HemangVora/OpenDuck/docs/amazon-list.md

# Open Duck Mini v2 — single Amazon.in list (replaces the local shopping trip)

All 33 listings checked live on **2026-11-02** with the delivery location set to **Mumbai 400076** (price, stock and delivery date). "Fastest" dates need the order placed the same evening and an Amazon-dispatched cart over ₹499. Prices include GST. Items marked *optional* are tools you may already own or Tier-3 extras.

Not in this list because they are already in the Hubtronics cart or already owned: capacitors, 2 mm and 4 mm heat-shrink, JST-XH 4-pin leads, flush cutter, SG90 servos, XY-3606 5 V buck, soldering iron, solder wire, microSD.

| # | Item | Qty | Link | Unit ₹ | Delivery | Note |
|---|---|---|---|---|---|---|
| 1 | Samsung 30Q 18650 cells (3 needed, 4 = matched set) | 4 | https://www.amazon.in/dp/B0HL8CRN1P | 489 | 7 Nov | Flat-top, unprotected. Check all 4 read within 0.05 V on arrival |
| 2 | 3S 40 A BMS with balance, same-port | 1 | https://www.amazon.in/dp/B0BJVPGDQ8 | 259 | 4 Nov (fastest 3 Nov) | Electronic Spices. Pads B-, B1, B2, B+, P- |
| 3 | iMax B6AC 80 W balance charger | 1 | https://www.amazon.in/dp/B07BRM5FCN | 2,469 | 8 Nov | Robocraze listing. Needs the 3S balance lead below |
| 4 | LiPo/Li-ion voltage alarm 1–8S | 1 | https://www.amazon.in/dp/B0F678VRR4 | 220 | 10 Nov | Set 3.5 V/cell warning |
| 5 | 18650 insulating rings + base mat | 1 | https://www.amazon.in/dp/B0CPSMC43L | 159 | 4 Nov (fastest 3 Nov) | Pack build safety |
| 6 | Inline mini-blade fuse holder + 5× 15 A fuses | 1 | https://www.amazon.in/dp/B0B7GPVB4X | 245 | 7 Nov | Wire ≥ 16 AWG |
| 7 | Toggle switch 12 V 20 A DC with safety cover | 1 | https://www.amazon.in/dp/B0B3Y229LV | 284 | 7 Nov | DC rated, the point of this one |
| 8 | XT30 connector pair, Robodo (buy 3 pairs) | 3 | https://www.amazon.in/dp/B0DWXRDJ3L | 131 | 4 Nov | Swapped 2 Nov: the 5-pair pack B0FTVN486X had 2 left and a 14 Nov date for 400076 |
| 9 | 16 AWG silicone wire, 1 m red + 1 m black | 1 | https://www.amazon.in/dp/B09CB833B7 | 420 | 7 Nov | Pack links, BMS to switch |
| 10 | 18 AWG silicone wire, 3 m red + 3 m black (INVENTO) | 1 | https://www.amazon.in/dp/B09VLCZNXN | 378 | 7 Nov | Swapped 2 Nov: B0HMWWMMGW was non-FBA, ₹80 delivery, 10 Nov for 400076 |
| 11 | 22 AWG hookup wire, 5 colours × 2 m | 1 | https://www.amazon.in/dp/B09D4RCKG8 | 170 | 10 Nov | IMU, foot switches, 5 V to Radxa |
| 12 | JST-XH 2.54 mm connector kit, 560 pcs | 1 | https://www.amazon.in/dp/B0FVLRZC6L | 599 | 6 Nov (fastest 4 Nov) | 2/3/4/5/6-pin housings + pins |
| 13 | JST-XH 3S balance lead, 20 cm, 22 AWG | 1 | https://www.amazon.in/dp/B0CV9JDKZ7 | 269 | 6 Nov | Pack to charger balance port |
| 14 | Heat-shrink assortment, 560 pcs, 2:1 | 1 | https://www.amazon.in/dp/B0DZXD1YLK | 311 | 6 Nov (fastest 5 Nov) | Covers 8–10 mm for XT30; Hubtronics cart has only 2 and 4 mm |
| 15 | Kapton tape 12 mm × 33 m | 1 | https://www.amazon.in/dp/B0DQYJ7569 | 139 | 7 Nov | IMU mount, insulation |
| 16 | 3M double-sided foam attachment tape | 1 | https://www.amazon.in/dp/B07WZRSYJM | 231 | 4–8 Nov | IMU and buck module |
| 17 | Nylon cable ties 100 × 2.5 mm, black | 1 | https://www.amazon.in/dp/B08GKPWLB9 | 79 | 10 Nov | Servo cable routing in the legs |
| 18 | FTDI FT232RL USB to TTL (3.3 V jumper) | 1 | https://www.amazon.in/dp/B072NDZL9K | 229 | 4 Nov (fastest 3 Nov) | Configure servos from the Mac. Set jumper to 3.3 V |
| 19 | M3 × 5 mm brass heat-set inserts, 100 pcs | 1 | https://www.amazon.in/dp/B0DZ8B7FW1 | 345 | 11 Nov | Ø4.0 holes. Local shops never have these |
| 20 | M3 socket-head screw kit, 600 pcs, 6–20 mm | 1 | https://www.amazon.in/dp/B0H7P7L5YS | 629 | 7 Nov | 12.9 black alloy |
| 21 | M3 nyloc nuts, 25 pcs, 304 SS | 1 | https://www.amazon.in/dp/B0GS6QRJZQ | 249 | 7 Nov |  |
| 22 | M2.5 × 8 mm socket screws + nuts + washers, 10 pcs | 1 | https://www.amazon.in/dp/B0FBX87PFZ | 180 | 7 Nov | Pick the M2.5x8mm variant on the page. Radxa mount; use the nuts as spacers |
| 23 | 6804ZZ bearing 20×32×7, 2-pack (need 3) | 2 | https://www.amazon.in/dp/B071HL4RLN | 299 | 7 Nov | ONLY 2 PACKS LEFT on 2 Nov. Order first |
| 24 | Loctite 243 blue, 50 ml (genuine Henkel) | 1 | https://www.amazon.in/dp/B014MMG3AM | 627 | 6 Nov (fastest 3 Nov) | Blue only, never red 271 |
| 25 | Hex key set 1.5–6 mm, Deli DL3080 | 1 | https://www.amazon.in/dp/B0D948XF49 | 209 | 10 Nov | Needs 1.5, 2.0, 2.5 mm |
| 26 | Needle file set, 6 pcs with handle | 1 | https://www.amazon.in/dp/B07TBRR4K3 | 436 | 6 Nov (fastest 5 Nov) | Print edges, foot switch slots. Alt: deburring kit B0H45JPKYB ₹350 |
| 27 | Desoldering wick 2 mm × 1.5 m | 1 | https://www.amazon.in/dp/B07C4QD77P | 269 | 10 Nov |  |
| 28 | Precision screwdriver set 27-in-1, Themisto | 1 | https://www.amazon.in/dp/B07NY2WXPH | 249 | 4 Nov (fastest 3 Nov) |  |
| 29 | ESD tweezers set, 6 pcs (HASTHIP) | 1 | https://www.amazon.in/dp/B0BDYG14V6 | 272 | 4 Nov (fastest 3 Nov) | Price from search results, not re-checked on the product page |
| 30 | *Digital vernier calliper 150 mm (Vinabo)* (optional) | 1 | https://www.amazon.in/dp/B0BDLX8DWG | 399 | 6 Nov (fastest 5 Nov) | Skip if you own one. Check Ø4.0 insert holes and first print |
| 31 | *Digital multimeter Themisto TH-M98, 10 A DC* (optional) | 1 | https://www.amazon.in/dp/B097RS212G | 712 | 6 Nov (fastest 3 Nov) | Skip if you own one. Needed to set the buck and check pack polarity |
| 32 | *M2.5 brass standoffs 5 + 6 mm, 20 pcs (YOKIVE)* (optional) | 1 | https://www.amazon.in/dp/B0BK9CG9S4 | 332 | 10 Nov | Only if you want the Radxa lifted on proper standoffs; slow delivery |
| 33 | *INA226 current/voltage monitor* (optional) | 1 | https://www.amazon.in/dp/B0D2DPY2SB | 426 | 7 Nov | Tier 3: real walking-current data, software low-battery cutoff |

**Core total (items 1–29): ₹12,873.** Optional items 30–33 add ₹1,869. Everything: ₹14,742.

## Order notes

- Order the **6804ZZ bearings first**: the listing showed "Only 2 left in stock" and you need both packs.
- The 18650 cells ship by Amazon's own ground logistics; no air-shipment problem, unlike the Hubtronics parcel.
- Most items are Amazon-dispatched (FBA) with free delivery only on a ₹499+ FBA cart; one combined order clears that easily.
- On the M2.5 screw page choose the **M2.5x8mm** size; the default variant is 4 mm.
- Set the FTDI board's jumper to **3.3 V** before touching the servo adapter.
- For 400076: by 4 Nov the BMS, rings, FTDI, XT30, screwdrivers, tweezers (3 Nov if ordered the same evening); by 6 Nov JST kit, balance lead, heat-shrink, Loctite, files; by 7 Nov cells, fuse, switch, both silicone wires, Kapton, M3 kit, nyloc, M2.5, bearings; 8 Nov charger; 10 Nov alarm, 22 AWG, ties, hex keys, wick; 11 Nov inserts (last).
- Source lists: `local-shopping-list.md` (specs and counter checks still apply when the parcel arrives) and `shopping-list.md`.
