HemangVora/OpenDuck/cad/microduck/previews/body_asm_below.png

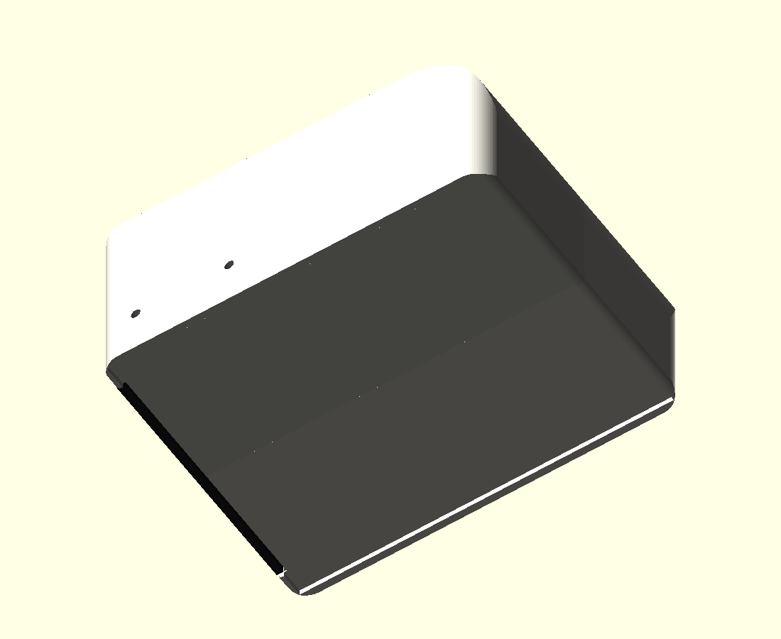
cad/microduck/previews/body_asm_below.png
