HemangVora/OpenDuck/cad/microduck/previews/body_asm_front.png

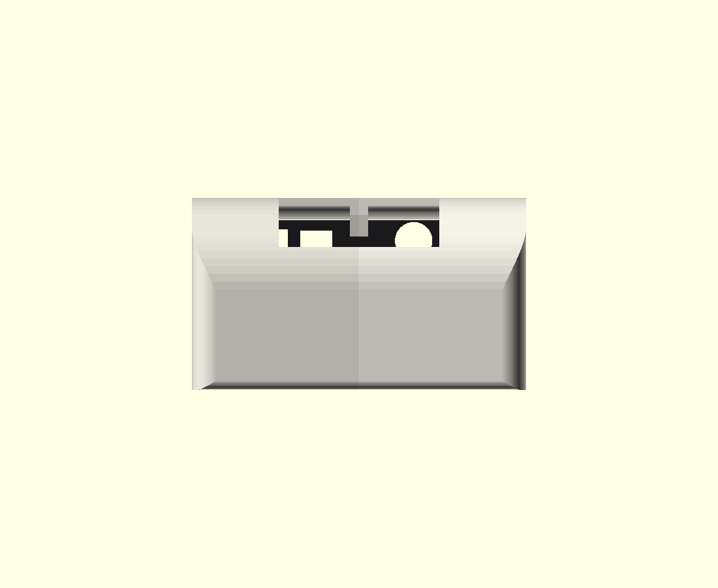
cad/microduck/previews/body_asm_front.png
