HemangVora/OpenDuck/cad/microduck/previews/body_asm_iso.png

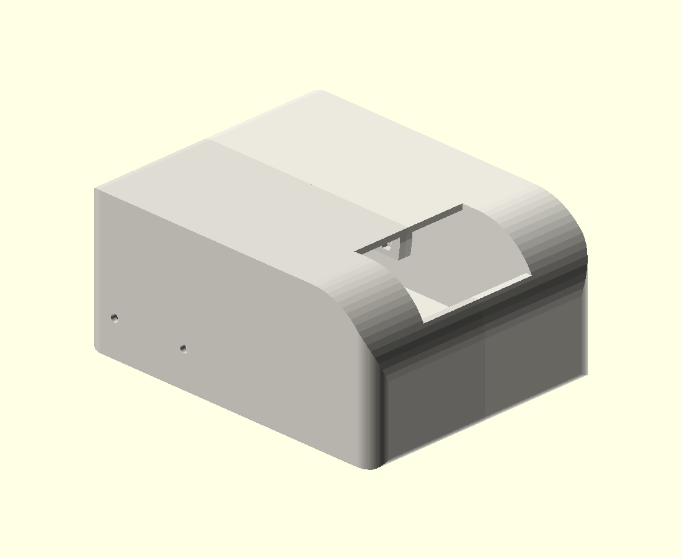
cad/microduck/previews/body_asm_iso.png
