HemangVora/OpenDuck/cad/microduck/previews/body_asm_rear.png

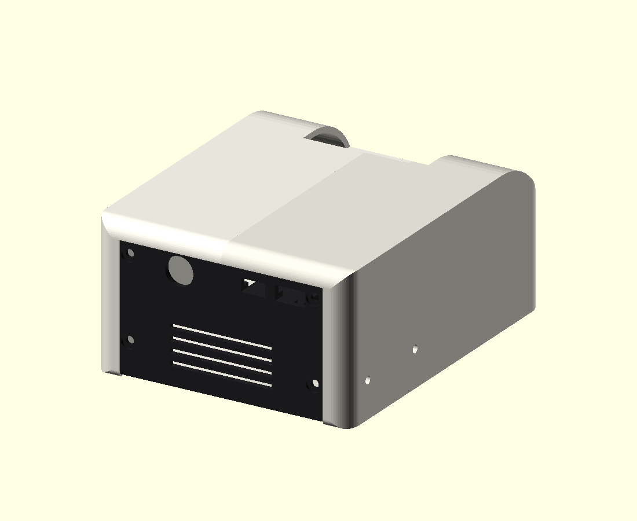
cad/microduck/previews/body_asm_rear.png
