HemangVora/OpenDuck/cad/microduck/previews/body_asm_side.png

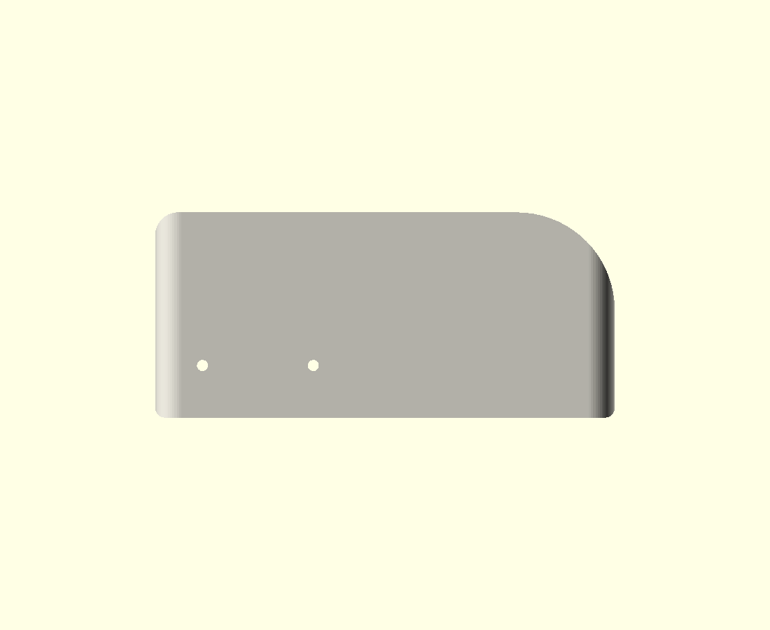
cad/microduck/previews/body_asm_side.png
