HemangVora/OpenDuck/cad/microduck/previews/body_asm_top.png

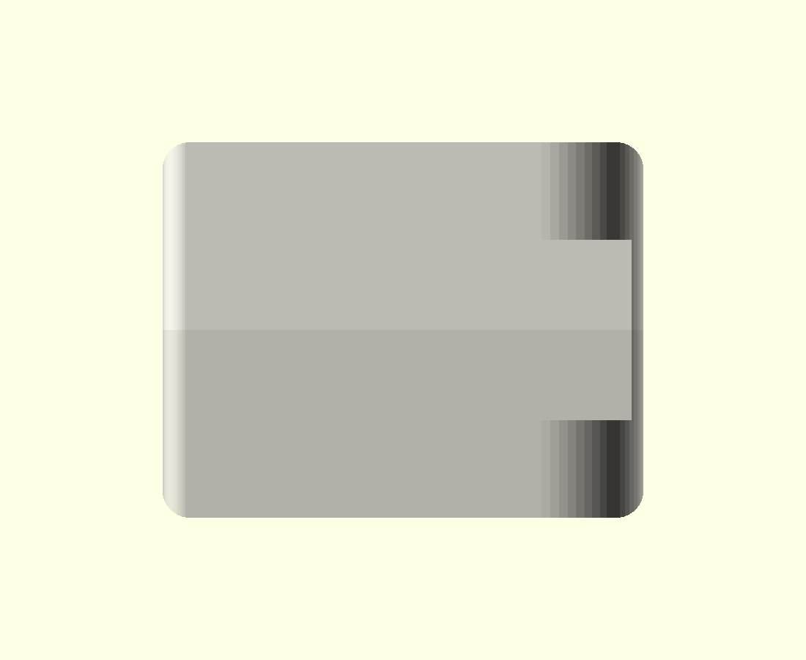
cad/microduck/previews/body_asm_top.png
