HemangVora/OpenDuck/cad/microduck/previews/body_inside_iso.png

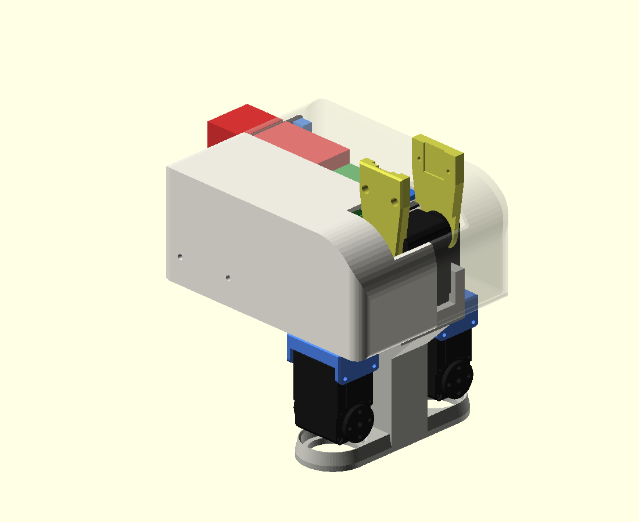
cad/microduck/previews/body_inside_iso.png
