HemangVora/OpenDuck/cad/microduck/previews/body_inside_rear.png

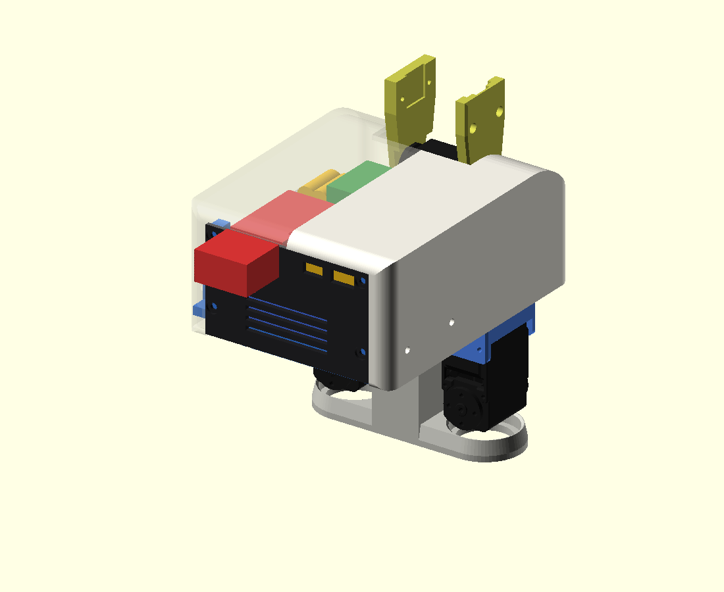
cad/microduck/previews/body_inside_rear.png
