HemangVora/OpenDuck/cad/microduck/previews/body_inside_side.png

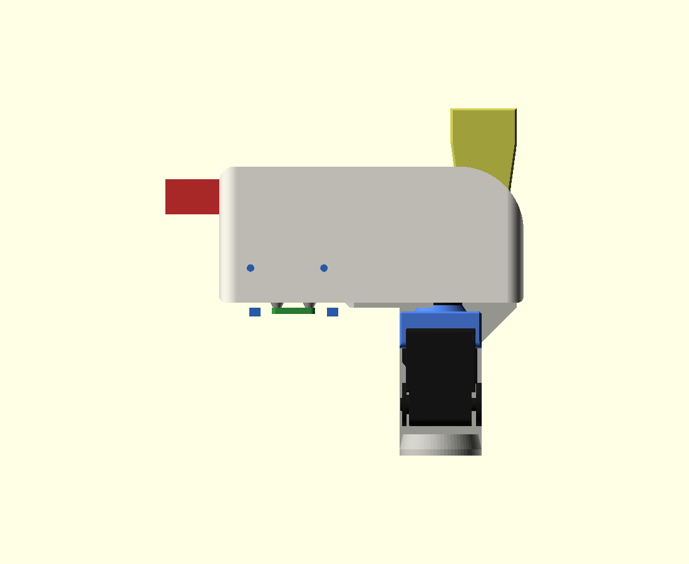
cad/microduck/previews/body_inside_side.png
