HemangVora/OpenDuck/cad/microduck/previews/body_inside_top.png

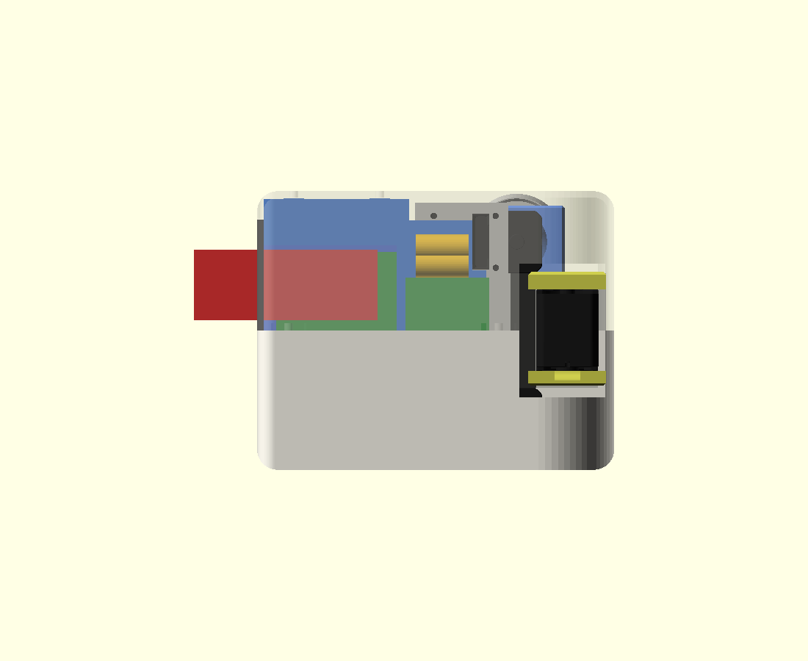
cad/microduck/previews/body_inside_top.png
