HemangVora/OpenDuck/cad/microduck/previews/chassis_below.png

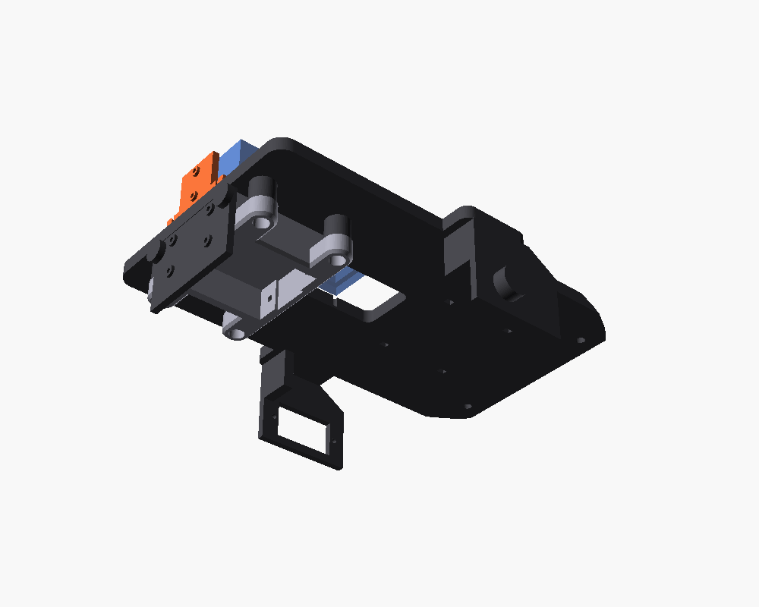
cad/microduck/previews/chassis_below.png
