HemangVora/OpenDuck/cad/microduck/previews/chassis_iso.png

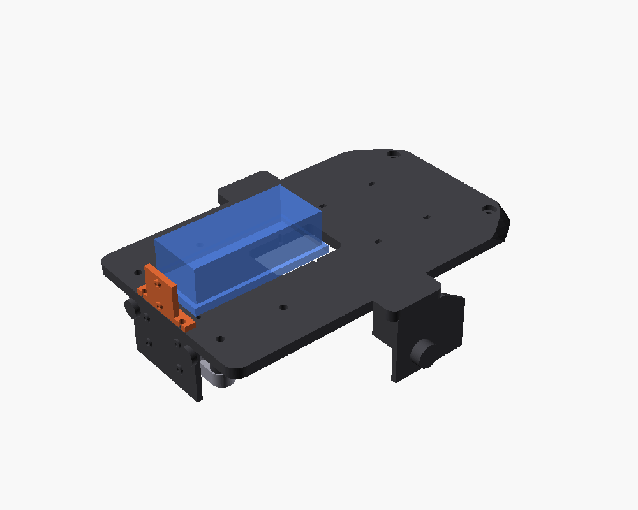
cad/microduck/previews/chassis_iso.png
