HemangVora/OpenDuck/cad/microduck/previews/compare/ours_34front.png

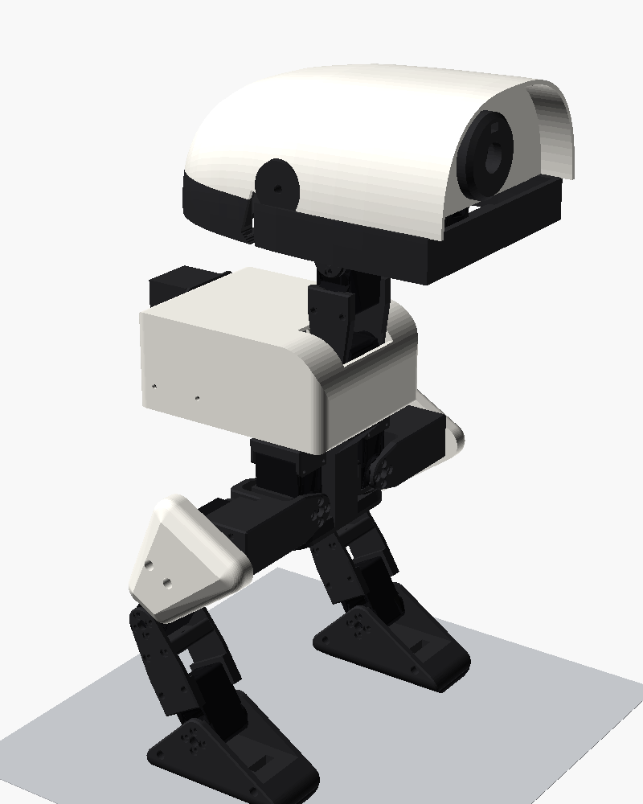
cad/microduck/previews/compare/ours_34front.png
