HemangVora/OpenDuck/cad/microduck/previews/compare/ref_34front.png

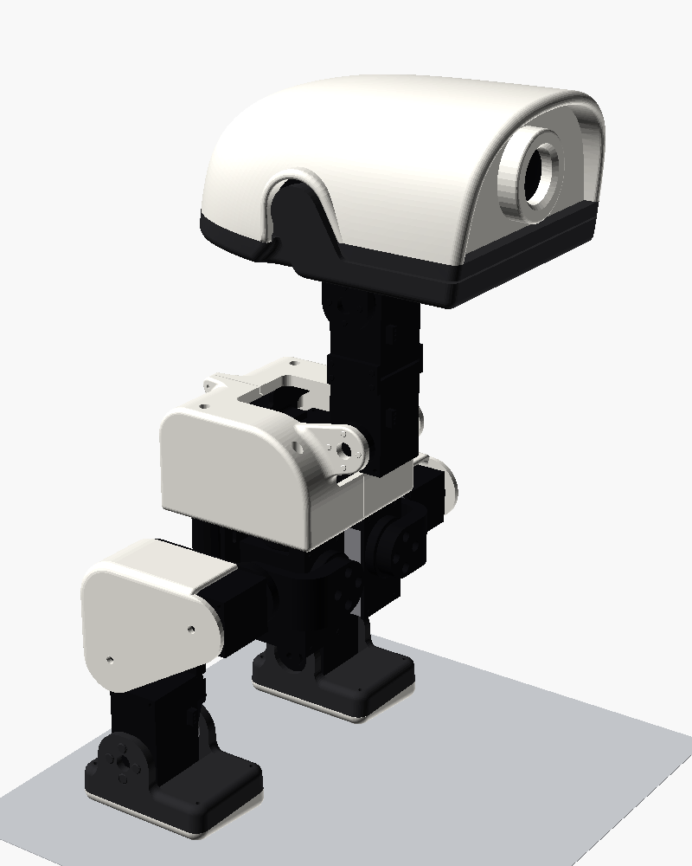
cad/microduck/previews/compare/ref_34front.png
