HemangVora/OpenDuck/cad/microduck/previews/compare/ref_side.png

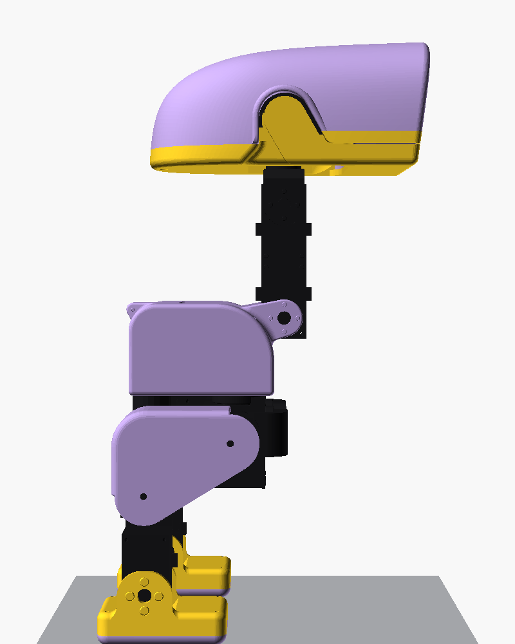
cad/microduck/previews/compare/ref_side.png
