HemangVora/OpenDuck/cad/microduck/previews/foot/md_front.png

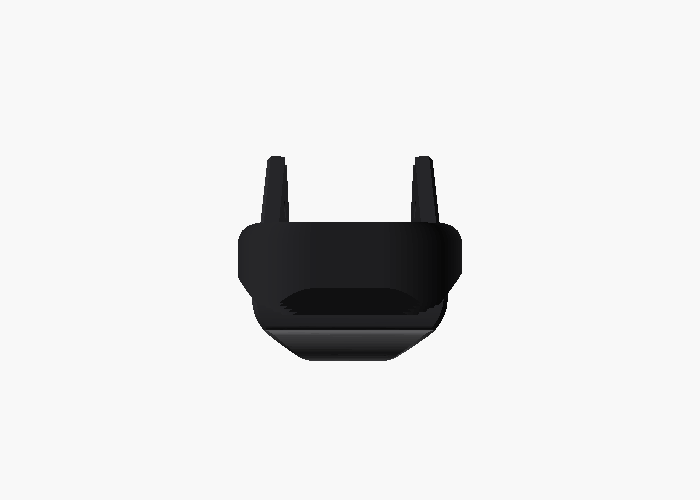
cad/microduck/previews/foot/md_front.png
