HemangVora/OpenDuck/cad/microduck/previews/foot/md_iso2.png

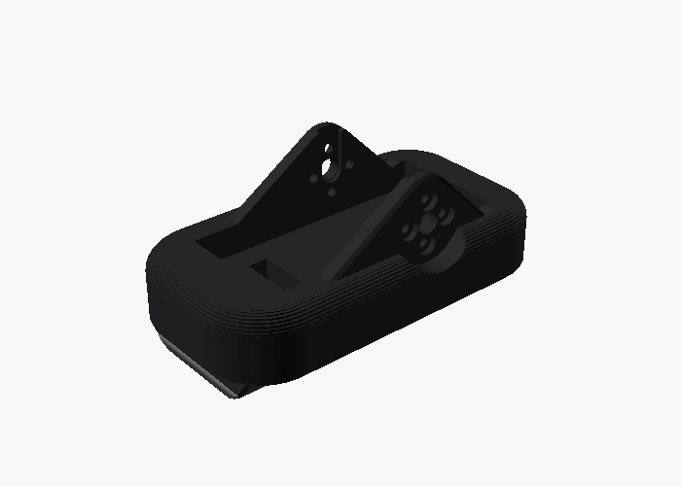
cad/microduck/previews/foot/md_iso2.png
