HemangVora/OpenDuck/cad/microduck/previews/foot/md_side.png

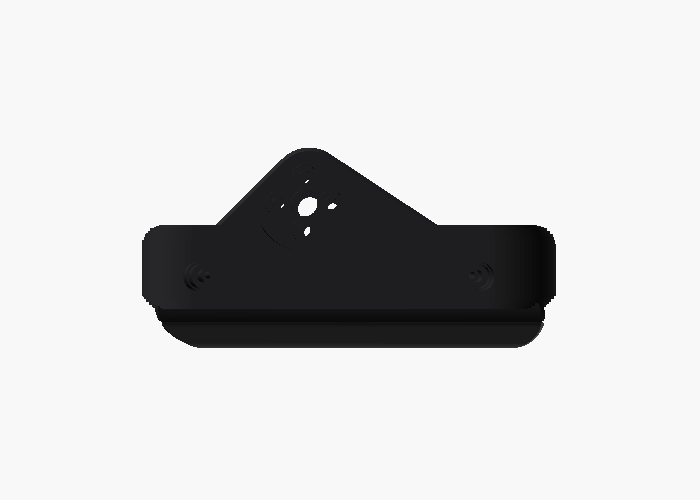
cad/microduck/previews/foot/md_side.png
