HemangVora/OpenDuck/cad/microduck/previews/foot/md_top.png

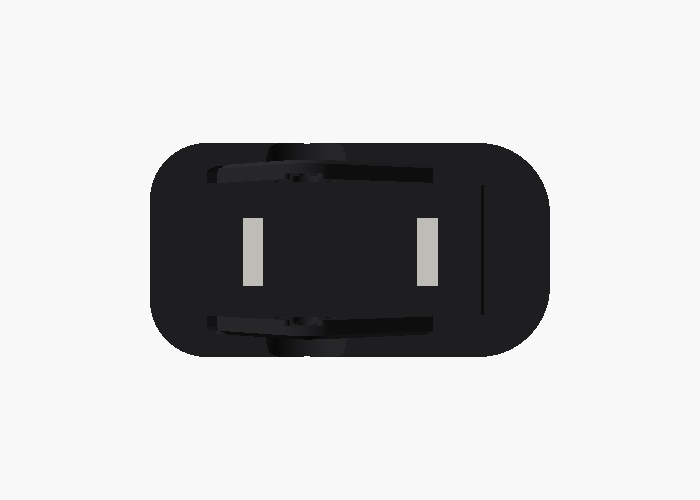
cad/microduck/previews/foot/md_top.png
