HemangVora/OpenDuck/cad/microduck/previews/foot/stock_iso2.png

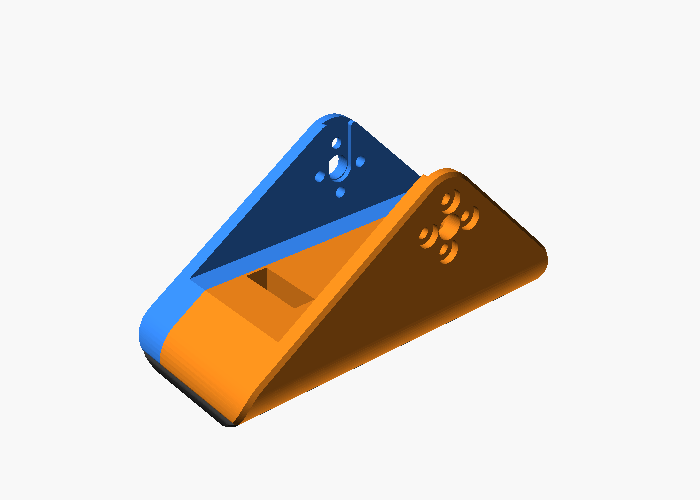
cad/microduck/previews/foot/stock_iso2.png
