HemangVora/OpenDuck/cad/microduck/previews/foot/stock_iso.png

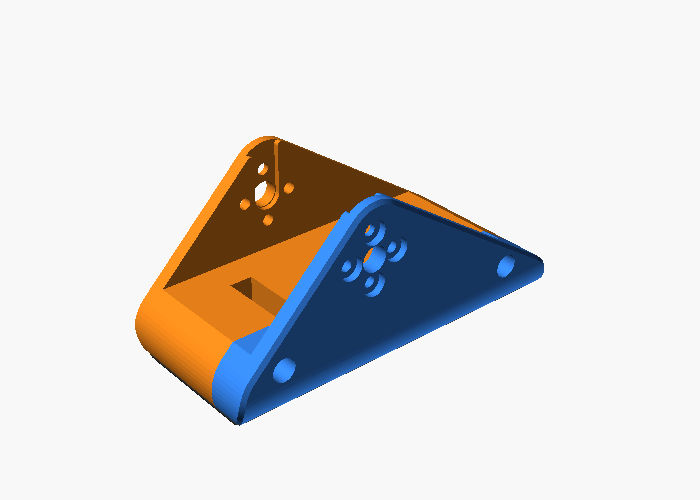
cad/microduck/previews/foot/stock_iso.png
