HemangVora/OpenDuck/cad/microduck/previews/foot/stock_side.png

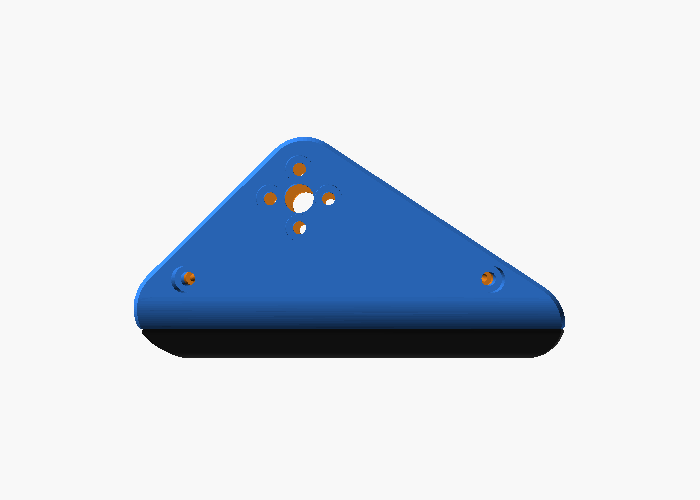
cad/microduck/previews/foot/stock_side.png
