HemangVora/OpenDuck/cad/microduck/previews/full/crouch_34front.png

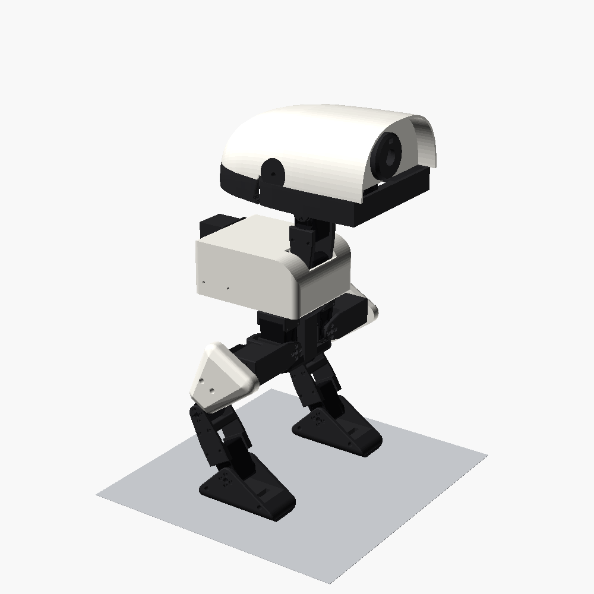
cad/microduck/previews/full/crouch_34front.png
