HemangVora/OpenDuck/cad/microduck/previews/full/crouch_34rear.png

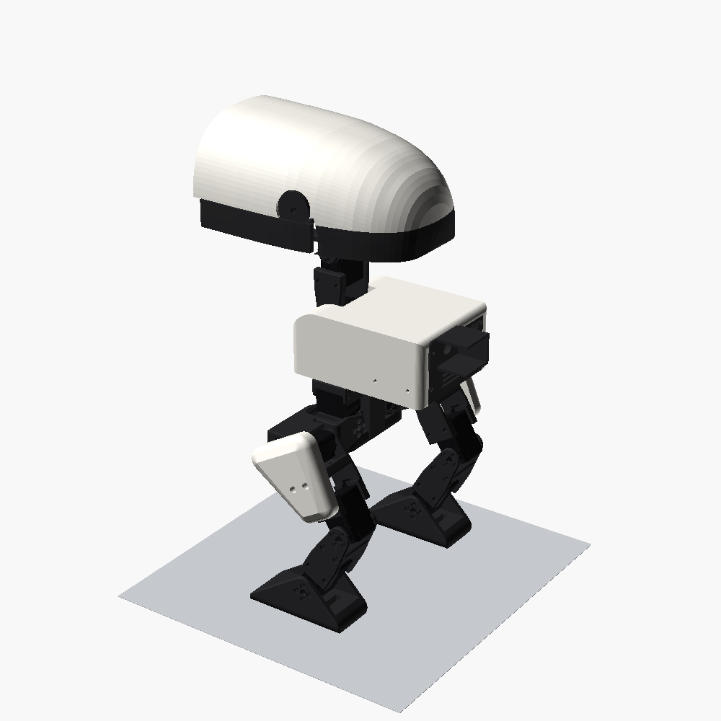
cad/microduck/previews/full/crouch_34rear.png
