HemangVora/OpenDuck/cad/microduck/previews/full/crouch_back.png

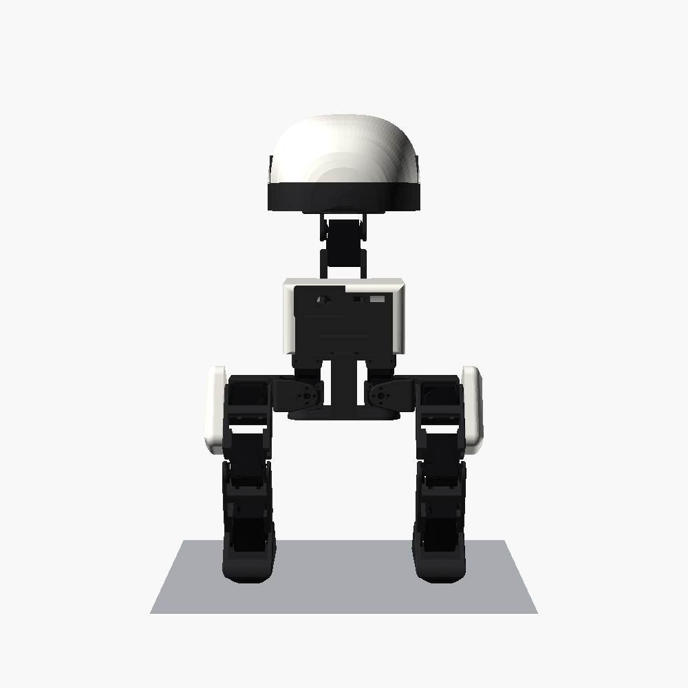
cad/microduck/previews/full/crouch_back.png
