HemangVora/OpenDuck/cad/microduck/previews/full/crouch_face_close.png

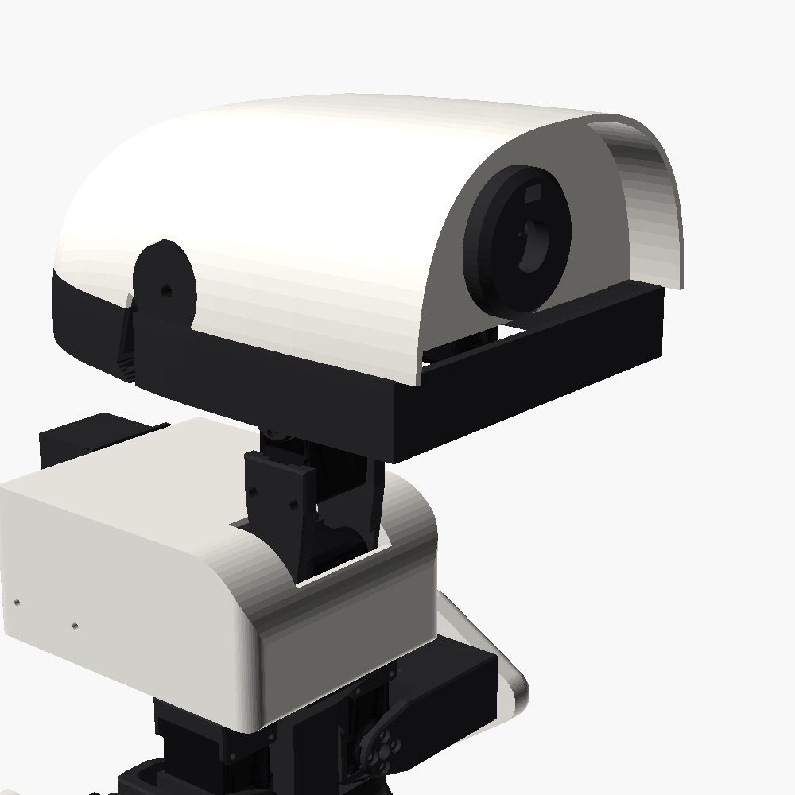
cad/microduck/previews/full/crouch_face_close.png
