HemangVora/OpenDuck/cad/microduck/previews/full/crouch_side.png

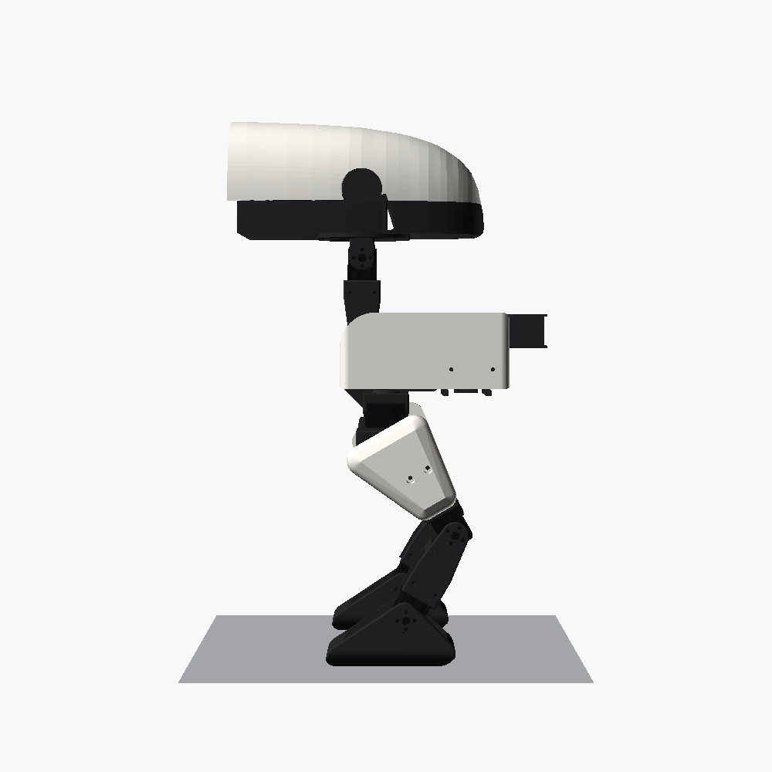
cad/microduck/previews/full/crouch_side.png
