HemangVora/OpenDuck/cad/microduck/previews/full/head_close_34.png

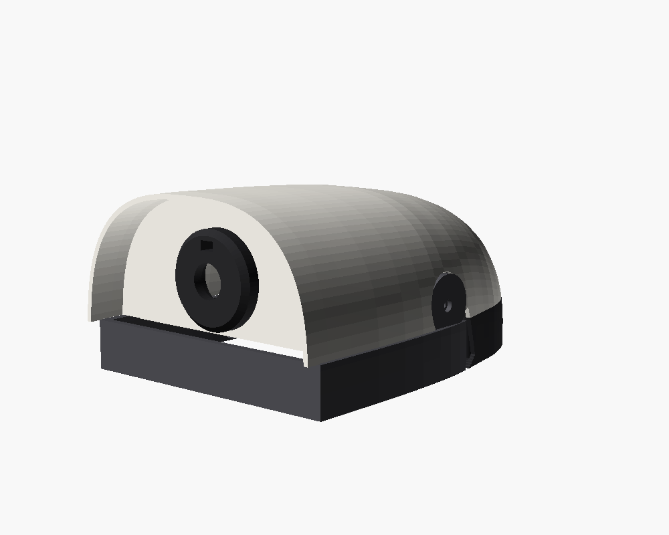
cad/microduck/previews/full/head_close_34.png
