HemangVora/OpenDuck/cad/microduck/previews/full/head_close_side.png

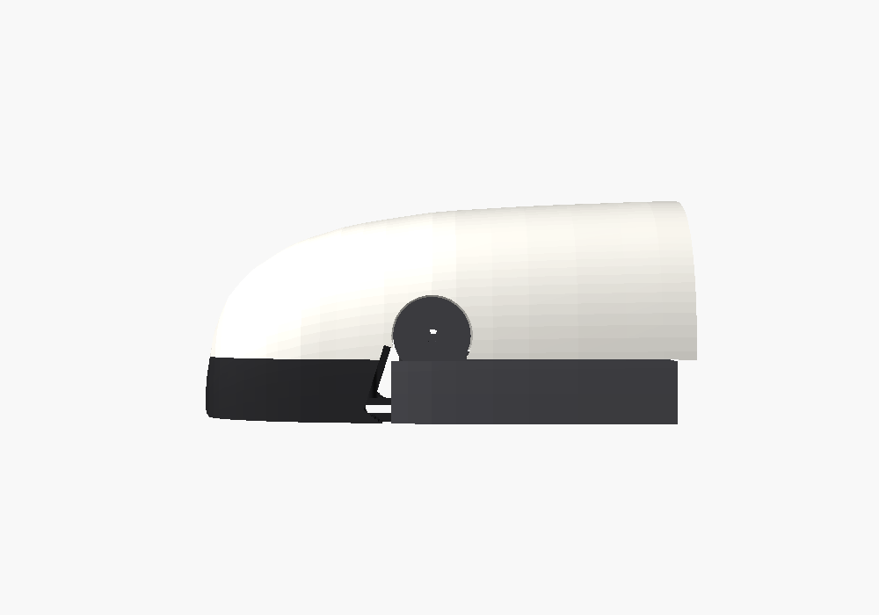
cad/microduck/previews/full/head_close_side.png
