HemangVora/OpenDuck/cad/microduck/previews/full/head_inside_check.png

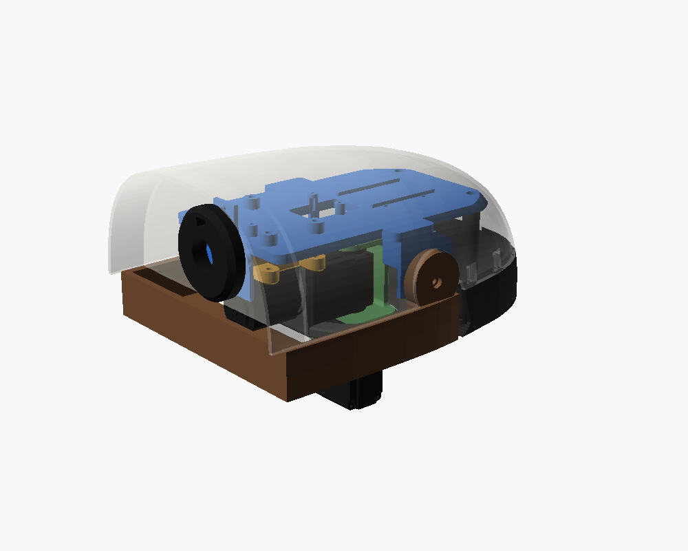
cad/microduck/previews/full/head_inside_check.png
