HemangVora/OpenDuck/cad/microduck/previews/head_asm_below.png

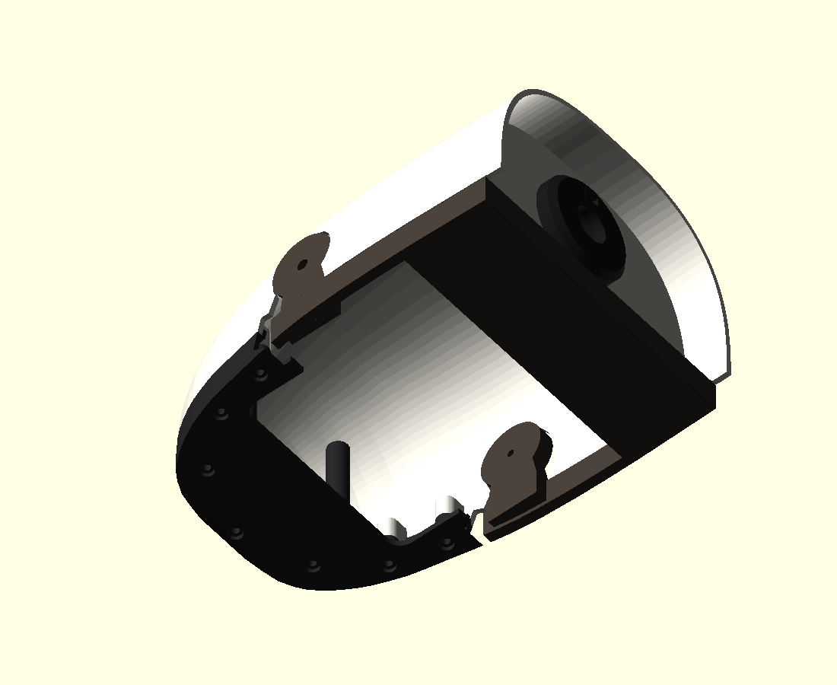
cad/microduck/previews/head_asm_below.png
