HemangVora/OpenDuck/cad/microduck/previews/head_asm_front.png

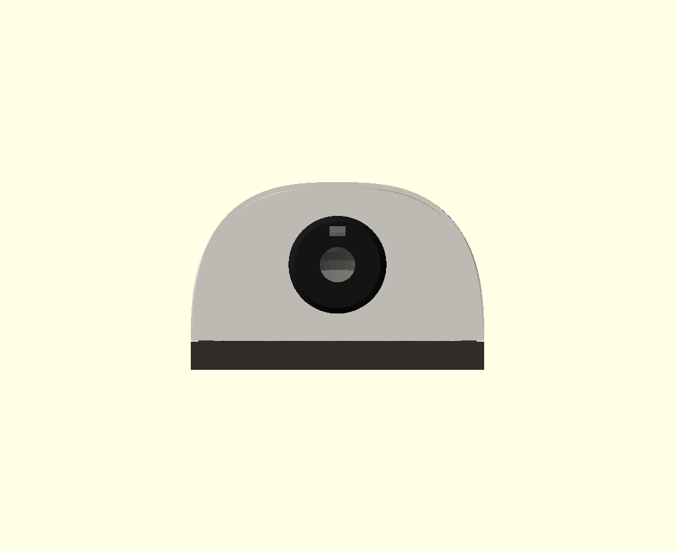
cad/microduck/previews/head_asm_front.png
