HemangVora/OpenDuck/cad/microduck/previews/head_asm_iso.png

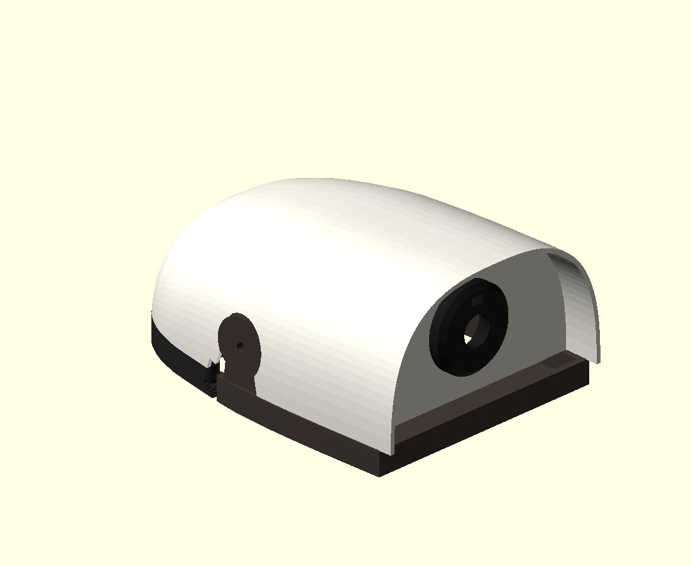
cad/microduck/previews/head_asm_iso.png
