HemangVora/OpenDuck/cad/microduck/previews/head_asm_rear.png

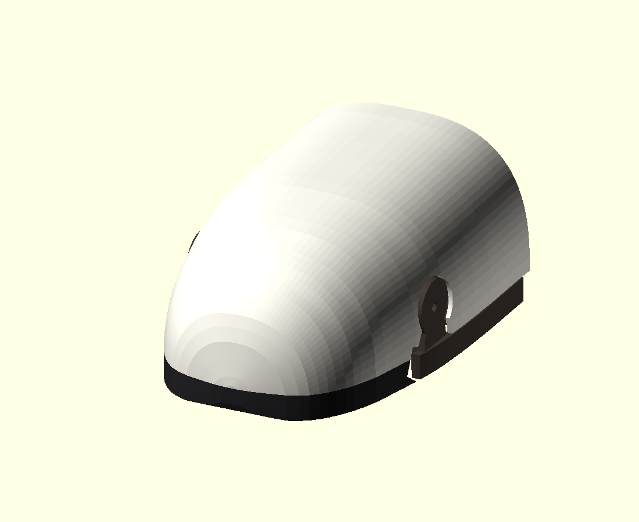
cad/microduck/previews/head_asm_rear.png
