HemangVora/OpenDuck/cad/microduck/previews/head_asm_side.png

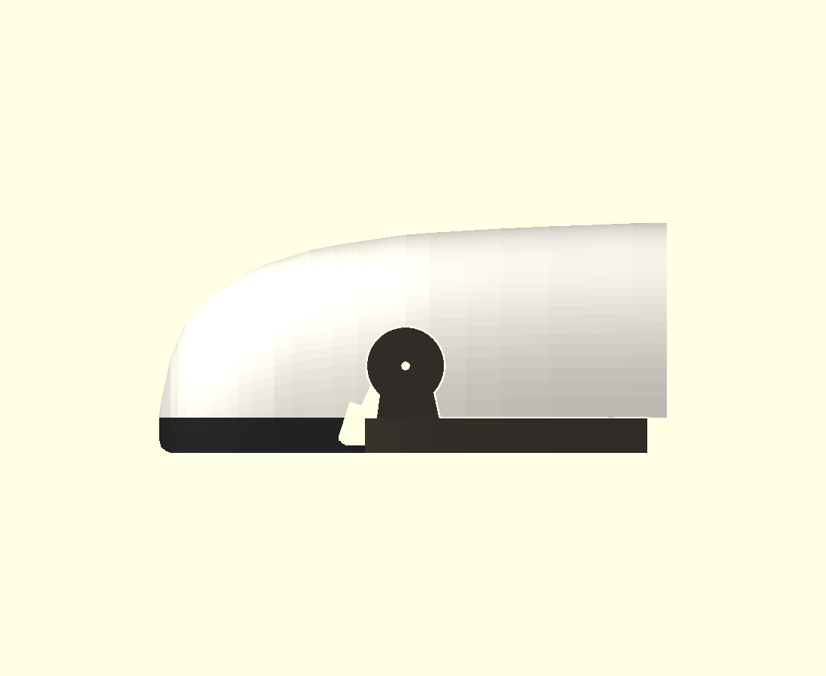
cad/microduck/previews/head_asm_side.png
