HemangVora/OpenDuck/cad/microduck/previews/head_asm_top.png

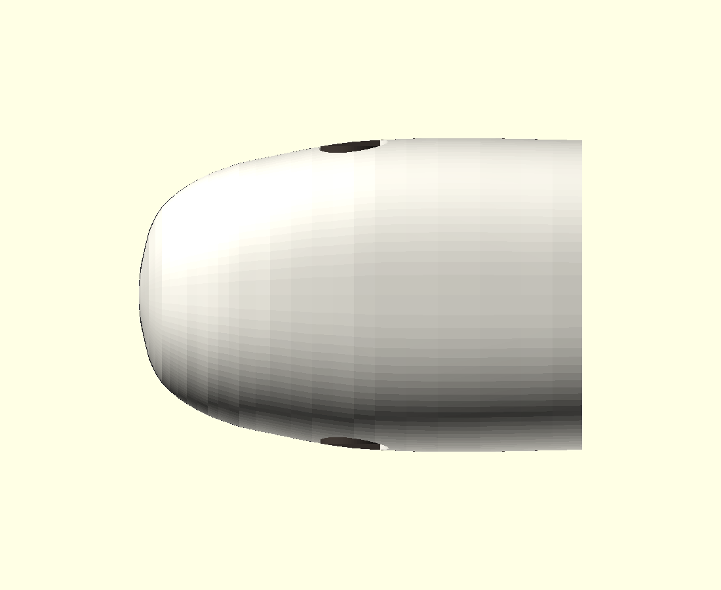
cad/microduck/previews/head_asm_top.png
