HemangVora/OpenDuck/cad/microduck/previews/head_inside_iso.png

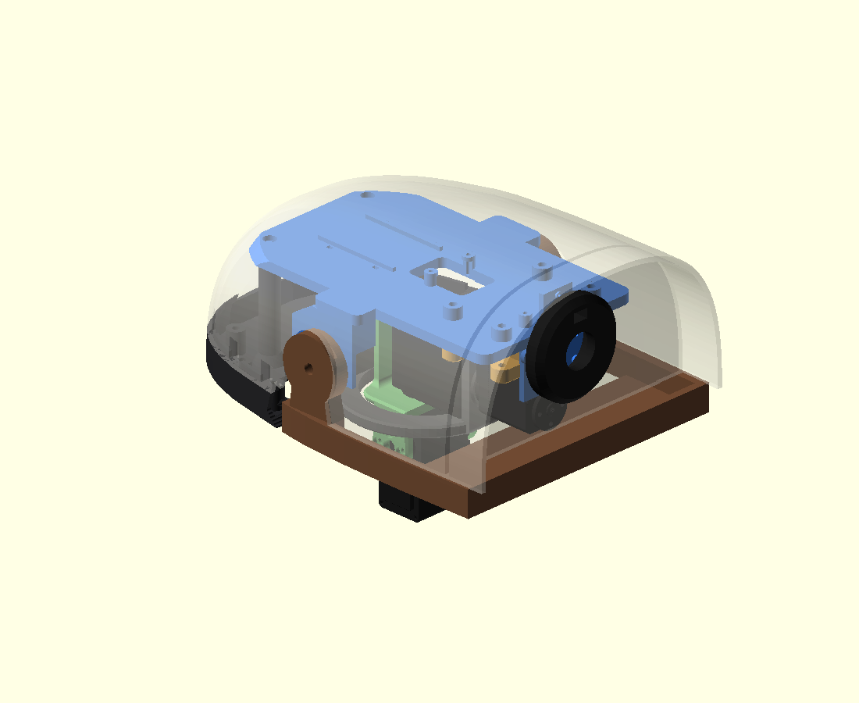
cad/microduck/previews/head_inside_iso.png
