HemangVora/OpenDuck/cad/microduck/previews/head_inside_isob.png

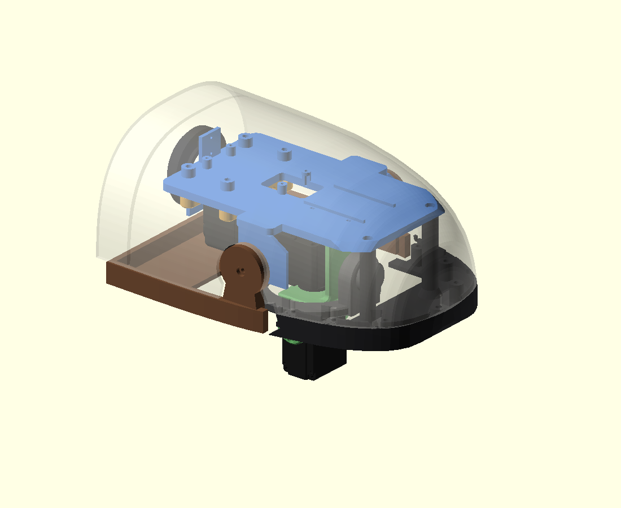
cad/microduck/previews/head_inside_isob.png
