HemangVora/OpenDuck/cad/microduck/previews/head_inside_side.png

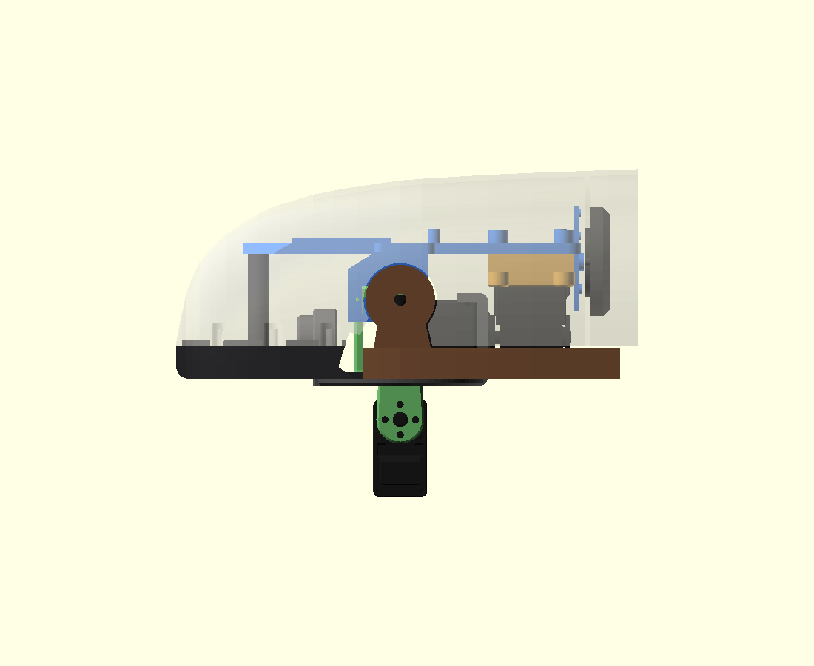
cad/microduck/previews/head_inside_side.png
