HemangVora/OpenDuck/cad/microduck/previews/leg_pillow_front.png

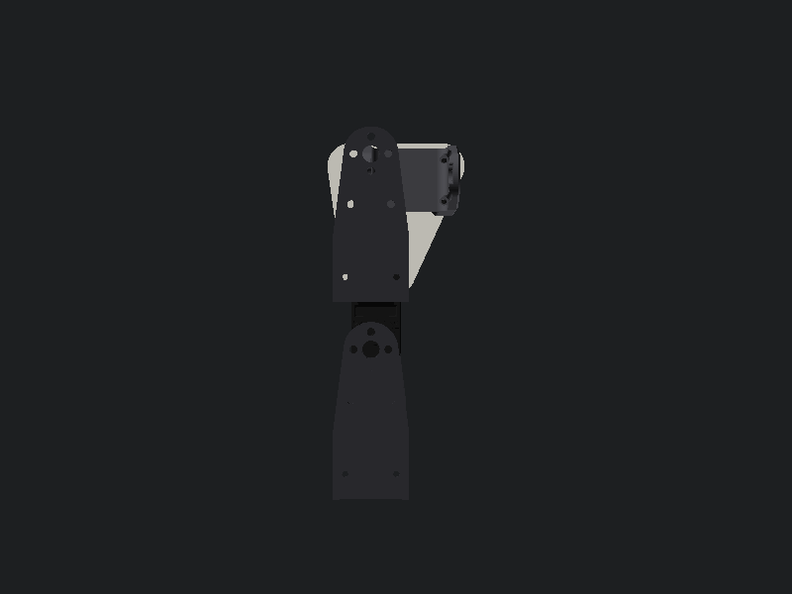
cad/microduck/previews/leg_pillow_front.png
