HemangVora/OpenDuck/cad/microduck/previews/leg_pillow_iso.png

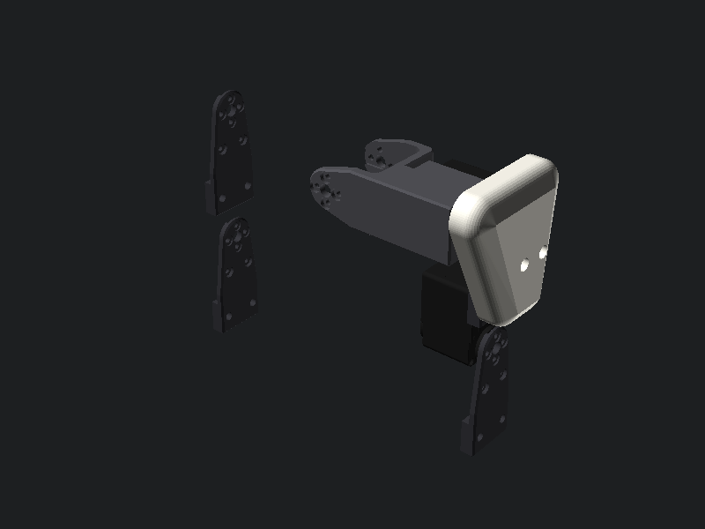
cad/microduck/previews/leg_pillow_iso.png
