HemangVora/OpenDuck/cad/microduck/previews/leg_pillow_side.png

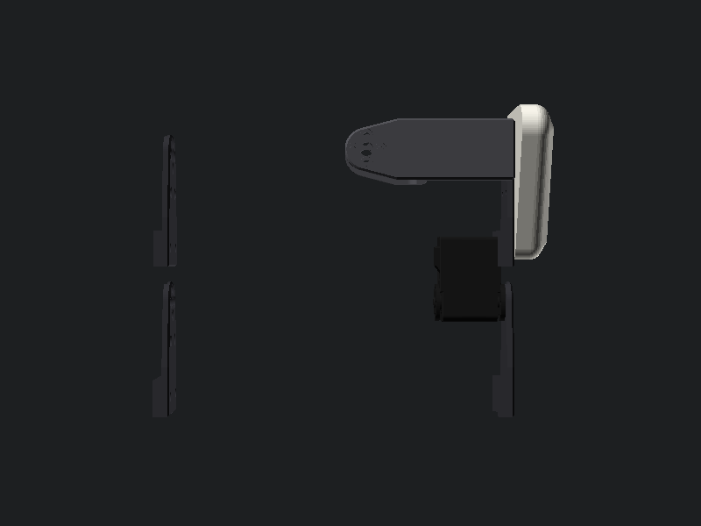
cad/microduck/previews/leg_pillow_side.png
