HemangVora/OpenDuck/cad/microduck/previews/tray_below.png

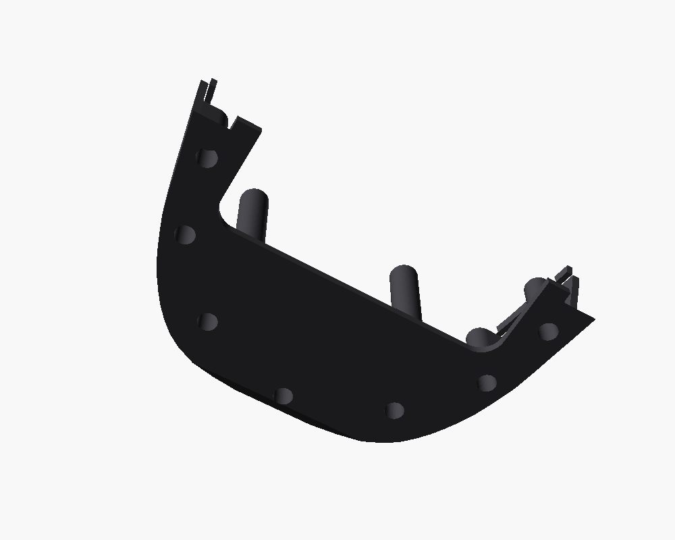
cad/microduck/previews/tray_below.png
