HemangVora/OpenDuck/cad/microduck/previews/tray_iso.png

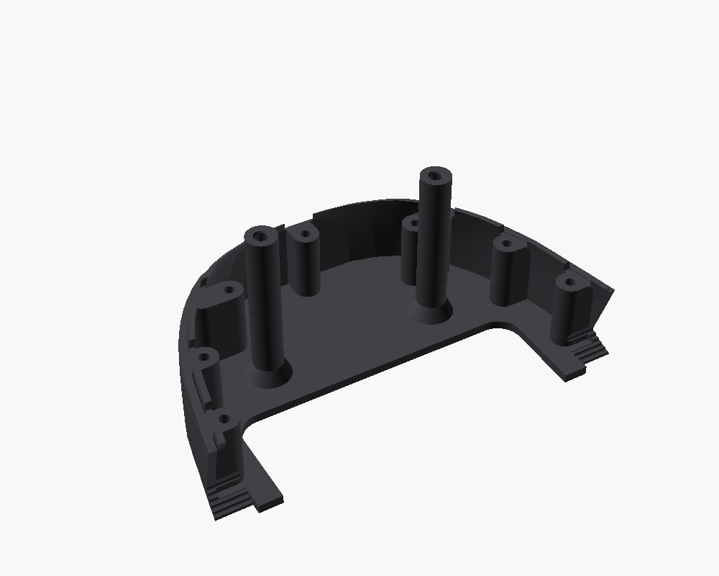
cad/microduck/previews/tray_iso.png
