HemangVora/OpenDuck/cad/microduck/previews/v3/duck_front.png

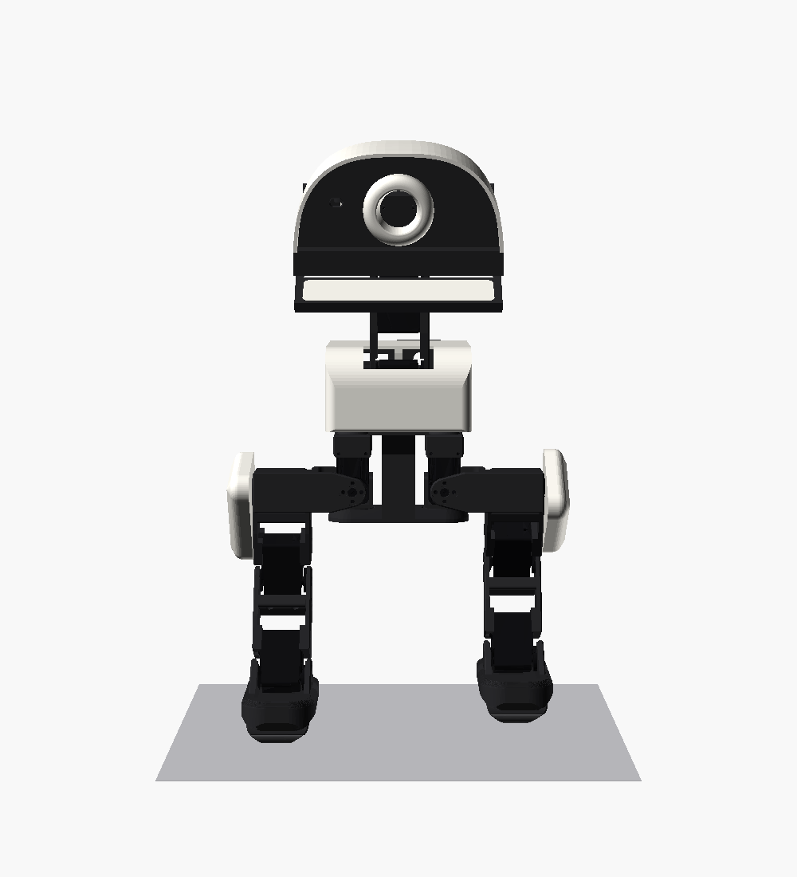
cad/microduck/previews/v3/duck_front.png
