HemangVora/OpenDuck/cad/microduck/previews/v3/duck_rear34.png

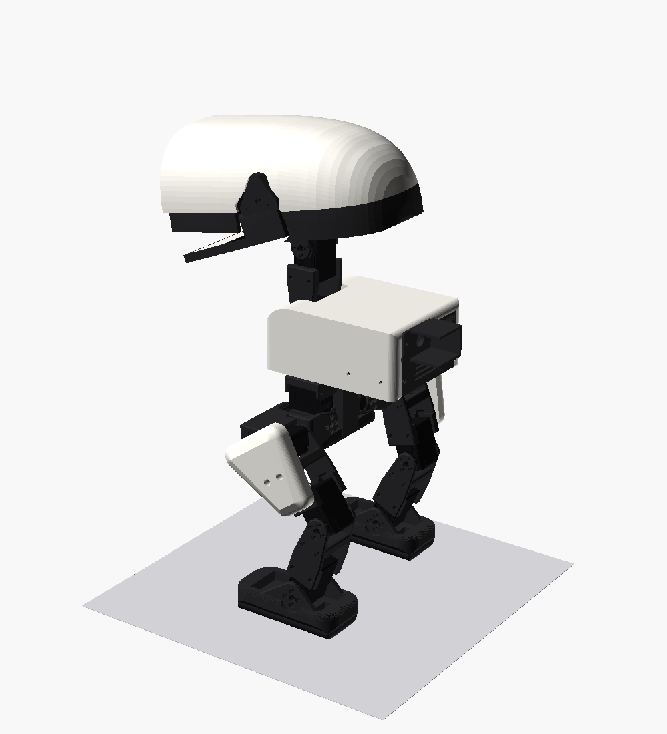
cad/microduck/previews/v3/duck_rear34.png
