HemangVora/OpenDuck/cad/microduck/previews/v3/duck_side.png

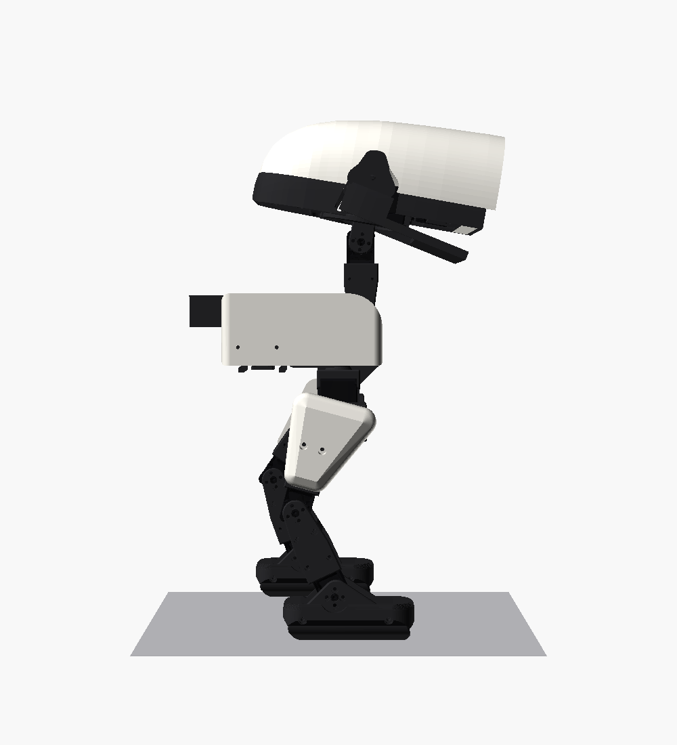
cad/microduck/previews/v3/duck_side.png
