HemangVora/OpenDuck/cad/microduck/previews/v3/head_34.png

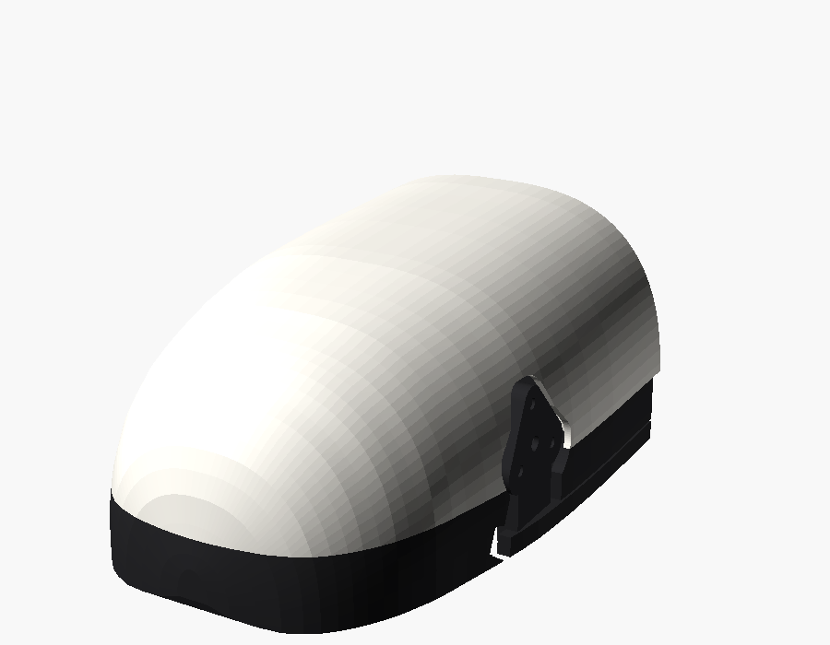
cad/microduck/previews/v3/head_34.png
