HemangVora/OpenDuck/cad/microduck/previews/v3/head_34l.png

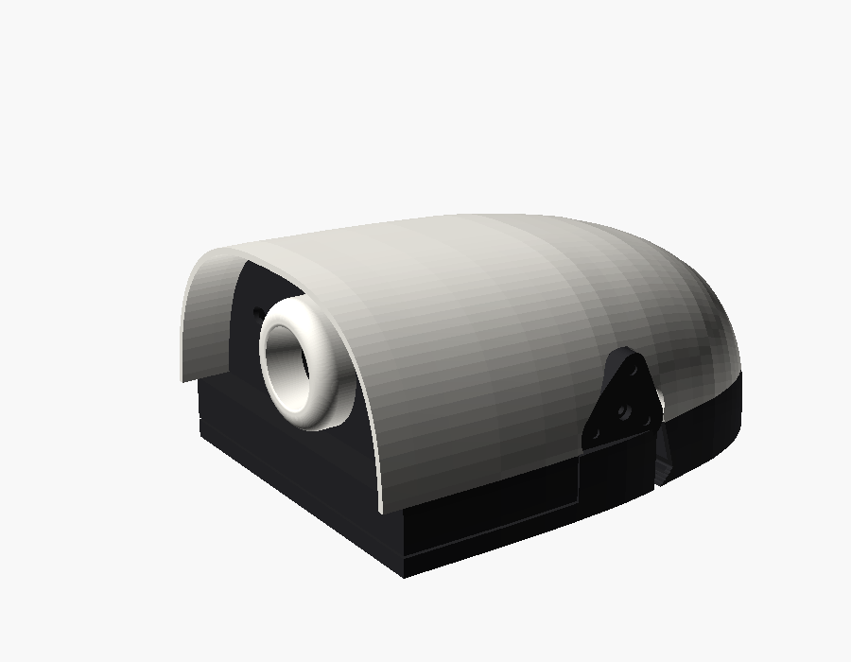
cad/microduck/previews/v3/head_34l.png
