HemangVora/OpenDuck/cad/microduck/previews/v3/head_34r.png

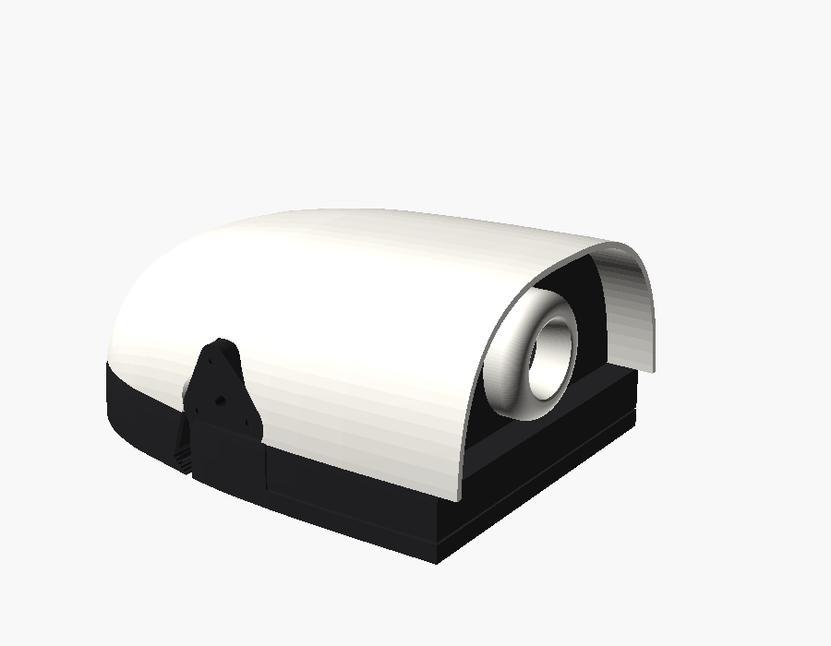
cad/microduck/previews/v3/head_34r.png
