HemangVora/OpenDuck/cad/microduck/previews/v3/head_34r_open.png

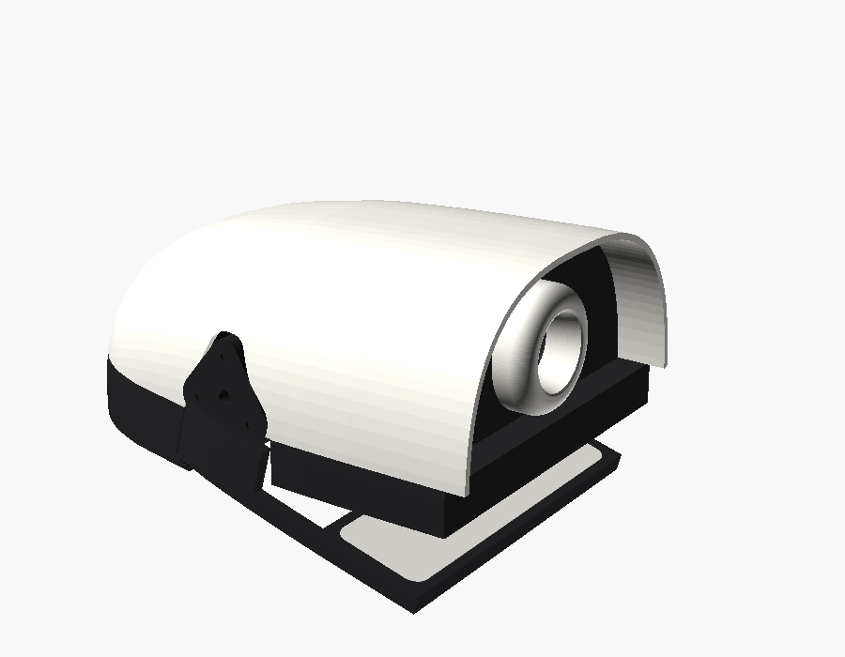
cad/microduck/previews/v3/head_34r_open.png
