HemangVora/OpenDuck/cad/microduck/previews/v3/head_front.png

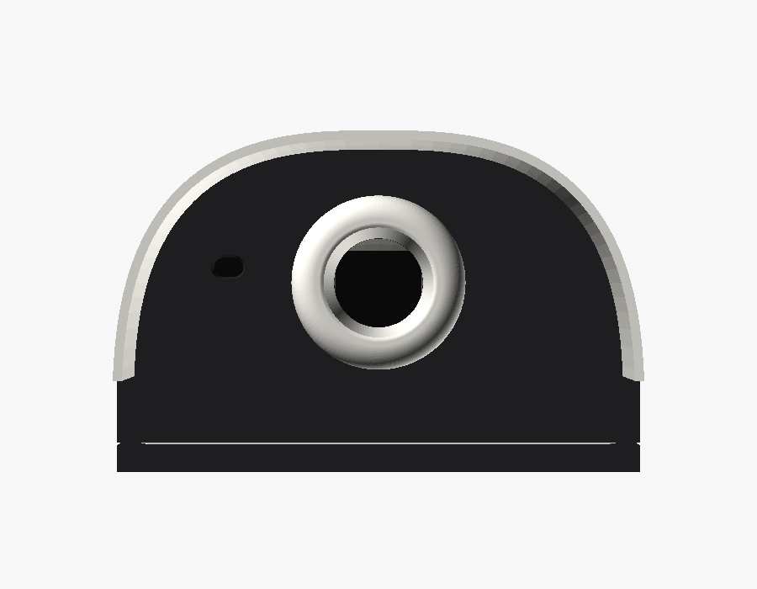
cad/microduck/previews/v3/head_front.png
