HemangVora/OpenDuck/cad/microduck/previews/v3/head_side.png

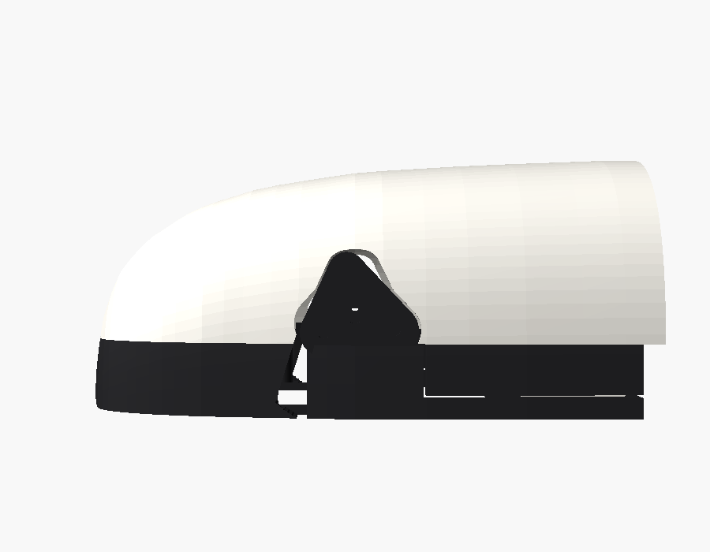
cad/microduck/previews/v3/head_side.png
