HemangVora/OpenDuck/docs/microduck_look/back_v4_inside.png

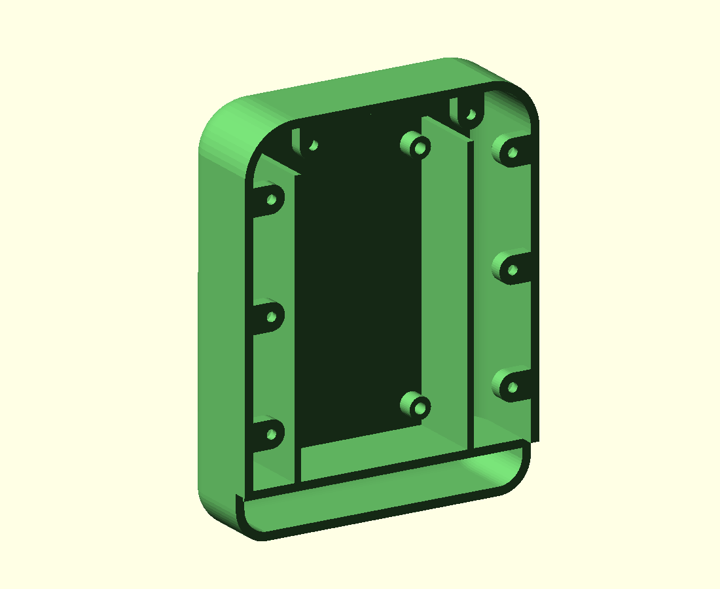
docs/microduck_look/back_v4_inside.png
