HemangVora/OpenDuck/docs/microduck_look/body_v3_back.png

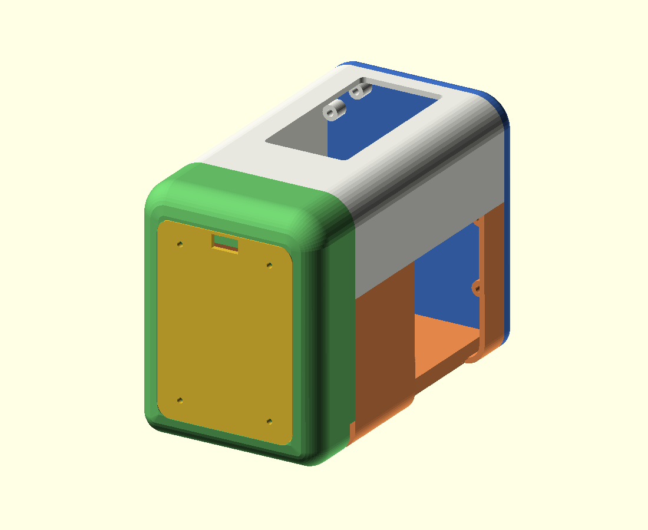
docs/microduck_look/body_v3_back.png
