HemangVora/OpenDuck/docs/microduck_look/body_v3_bottom.png

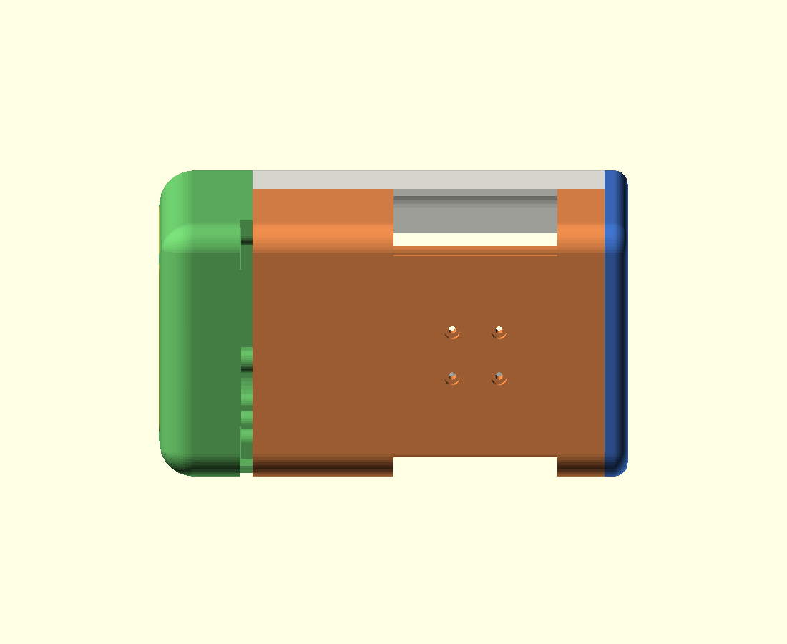
docs/microduck_look/body_v3_bottom.png
