HemangVora/OpenDuck/docs/microduck_look/body_v3_front.png

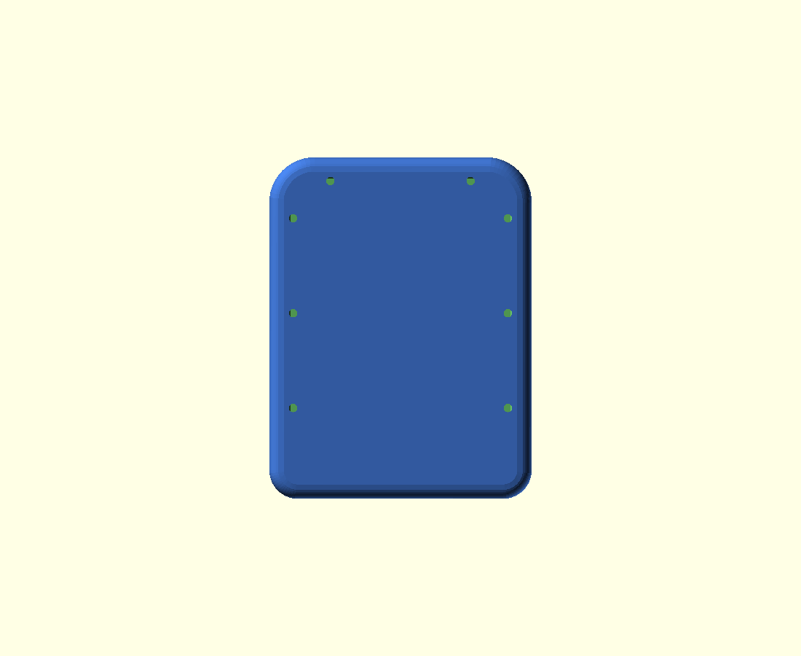
docs/microduck_look/body_v3_front.png
