HemangVora/OpenDuck/docs/microduck_look/body_v3_iso.png

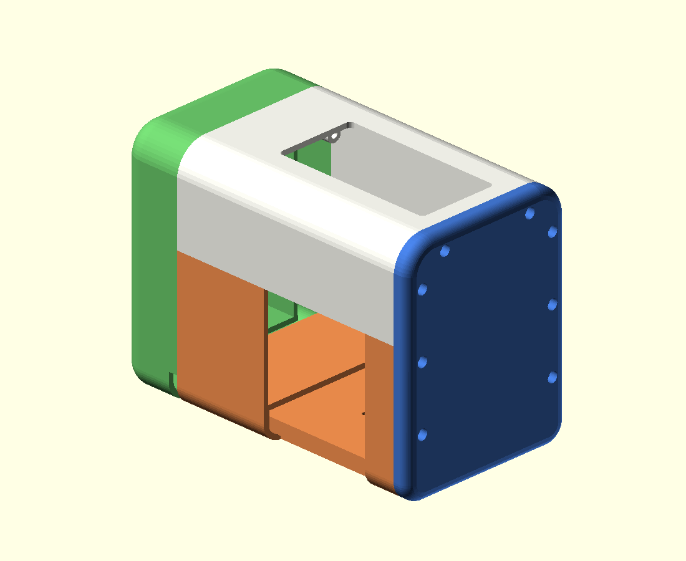
docs/microduck_look/body_v3_iso.png
