HemangVora/OpenDuck/docs/microduck_look/body_v3_side.png

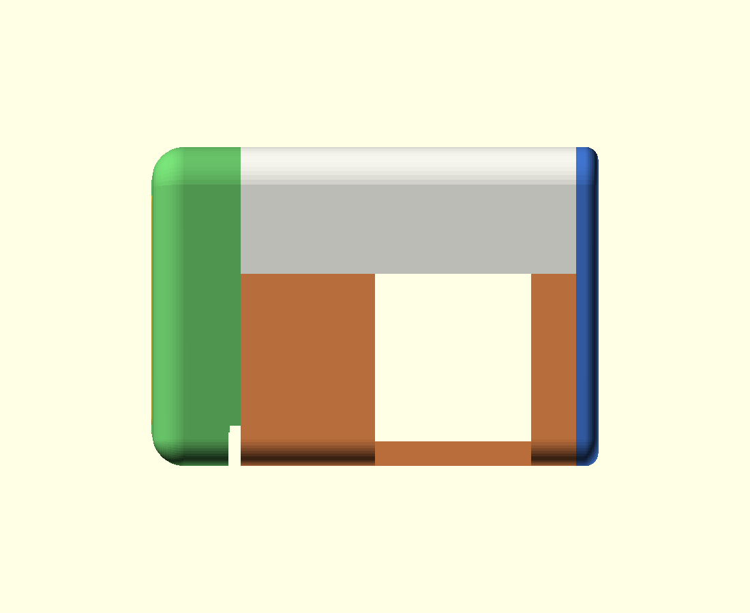
docs/microduck_look/body_v3_side.png
