HemangVora/OpenDuck/docs/microduck_look/body_v4_cut.png

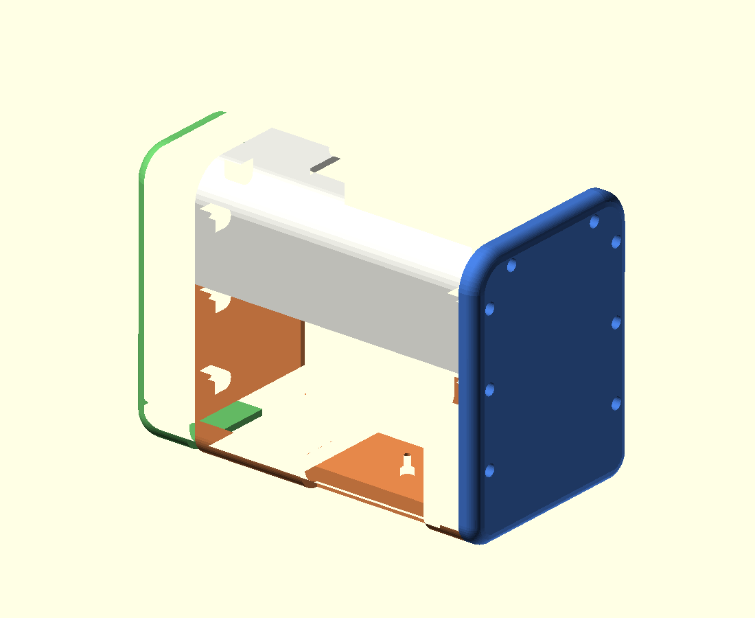
docs/microduck_look/body_v4_cut.png
