HemangVora/OpenDuck/docs/microduck_look/body_v4_inside_front.png

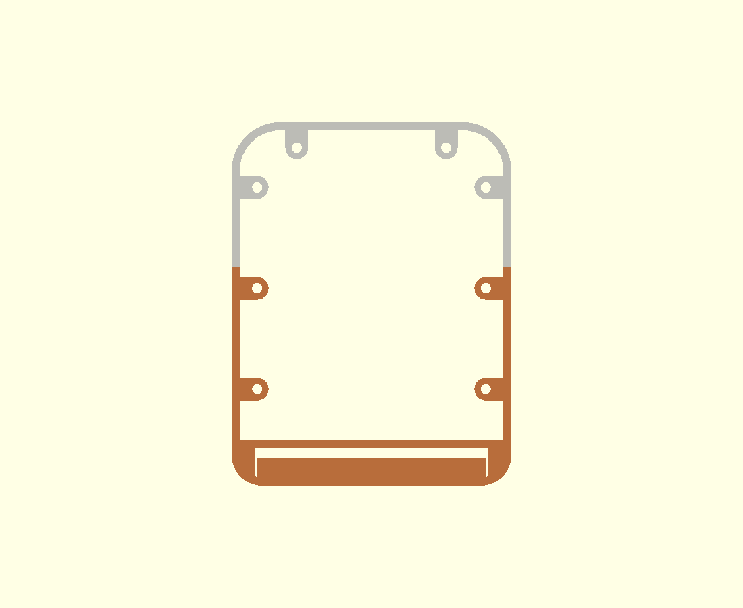
docs/microduck_look/body_v4_inside_front.png
