HemangVora/OpenDuck/docs/microduck_look/duck_full_md3_back.png

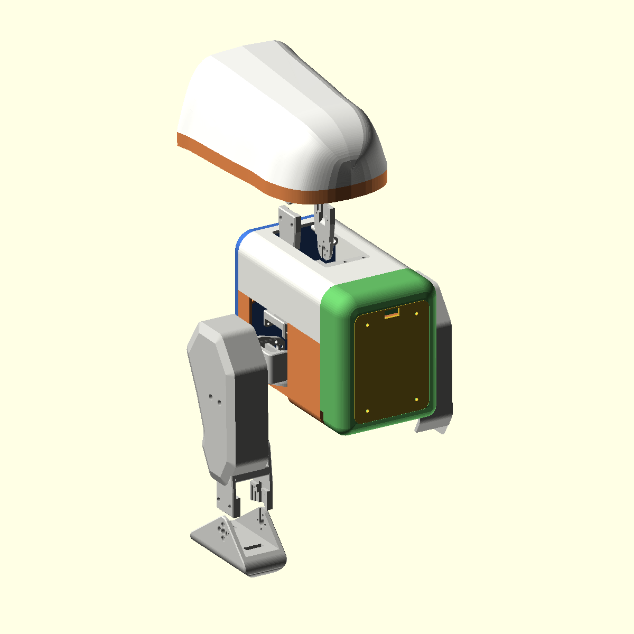
docs/microduck_look/duck_full_md3_back.png
