HemangVora/OpenDuck/docs/microduck_look/duck_full_md3_front.png

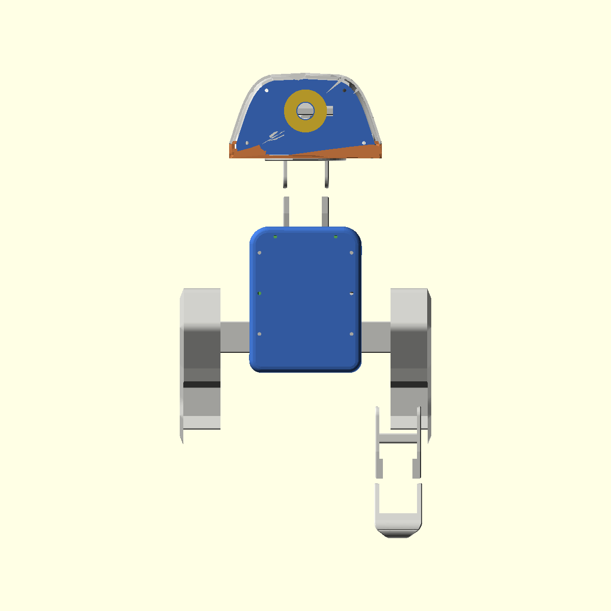
docs/microduck_look/duck_full_md3_front.png
