HemangVora/OpenDuck/docs/microduck_look/duck_full_md3_iso.png

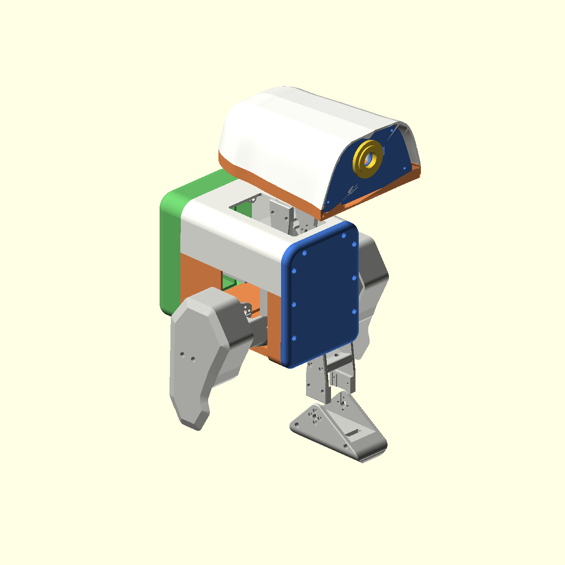
docs/microduck_look/duck_full_md3_iso.png
