HemangVora/OpenDuck/docs/microduck_look/duck_full_md3_side.png

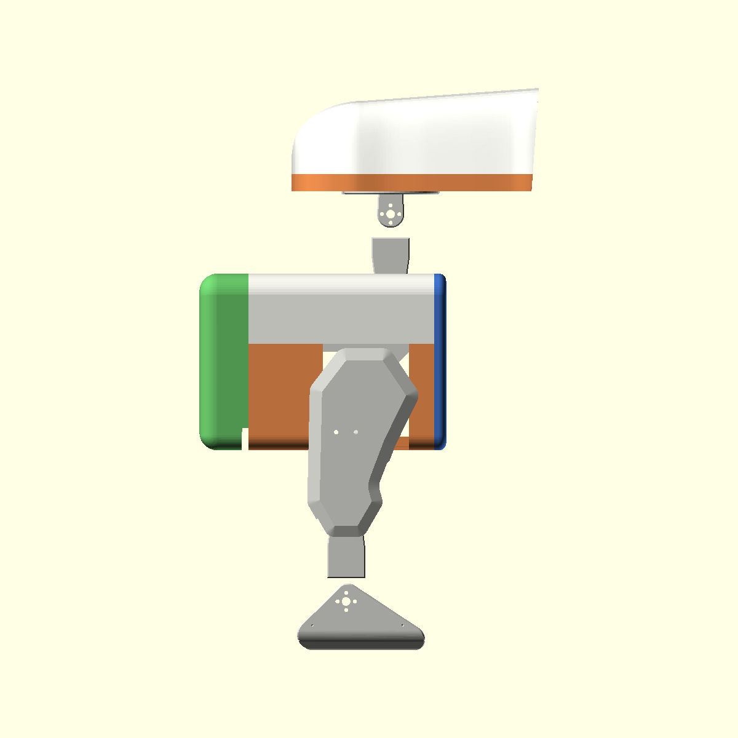
docs/microduck_look/duck_full_md3_side.png
