HemangVora/OpenDuck/docs/microduck_look/glb_all_iso.png

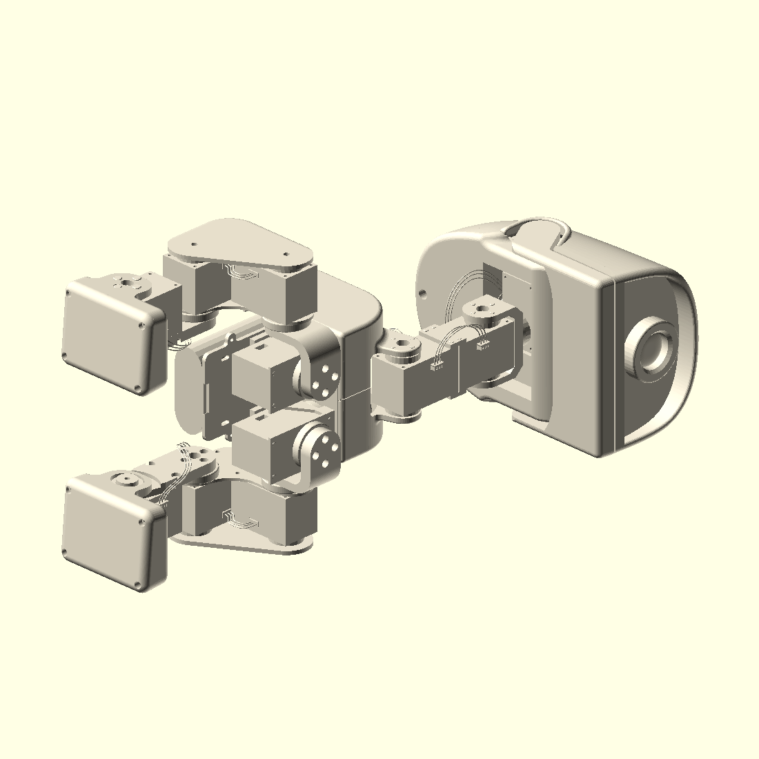
docs/microduck_look/glb_all_iso.png
