HemangVora/OpenDuck/docs/microduck_look/glb_shells_iso.png

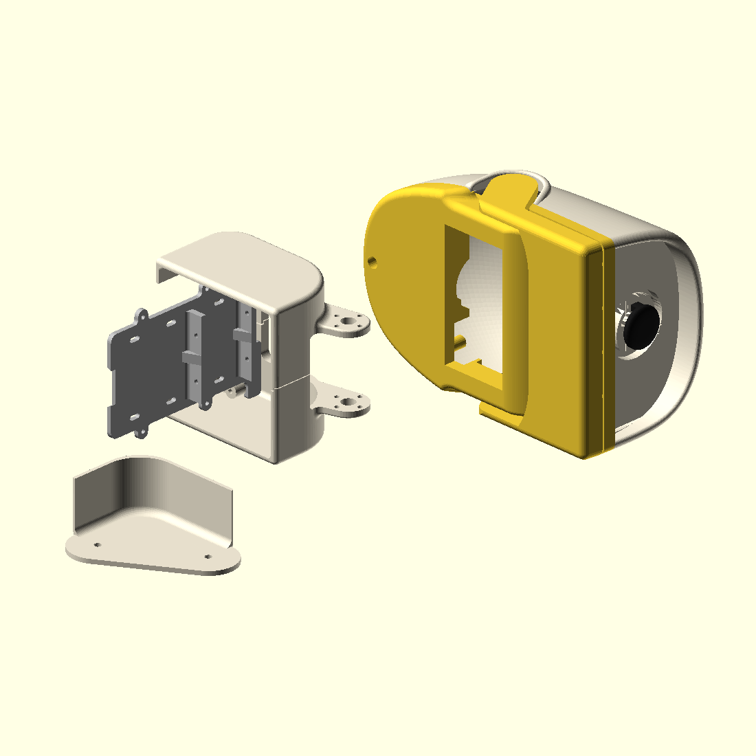
docs/microduck_look/glb_shells_iso.png
