HemangVora/OpenDuck/docs/microduck_look/md_full_iso.png

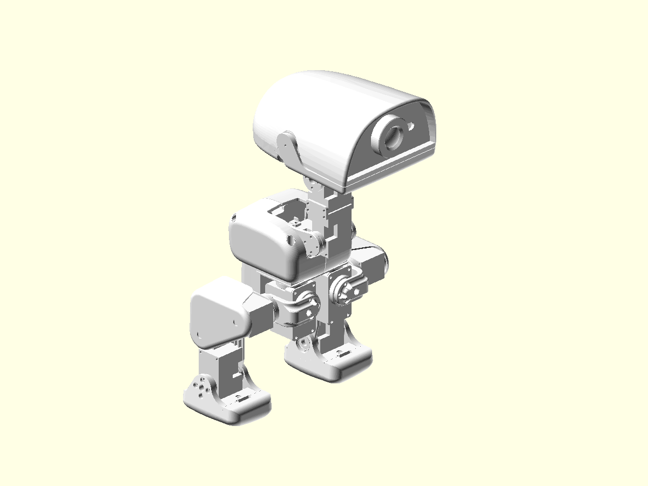
docs/microduck_look/md_full_iso.png
