HemangVora/OpenDuck/docs/microduck_look/md_head_front.png

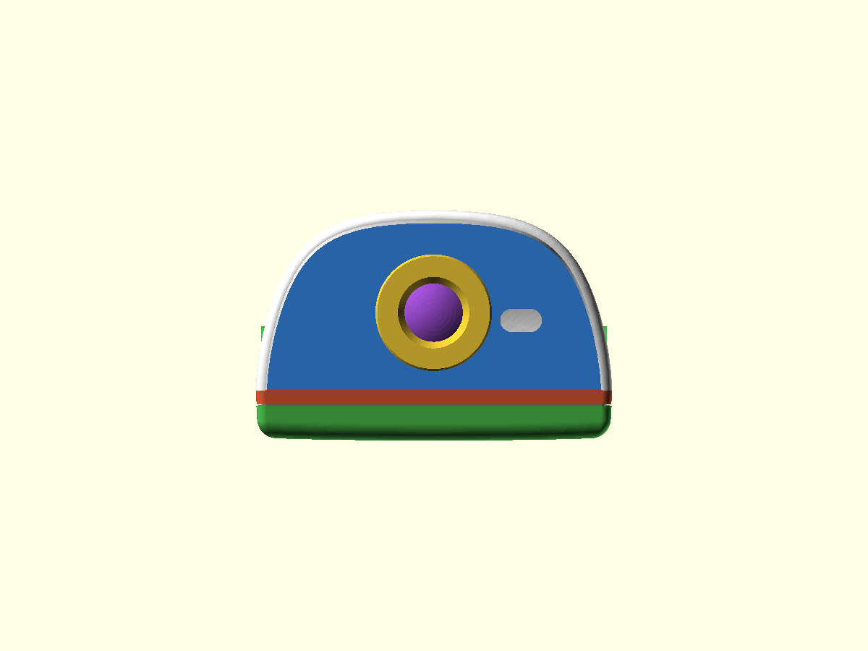
docs/microduck_look/md_head_front.png
