HemangVora/OpenDuck/docs/microduck_look/md_head_iso.png

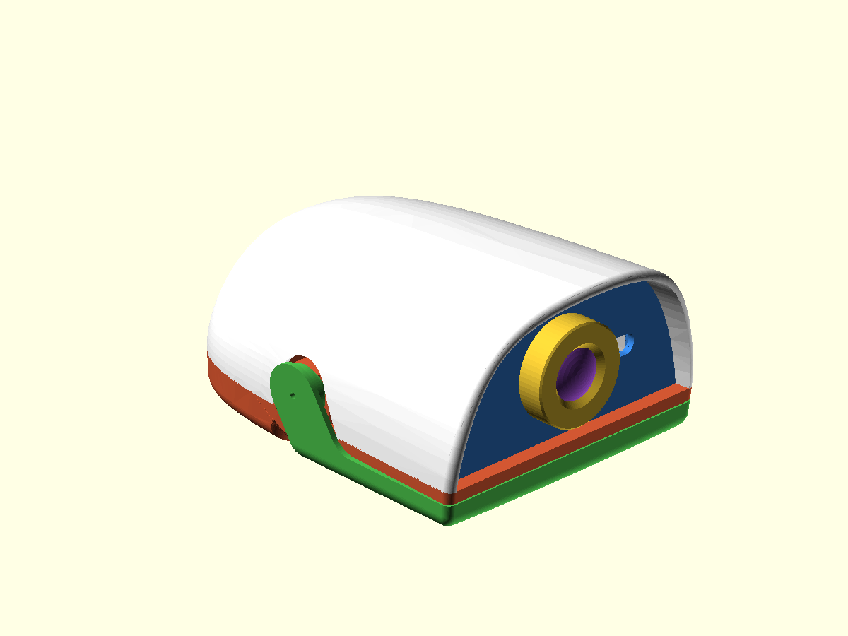
docs/microduck_look/md_head_iso.png
