HemangVora/OpenDuck/docs/microduck_look/md_trunk2_iso.png

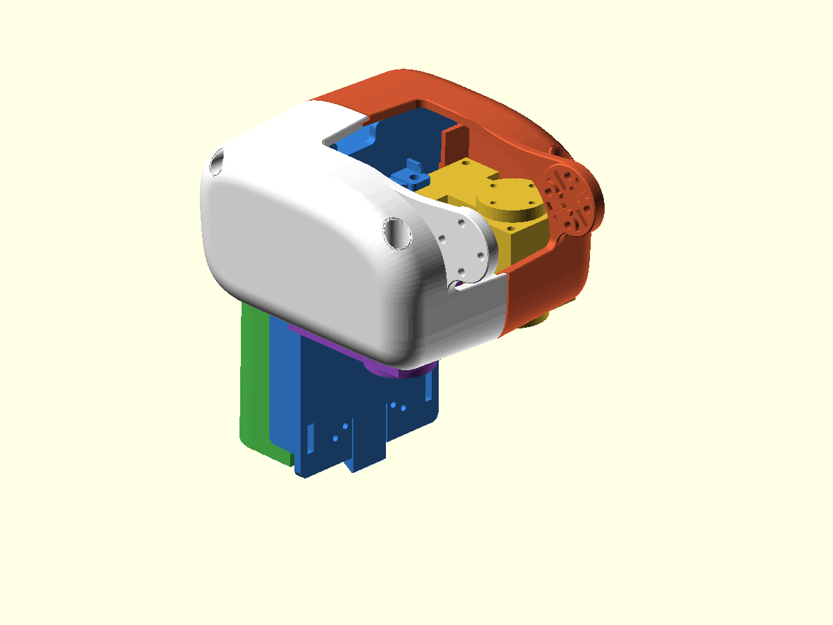
docs/microduck_look/md_trunk2_iso.png
