HemangVora/OpenDuck/docs/microduck_look/md_v5_back.png

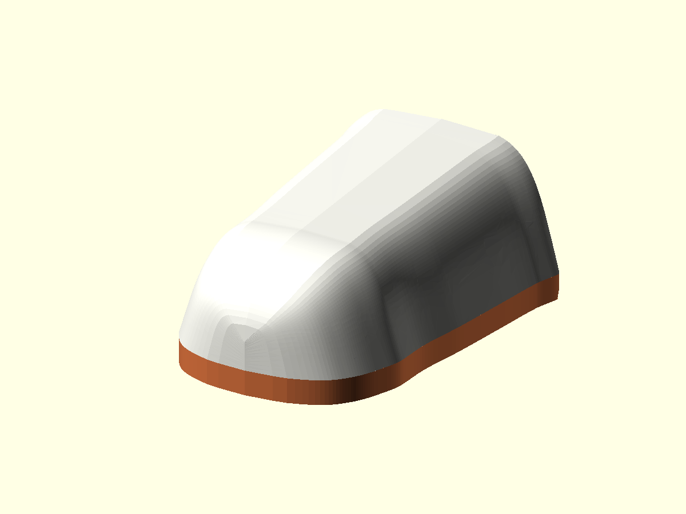
docs/microduck_look/md_v5_back.png
