HemangVora/OpenDuck/docs/microduck_look/md_v5_cut_iso.png

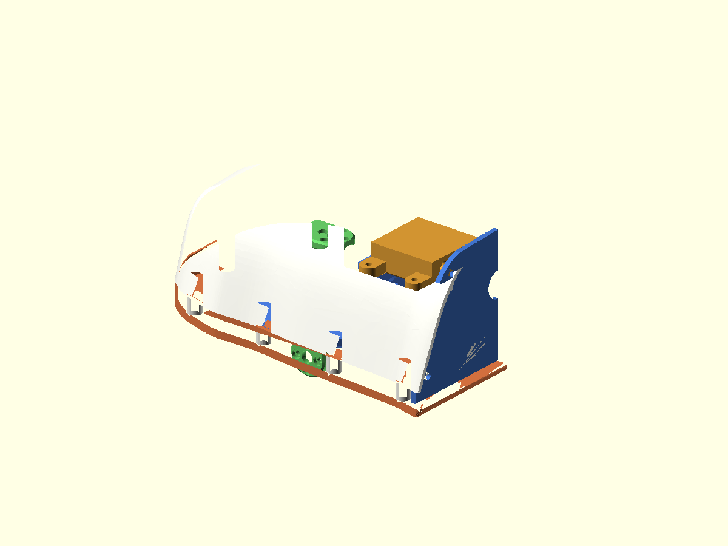
docs/microduck_look/md_v5_cut_iso.png
