HemangVora/OpenDuck/docs/microduck_look/md_v5_cut_side.png

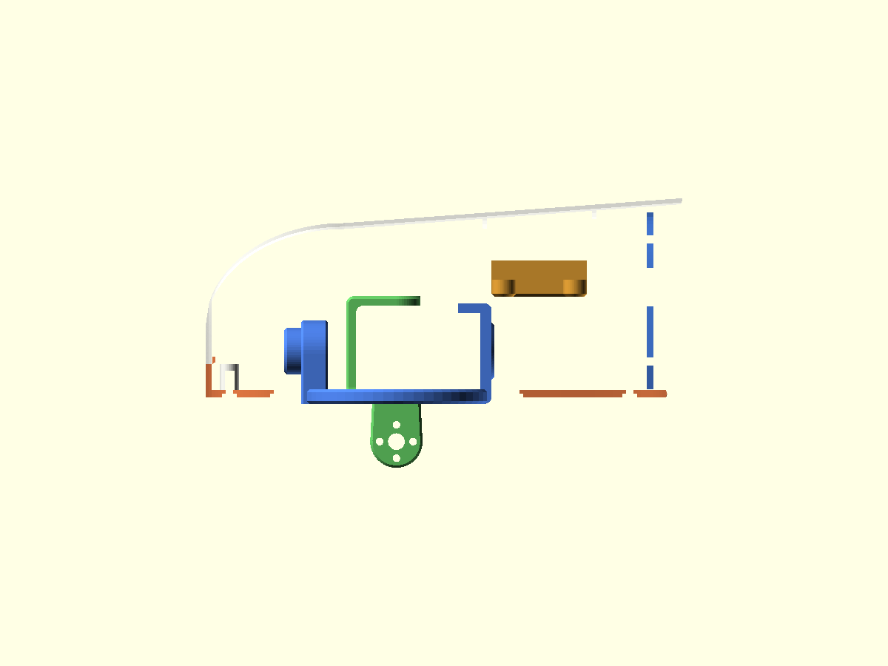
docs/microduck_look/md_v5_cut_side.png
