HemangVora/OpenDuck/docs/microduck_look/md_v5_side.png

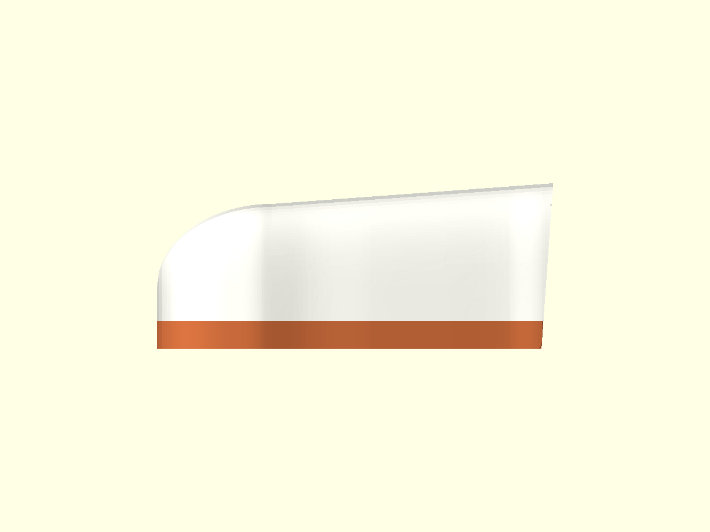
docs/microduck_look/md_v5_side.png
