HemangVora/OpenDuck/docs/microduck_look/odm_body_iso.png

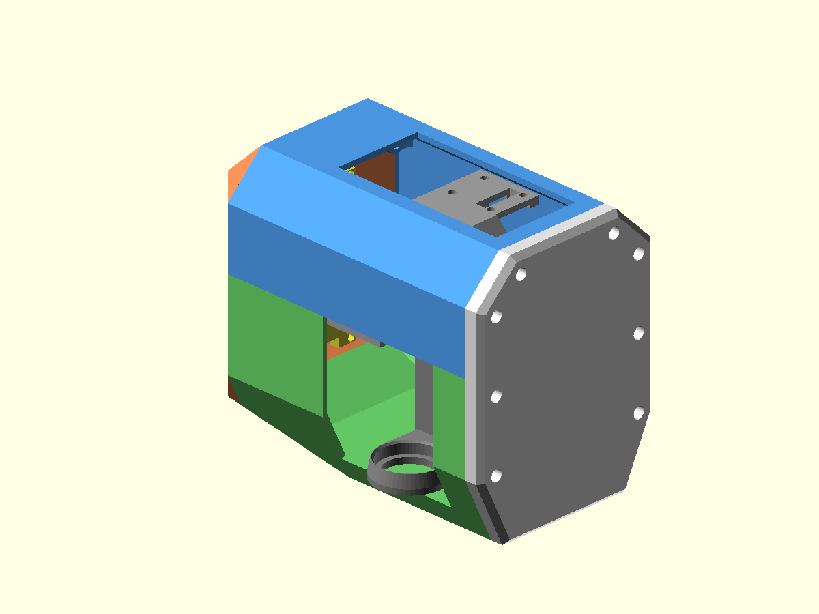
docs/microduck_look/odm_body_iso.png
