HemangVora/OpenDuck/docs/shopping-list.md

# Open Duck Mini v2 (ST3215 / 3S / Radxa) — India shopping list

Checked live on 2026-10-27/28, Amazon links verified 2026-10-29. Prices include GST. Already ordered: Bambu Lab A1 (WOL3D, Amazon.in B0DSLN79DJ, ₹28,599), PLA and TPU filament.

## Tier 1 — required to get a walking duck (≈ ₹51,000)

| Item | Qty | Link | Price | Shop |
|---|---|---|---|---|
| ST3215-HS 20 kg·cm 12 V bus servo (106 rpm) | 14 | https://zbotic.in/product/waveshare-20kg-cm-bus-servo-motor-106prm-high-speed-large-torque-with-360-degrees-high-precision-magnetic-encoder/ | **₹2,288 ea Zbotic (19 in stock 2026-10-30, see zbotic-cart.md)**; Hubtronics https://hubtronics.in/st3215-hs-servo ₹2,399 (18) | Zbotic or Hubtronics. The 30 kg unit (https://hubtronics.in/st3215-servo, ₹2,299) fell from 33 to **11 in stock** in 24 h and is not sold anywhere else in India, so it can no longer cover 14 + 2 of one model. All 16 must be the same model. |
| Bus Servo Adapter (A) driver board | 1 | https://hubtronics.in/bus-servo-adapter-a | ₹449 | Hubtronics (15) |
| KW-12 lever microswitch, foot contacts | 4 | https://hubtronics.in/kw-12-micro-switch | ₹15 ea | Hubtronics (100) |
| Radxa Zero 3W 2 GB RAM with header (RS107-D2E0H1W15) | 1 | https://hubtronics.in/radxa-zero-3w-2gbram | ₹5,760 | Hubtronics (9 on 2026-10-30, was 11) |
| Radxa heatsink 5519A | 1 | https://hubtronics.in/radxa-heatsink-5519a | ₹354 | Hubtronics, **out of stock 2026-10-30**; cart uses the ₹29 Pi 3B adhesive heat-sink set (https://hubtronics.in/rpi-3b-heat-sink-set) instead |
| microSD 64 GB A2, SanDisk Extreme | 1 | https://www.amazon.in/dp/B0B2DDJGF8 | ₹2,399 (Amazon price is inflated; a SanDisk brand outlet locally is ~₹1,200, must say A2/V30) | Amazon.in, 2 Nov |
| BNO085 IMU breakout (BNO055 fallback: Hubtronics 7Semi BNO055 Qwiic ₹1,274, in the Hubtronics cart; BNO085 out of stock there) | 1 | https://robocraze.com/products/bno085-9-dof-orientation-imu-sensor-fusion-nano-breakout-board | ₹2,089 | Robocraze (after 3 Nov, fine: IMU is needed in Phase 3). Amazon alt: https://www.amazon.in/dp/B0FTZDPVK6 ₹2,934, 7 Nov, no faster |
| 18650 cells: Samsung 30Q, or Molicel P30B/P28A if findable | 3 | https://www.amazon.in/dp/B0HL8CRN1P | ₹489 ea | Amazon.in |
| 3S 40 A BMS with balance leads | 1 | https://robocraze.com/products/3-series-40a-11-1v-12-6v-18650-lithium-battery-protection-board-with-balance | ₹113 | Robocraze. Amazon alt: https://www.amazon.in/dp/B0BJVPGDQ8 ₹259, FBA 31 Oct. Or local battery shop |
| 7Semi AP64500 buck, 7–40 V in, 5 V 5 A | 1 | https://robocraze.com/products/7semi-dc-dc-buck-converter-7v-40v-input-to-5v-5a-output-ap64500 | ₹798 | Robocraze. Amazon alt: https://www.amazon.in/dp/B0FDRCCYBJ 9–36 V in, 5 V 5 A, ₹299, 3 Nov; or XY-3606 https://www.amazon.in/dp/B0H12RWZ9H ₹399, FBA 1 Nov |
| iMax B6AC balance charger | 1 | https://robocraze.com/products/imax-b6ac-smart-balance-charger-80w | ₹2,280 | Robocraze. Same unit on Amazon: https://www.amazon.in/dp/B07BRM5FCN ₹2,469, 3 Nov |
| Inline mini-blade fuse holder + 5× 15 A fuses | 1 | https://www.amazon.in/dp/B0B7GPVB4X | ₹245 | Amazon.in, 2 Nov. Or any auto parts shop |
| Toggle switch 12 V 20 A DC (with safety cover) | 1 | https://www.amazon.in/dp/B0B3Y229LV | ₹284 | Amazon.in, FBA 2 Nov. Optional soft-switch instead: MOSFET trigger module 5–36 V https://www.amazon.in/dp/B0977MBG7N ₹245 |
| XT30 connector pairs, 5-pack | 1 | https://www.amazon.in/dp/B0FTVN486X | ₹298 | Amazon.in |
| 18 AWG silicone wire red + black | 1 | https://www.amazon.in/dp/B0HMWWMMGW | ₹249 | Amazon.in |
| 16 AWG silicone wire, 1 m red + 1 m black | 1 | https://www.amazon.in/dp/B09CB833B7 | ₹420 | Amazon.in, FBA 2 Nov. Cheaper locally |
| JST-XH 2.54 mm connector kit, 560 pcs | 1 | https://www.amazon.in/dp/B0FVLRZC6L | ₹599 | Amazon.in |
| 3S JST-XH balance lead, 20 cm, 22 AWG | 1 | https://www.amazon.in/dp/B0CV9JDKZ7 | ₹269 | Amazon.in, 31 Oct |
| M3 × 5 mm brass heat-set inserts (Ø4.0 holes) | 100 | https://www.amazon.in/dp/B0DZ8B7FW1 | ₹345 | Amazon.in |
| M3 hex socket screw kit, 600 pcs, 6–20 mm | 1 | https://www.amazon.in/dp/B0H7P7L5YS | ₹629 | Amazon.in |
| 6804ZZ bearing 20×32×7, 2-pack (need 3) | 2 | https://www.amazon.in/dp/B071HL4RLN | ₹299 ea | Amazon.in |
| Loctite 243 blue, 50 ml (genuine Henkel listing) | 1 | https://www.amazon.in/dp/B014MMG3AM | ₹627 | Amazon.in, 1 Nov. Avoid the ₹408 "Lock-tite" clone B0F3XV8P29. A 10 ml tube at a hardware shop is enough |
| 60 W adjustable soldering iron kit (+ M3 insert tip) | 1 | https://www.amazon.in/dp/B0FWKWRGL8 | ₹627 | Amazon.in |
| Hex key set 1.5–6 mm | 1 | https://www.amazon.in/dp/B0D948XF49 | ₹209 | Amazon.in |

## Tier 2 — recommended: saves a week or protects hardware (≈ ₹9,500)

| Item | Qty | Link | Price | Why |
|---|---|---|---|---|
| Spare ST3215-HS servos | 2 | https://hubtronics.in/st3215-hs-servo | ₹2,399 ea | one is the BAM identification unit, one covers a stripped gear |
| FTDI mini USB to TTL (3.3 V jumper) | 1 | https://robocraze.com/products/ftdi-232-mini-usb-to-ttl-converter | ₹110 | configure servos from the Mac before the Radxa is ready. **Needed with the servos, so buy from Amazon instead:** https://www.amazon.in/dp/B072NDZL9K ₹229, FBA 31 Oct |
| LiPo voltage tester with alarm | 1 | https://robocraze.com/products/lipo-battery-voltage-tester | ₹107 | 3.5 V/cell warning; BMS cutoff (2.5 V) is too low. Amazon alt: https://www.amazon.in/dp/B0F678VRR4 ₹199, 3 Nov |
| 1000 µF 25 V ×10 pack | 1 | https://www.amazon.in/dp/B09VL23ZP1 | ₹209 | servo stall inrush at the adapter (use 2). FBA 31 Oct |
| 470 µF 25 V ×5 pack | 1 | https://www.amazon.in/dp/B0H2X2YFRZ | ₹109 | Radxa 5 V rail brownout. 2 Nov |
| 0.1 µF ceramic ×50 pack | 1 | https://www.amazon.in/dp/B0CZS12F6Q | ₹150 | decoupling next to the IMU and buck output |
| 18650 insulating rings + base mat | 1 pack | https://www.amazon.in/dp/B0CPSMC43L | ₹159 | pack build safety. FBA 2 Nov |
| Kapton tape 12 mm × 33 m | 1 | https://www.amazon.in/dp/B0DQYJ7569 | ₹139 | IMU mount, insulation. FBA 2 Nov (Robocraze ₹215 if ordering there anyway) |
| Flush cutter | 1 | https://www.amazon.in/dp/B0H6P3CP4M | ₹217 | wiring |
| Filament dryer capable of 70 °C (Sunlu S2) | 1 | https://www.amazon.in/dp/B09XMT9SVX | ₹10,911, 10–12 Nov | Expensive here; the cheaper Sunlu S1 Plus (₹6,483, B09HJL95RH) only reaches 55 °C, too cool for TPU. **Skip for now:** print the TPU soles from a freshly opened sealed bag, or dry 8 h at 70 °C in a kitchen oven / food dehydrator |
| SG90 9 g servo, antennas | 2 | https://robocraze.com/products/sg90-micro-servo-motor | ₹98 ea | cosmetic, not used by the policy. Amazon alt: https://www.amazon.in/dp/B0DGW59SV6 ₹80, FBA 31 Oct |

## Tier 3 — optional or later (≈ ₹6,000 plus training)

| Item | Qty | Link | Price | When |
|---|---|---|---|---|
| IMX219 camera module for Pi 5 (22-pin cable included) | 1 | https://thinkrobotics.com/products/imx219-camera-module-for-raspberry-pi-5 | ₹1,700 | Phase 5 vision |
| Pi Zero camera cable 22→15 pin, 15 cm | 1 | https://robocraze.com/products/raspberry-pi-zero-camera-cable-15cm | ₹77 | Phase 5 |
| Pololu VL53L8CX 8×8 ToF | 1 | https://www.digikey.in/en/products/detail/pololu/3419/22310072 | ₹2,325 | Phase 5 |
| INA226 current/voltage monitor | 1 | https://www.amazon.in/dp/B0D2DPY2SB | ₹426 | real walking-current data, software low-battery cutoff. FBA 2 Nov |
| Deburring tool kit | 1 | https://www.amazon.in/dp/B0H45JPKYB | ₹350 | print cleanup |
| Spare 0.4 mm hardened-steel hotend, A1 / A1 mini (same part) | 1 | https://www.amazon.in/dp/B0GN39LZGG | ₹849 | insurance for the 8 h head print. 3 Nov |
| Cloud GPU credits (RunPod RTX 4090 ≈ $0.34–0.89/h) | – | https://www.runpod.io | ₹3,000–5,000 | Phase 4 training |
| MAX98357A I2S amp (SmartElex) + small 4 Ω speaker, eye LEDs | – | https://www.amazon.in/dp/B0G2LCY1DK | ₹339 + ~₹150 | expressions, optional. FBA 1 Nov |

## Notes
- **Local shops:** wire, connectors, fuse, switch, capacitors, solder gear, 18650 cells, BMS, bearings, M3 screws, hex keys, Loctite and cutters can all be bought in Vadodara; see `local-shopping-list.md` for the ask-for specs and checks. That removes ≈ ₹7,500 of the Amazon items above.
- **2026-10-30: decided to order everything possible from Hubtronics in one go; the built cart (25 lines, ₹50,433 incl. GST) is in `hubtronics-cart.md` with product IDs, substitutes and what Hubtronics does not stock.** Earlier plan: Hubtronics (servos, adapter, switches, Radxa, heatsink); Robocraze (IMU, buck, charger, BMS) delivers after 3 Nov, which is fine because none of it is needed until the pack build in Phase 2; move the FTDI adapter to Amazon so it lands with the servos. Amazon.in for the rest; ThinkRobotics + DigiKey only when vision starts.
- Amazon delivery dates above were read on 2026-10-29 for Amazon's default location; re-check with your Vadodara pincode. "FBA" items are free delivery only on a ₹499+ cart of Amazon-dispatched items, so batch them.
- Camera and ToF move to Tier 1 only if vision is wanted from day one; nothing in the walking phases needs them. Print the head face plate with the openings regardless.
- Radxa: the 2 GB variant at Hubtronics is the only Pi-Zero-footprint board in stock in India; importing lands near ₹5,500 after duty. 2 GB is enough for policy + camera + ToF.
- Bearings are 6804ZZ 20×32×7 per the official BOM (3 needed). Foot switches (4) are in the official BOM; KW-12 is a close fit, trim the lever if needed. No M2 screws: servos include theirs.
- Servo sources re-checked 2026-10-29: Hubtronics 11× ST3215 30 kg (was 33 on 10-27), 18× ST3215-HS; Robocraze 1× HS (₹2,283); Zbotic now blocks automated checks (had 19× HS ₹2,288 on 10-27, check manually as backup); Evelta sold out; ThinkRobotics pre-order 2–4 weeks; Amazon.in drop-shippers mid/late November.
- Why HS instead of a mixed order: 11× 30 kg for legs + HS for the head would work electrically, but it means two actuator models in MuJoCo, two BAM identifications and only one spare. The HS matches the stock 7.4 V servo's torque (20 vs 19.5 kg·cm) at twice its speed (106 vs 52 rpm), so the Playground reference gait needs no slowdown; the cost is more current per N·m (kt 8.3 vs 11 kg·cm/A) and about 10–15 % less battery time.
- Official BOM: https://docs.google.com/spreadsheets/d/1gq4iWWHEJVgAA_eemkTEsshXqrYlFxXAPwO515KpCJc · Repo: https://github.com/apirrone/Open_Duck_Mini (v2) · Research: ../research/
