HemangVora/OpenDuck/cad/microduck/_v2_backup/stl/v_radxa.stl

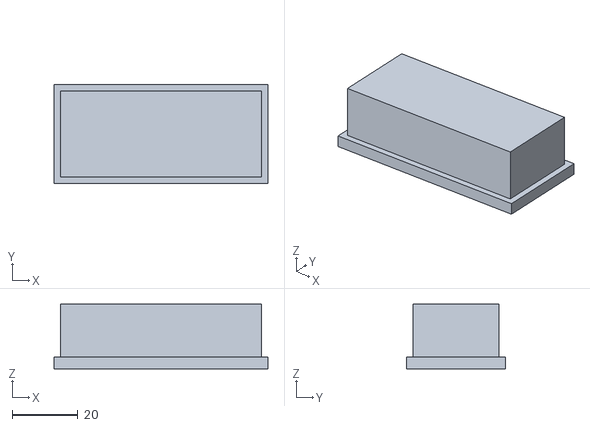
[picture p78: CAD file, 2026-11-05]
cad/microduck/_v2_backup/stl/v_radxa.stl
65.0 x 30.0 x 19.6
