HemangVora/OpenDuck/cad/microduck/checks/head_roll_mount.stl

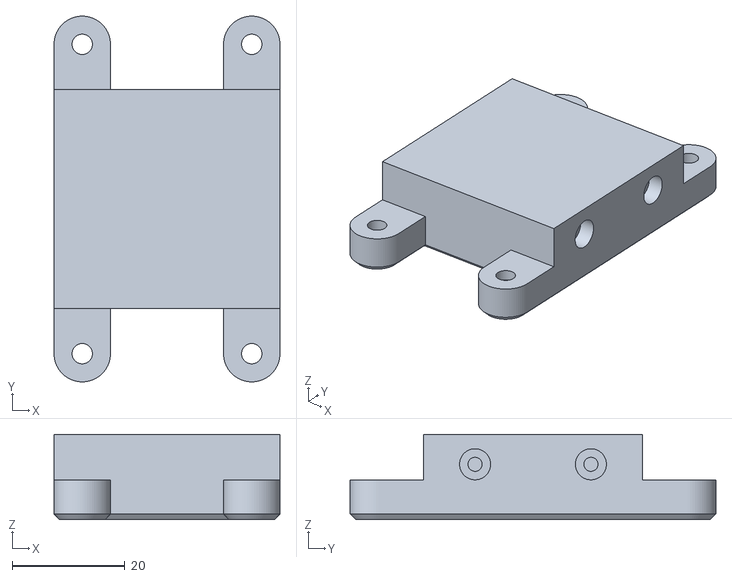
[picture p79: CAD file, 2026-11-05]
cad/microduck/checks/head_roll_mount.stl
40.0 x 64.7 x 15.1
