HemangVora/OpenDuck/cad/microduck/previews/compare/ref_grey.stl

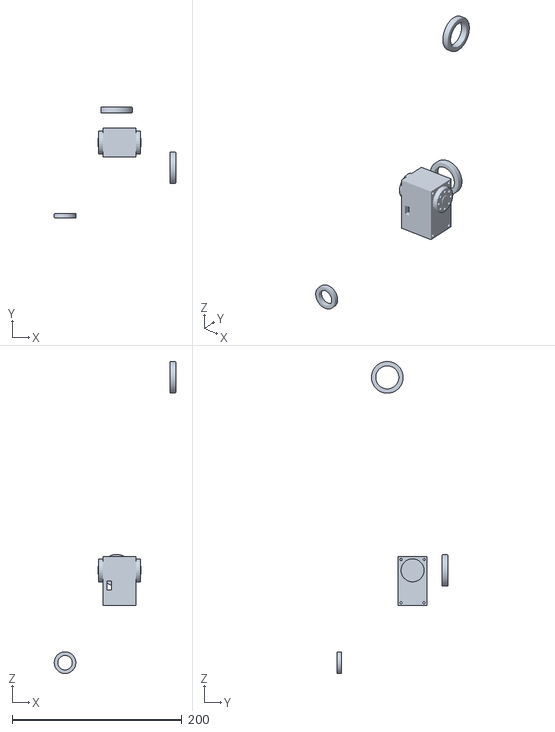
[picture p80: CAD file, 2026-11-05]
cad/microduck/previews/compare/ref_grey.stl
143.2 x 130.6 x 367.6
