HemangVora/OpenDuck/cad/microduck/previews/full/asm/black.stl

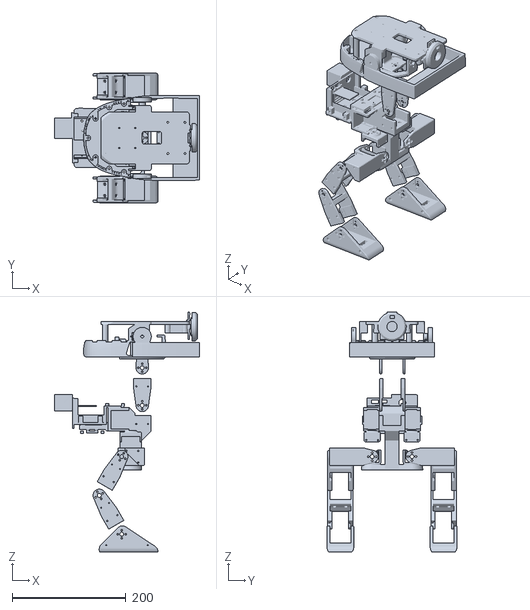
[picture p81: CAD file, 2026-11-05]
cad/microduck/previews/full/asm/black.stl
255.5 x 228.1 x 421.6
