HemangVora/OpenDuck/cad/microduck/previews/v3/asm/servo.stl

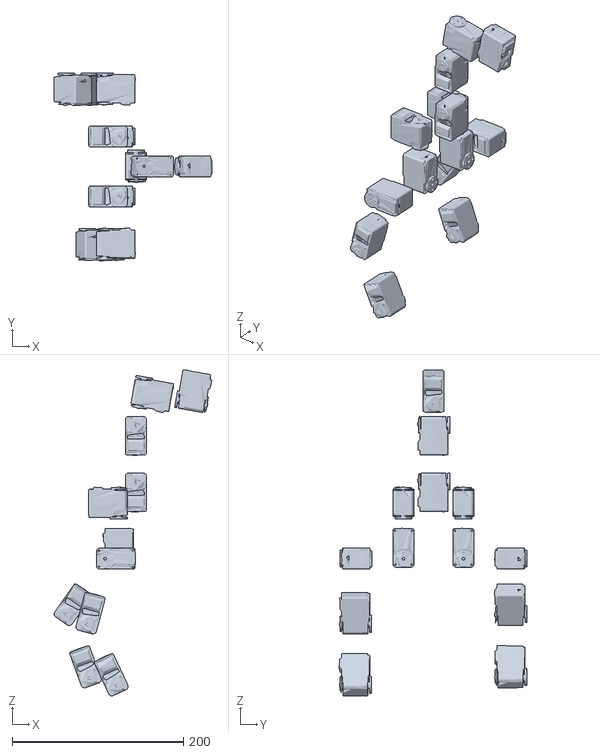
[picture p82: CAD file, 2026-11-05]
cad/microduck/previews/v3/asm/servo.stl
184.4 x 219.4 x 380.6
