HemangVora/OpenDuck/cad/microduck/stl/face_bill.stl

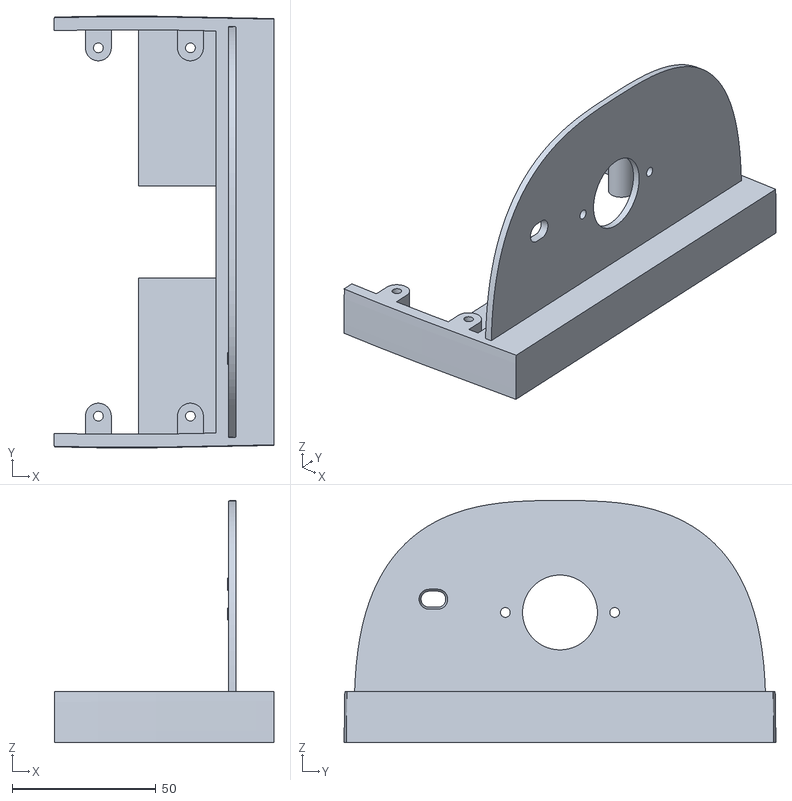
[picture p83: CAD file, 2026-11-05]
cad/microduck/stl/face_bill.stl
76.4 x 150.0 x 84.1
