HemangVora/OpenDuck/print/3mf/0_test_bracket.3mf

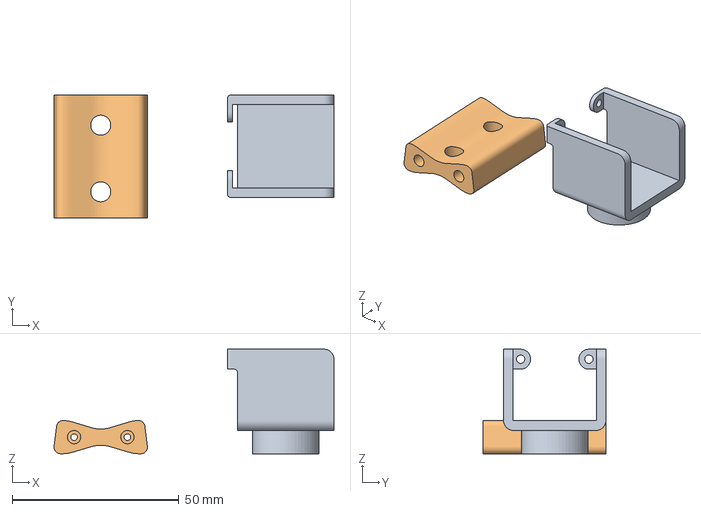
[picture p84: CAD file, 2026-11-05]
print/3mf/0_test_bracket.3mf
84.1 x 36.9 x 31.4 mm
roll_motor_bottom.stl
leg_spacer.stl
