HemangVora/OpenDuck/print/microduck_look/3mf/10e_md_battery_lid.3mf

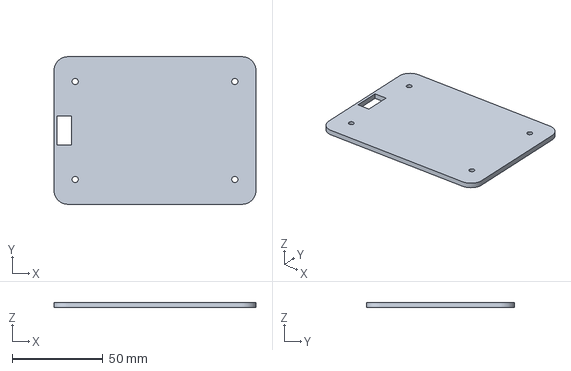
[picture p85: CAD file, 2026-11-05]
print/microduck_look/3mf/10e_md_battery_lid.3mf
111.4 x 81.4 x 3.00 mm
