HemangVora/OpenDuck/print/microduck_look/stl/md_body_bottom.stl

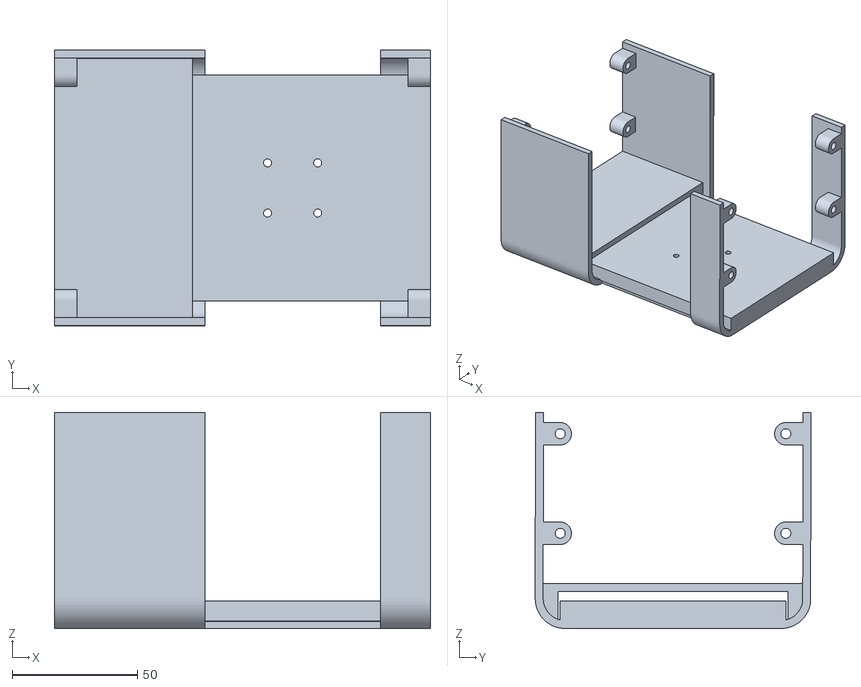
[picture p86: CAD file, 2026-11-05]
print/microduck_look/stl/md_body_bottom.stl
150.0 x 110.0 x 86.2
