HemangVora/OpenDuck/print/microduck_v3/3mf/15_pla_soles_rubber_1.5mm_black.3mf

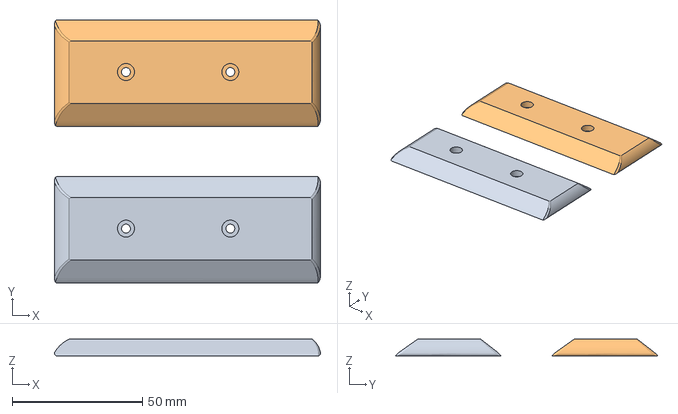
[picture p87: CAD file, 2026-11-05]
print/microduck_v3/3mf/15_pla_soles_rubber_1.5mm_black.3mf
101.9 x 100.7 x 6.49 mm
15_T1.5__sole_0.stl
15_T1.5__sole_1.stl
