HemangVora/OpenDuck/print/microduck_v3/oriented/layout/15_T1.5__sole_0.stl

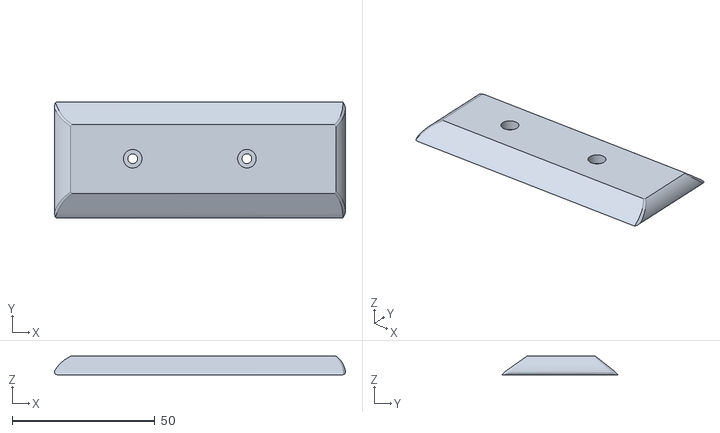
[picture p88: CAD file, 2026-11-05]
print/microduck_v3/oriented/layout/15_T1.5__sole_0.stl
101.9 x 40.7 x 6.49
