HemangVora/OpenDuck/print/oriented/head.stl

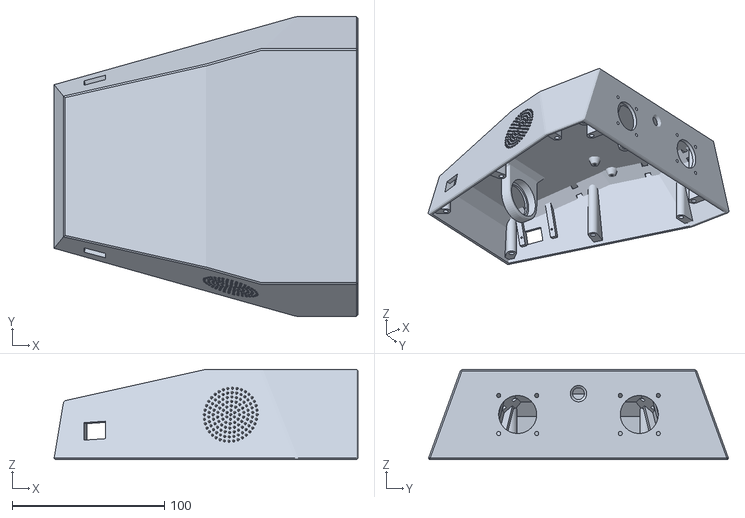
[picture p89: CAD file, 2026-11-05]
print/oriented/head.stl
199.8 x 197.3 x 59.4
