HemangVora/OpenDuck/cad/microduck/_v2_backup/stl/v_balance.stl

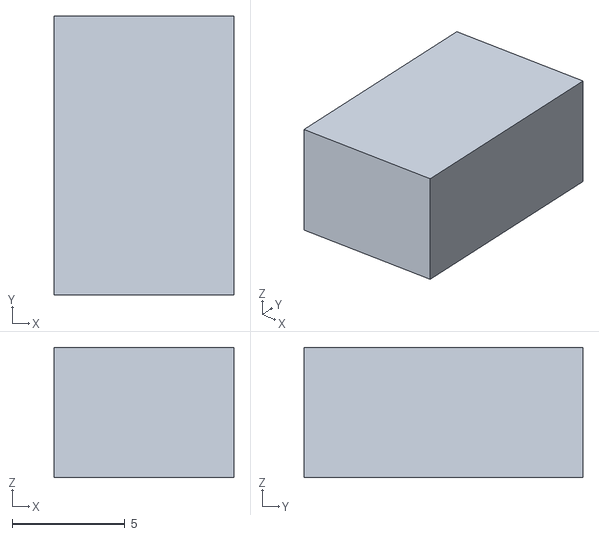
[picture p90: CAD file, 2026-11-05]
cad/microduck/_v2_backup/stl/v_balance.stl
8.00 x 12.4 x 5.80
