HemangVora/OpenDuck/cad/microduck/checks/roll_servo.stl

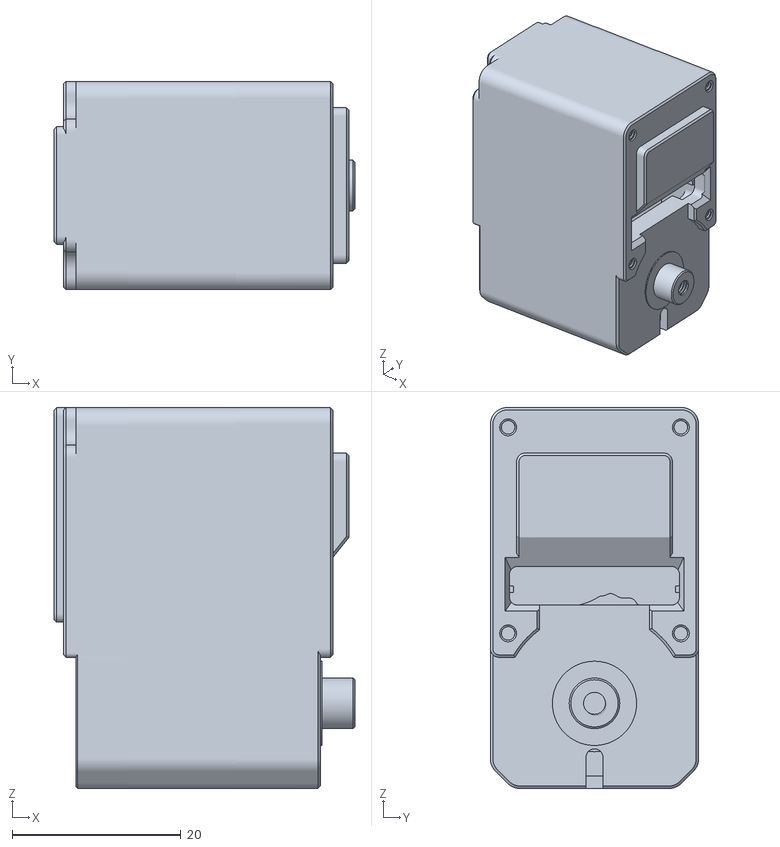
[picture p91: CAD file, 2026-11-05]
cad/microduck/checks/roll_servo.stl
35.7 x 24.7 x 45.2
