HemangVora/OpenDuck/cad/microduck/previews/compare/ref_yellow.stl

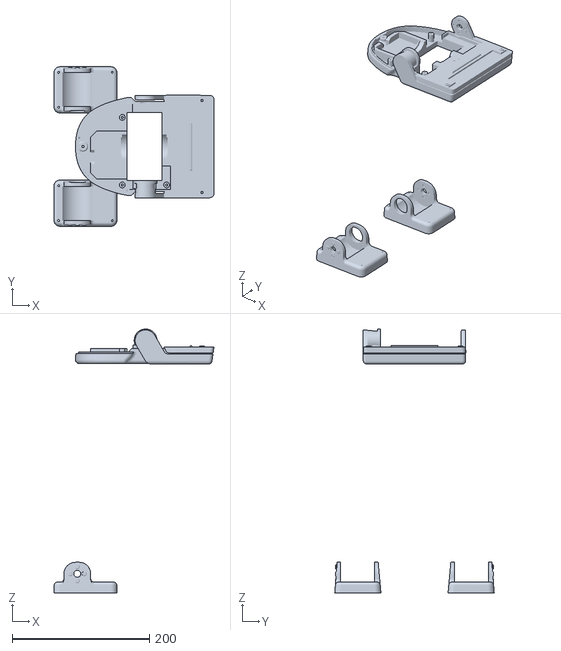
[picture p92: CAD file, 2026-11-05]
cad/microduck/previews/compare/ref_yellow.stl
233.4 x 232.9 x 385.2
