HemangVora/OpenDuck/cad/microduck/previews/full/asm/servo.stl

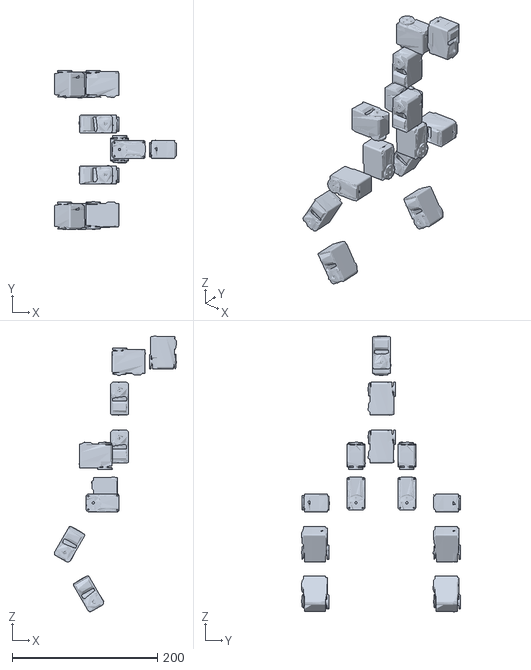
[picture p93: CAD file, 2026-11-05]
cad/microduck/previews/full/asm/servo.stl
168.4 x 219.4 x 379.7
