HemangVora/OpenDuck/cad/microduck/previews/v3/asm/white.stl

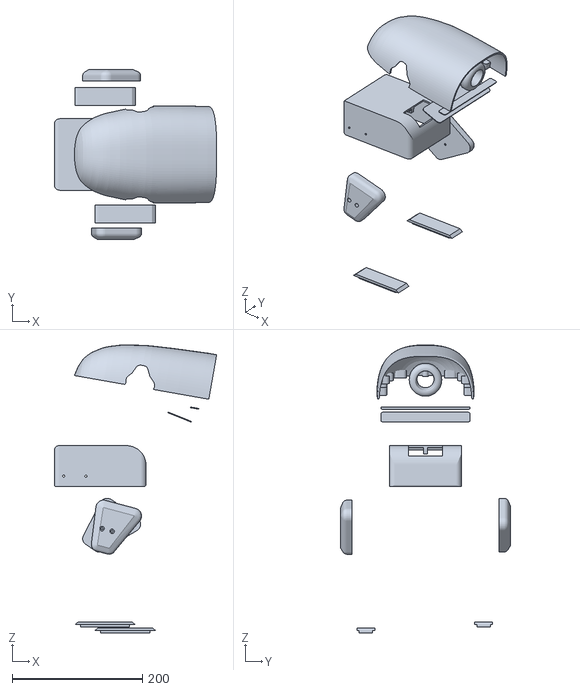
[picture p94: CAD file, 2026-11-05]
cad/microduck/previews/v3/asm/white.stl
249.7 x 261.0 x 443.0
