HemangVora/OpenDuck/cad/microduck/stl/head_tray.stl

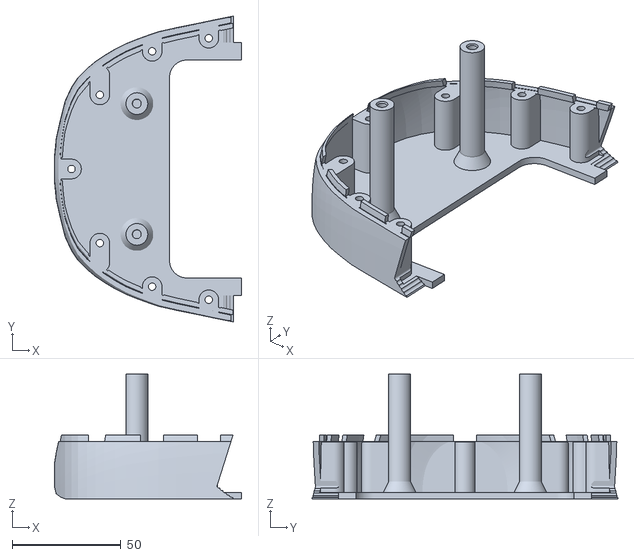
[picture p95: CAD file, 2026-11-05]
cad/microduck/stl/head_tray.stl
85.8 x 140.3 x 57.2
