HemangVora/OpenDuck/print/3mf/2a_leg_brackets.3mf

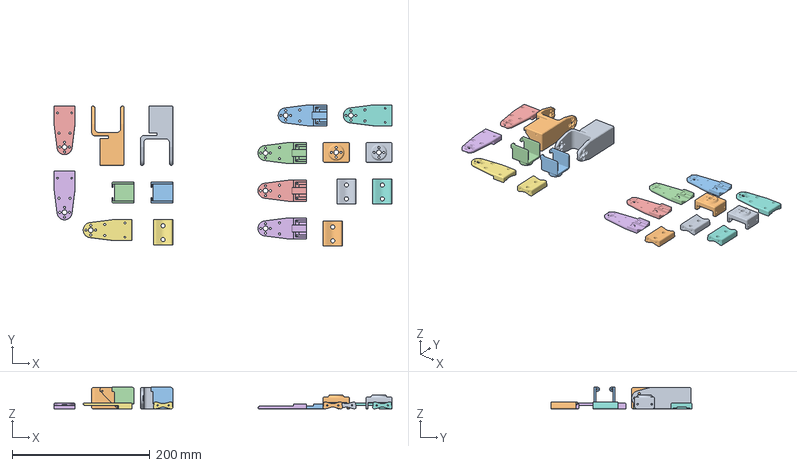
[picture p96: CAD file, 2026-11-05]
print/3mf/2a_leg_brackets.3mf
490.8 x 205.2 x 31.4 mm
left_roll_to_pitch.stl
right_roll_to_pitch.stl
roll_motor_bottom.stl_1
roll_motor_bottom.stl_2
knee_to_ankle_left_sheet.stl_1
knee_to_ankle_left_sheet.stl_2
knee_to_ankle_left_sheet.stl_3
knee_to_ankle_left_sheet.stl_4
roll_motor_top.stl_1
roll_motor_top.stl_2
knee_to_ankle_right_sheet.stl_1
knee_to_ankle_right_sheet.stl_2
knee_to_ankle_right_sheet.stl_3
knee_to_ankle_right_sheet.stl_4
leg_spacer.stl_1
leg_spacer.stl_2
leg_spacer.stl_3
leg_spacer.stl_4
