HemangVora/OpenDuck/print/microduck_look/3mf/9c_md_face_ring.3mf

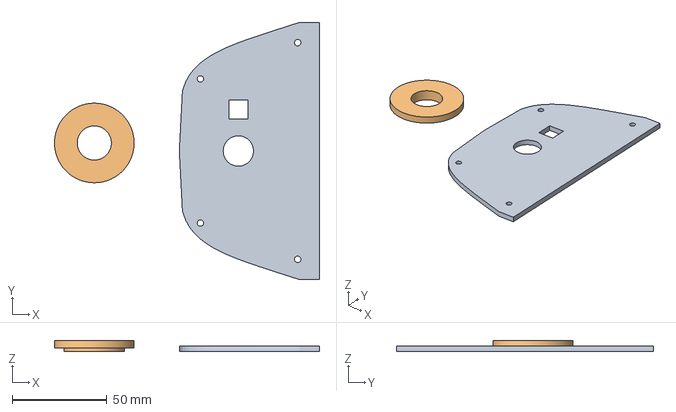
[picture p97: CAD file, 2026-11-05]
print/microduck_look/3mf/9c_md_face_ring.3mf
139.8 x 135.7 x 6.00 mm
md_face_plate_c.stl
md_cam_ring_c.stl
