HemangVora/OpenDuck/print/microduck_look/stl/md_body_top.stl

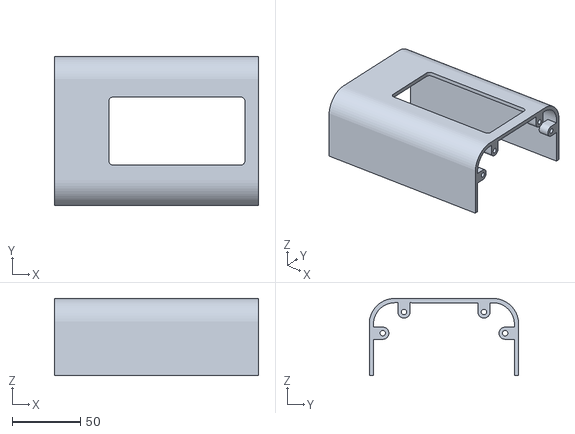
[picture p98: CAD file, 2026-11-05]
print/microduck_look/stl/md_body_top.stl
150.0 x 109.9 x 56.8
