HemangVora/OpenDuck/print/microduck_v3/oriented/layout/11d14b__sole_1.stl

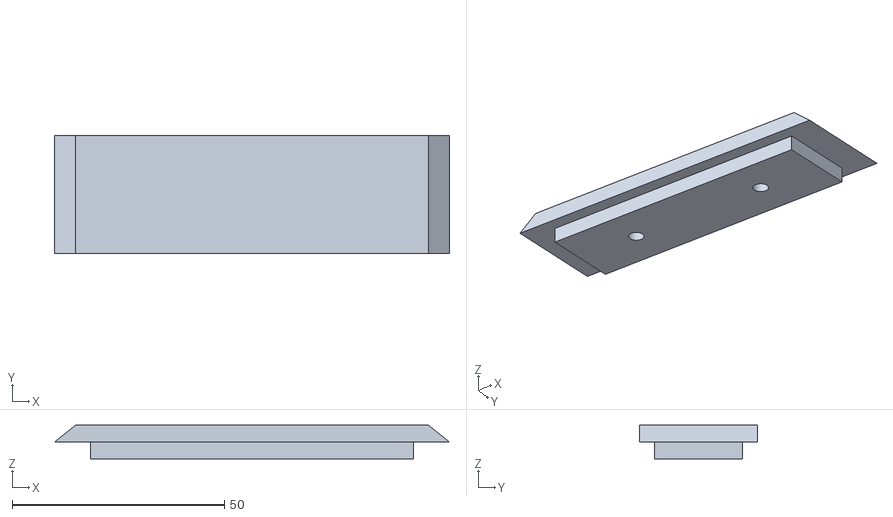
[picture p100: CAD file, 2026-11-05]
print/microduck_v3/oriented/layout/11d14b__sole_1.stl
93.0 x 27.7 x 8.00
