HemangVora/OpenDuck/print/oriented/knee_to_ankle_left_sheet.stl

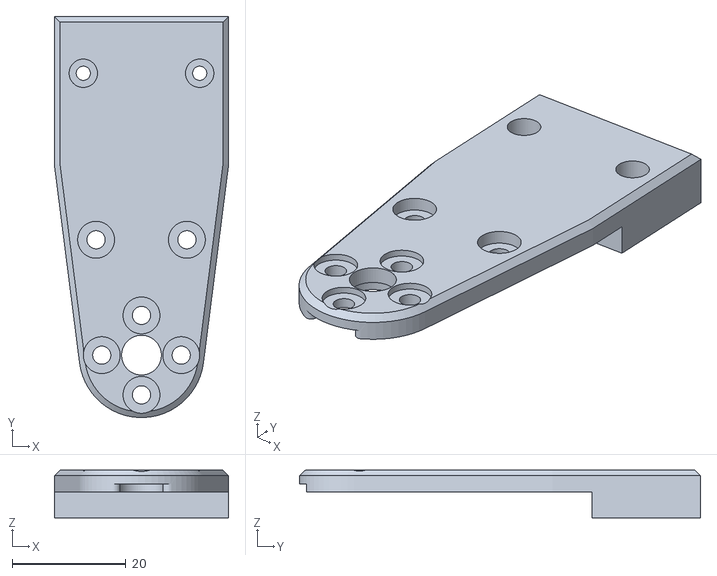
[picture p101: CAD file, 2026-11-05]
print/oriented/knee_to_ankle_left_sheet.stl
30.7 x 70.6 x 8.45
