HemangVora/OpenDuck/cad/microduck/_v2_backup/stl/body_deck.stl

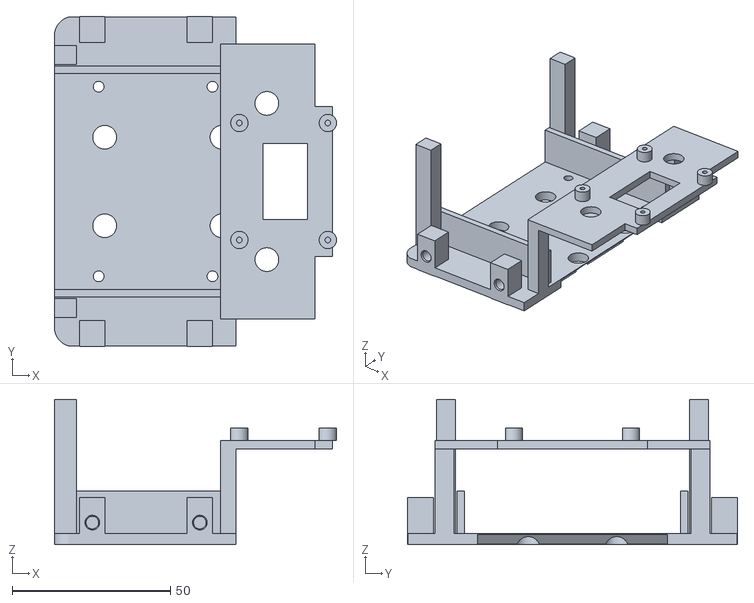
[picture p102: CAD file, 2026-11-05]
cad/microduck/_v2_backup/stl/body_deck.stl
89.2 x 104.4 x 46.0
