HemangVora/OpenDuck/cad/microduck/previews/compare/ref_dark.stl

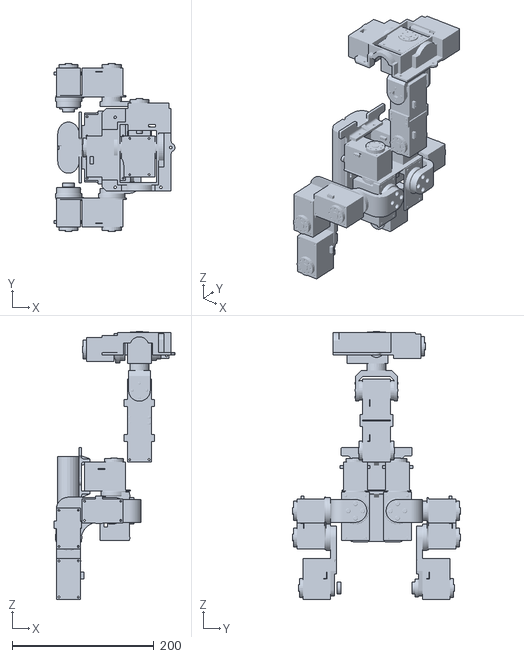
[picture p103: CAD file, 2026-11-05]
cad/microduck/previews/compare/ref_dark.stl
170.4 x 236.3 x 377.8
