HemangVora/OpenDuck/cad/microduck/previews/full/asm/tpu.stl

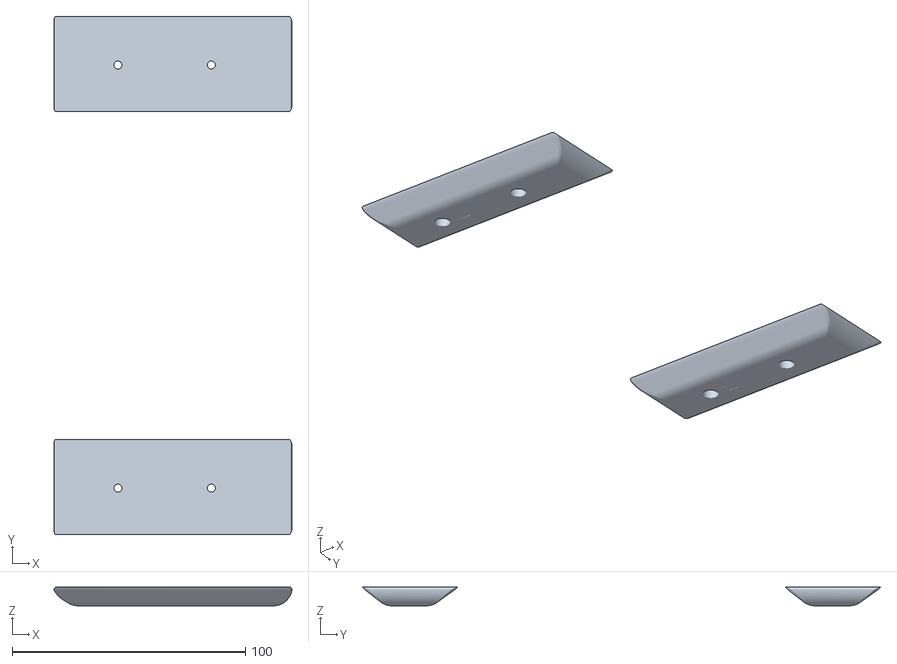
[picture p104: CAD file, 2026-11-05]
cad/microduck/previews/full/asm/tpu.stl
101.9 x 221.9 x 8.00
