HemangVora/OpenDuck/cad/microduck/previews/v3/asm/tpu.stl

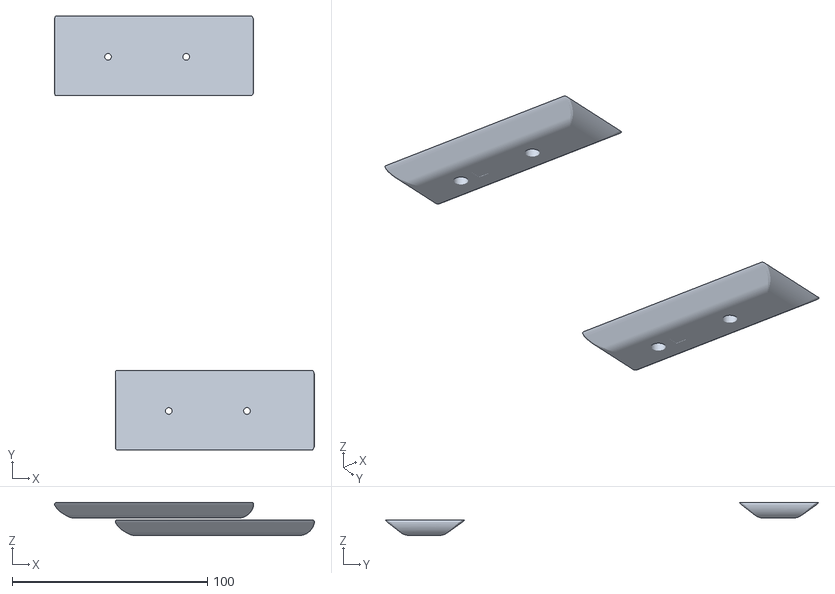
[picture p105: CAD file, 2026-11-05]
cad/microduck/previews/v3/asm/tpu.stl
133.0 x 221.9 x 16.9
