HemangVora/OpenDuck/cad/microduck/stl/head_jaw.stl

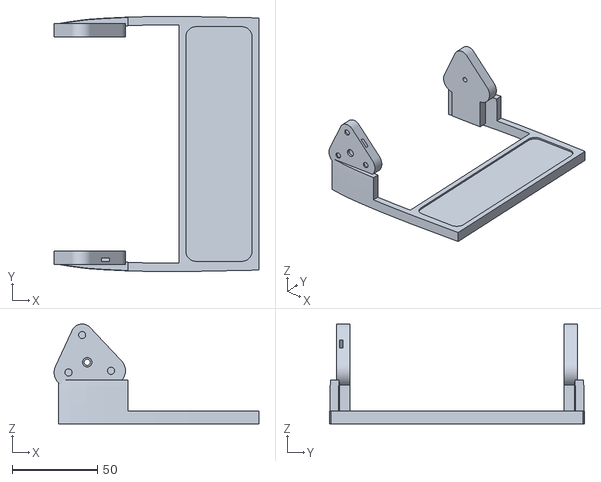
[picture p106: CAD file, 2026-11-05]
cad/microduck/stl/head_jaw.stl
120.5 x 150.0 x 58.8
