HemangVora/OpenDuck/print/3mf/4_body_stock.3mf

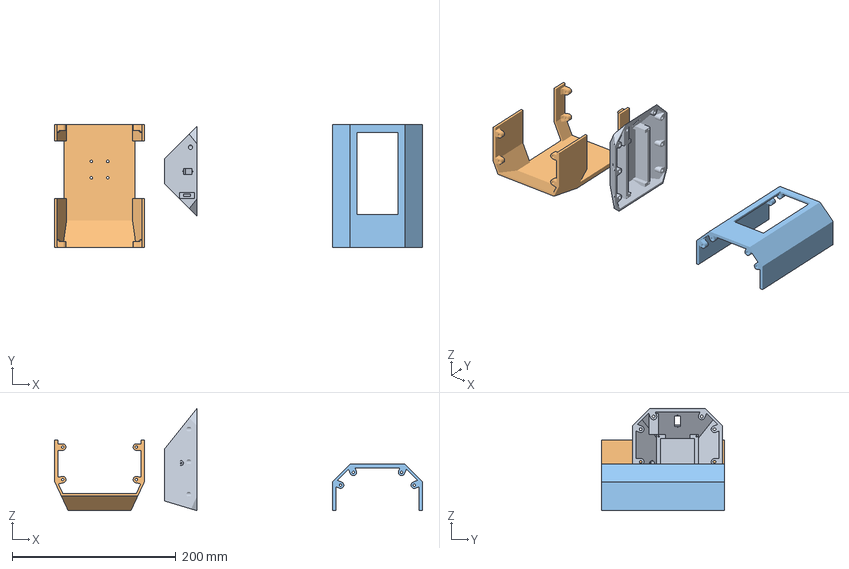
[picture p107: CAD file, 2026-11-05]
print/3mf/4_body_stock.3mf
449.2 x 150.0 x 125.0 mm
body_back.stl
body_middle_bottom.stl
body_middle_top.stl
