HemangVora/OpenDuck/print/microduck_look/oriented/md_body_front_c.stl

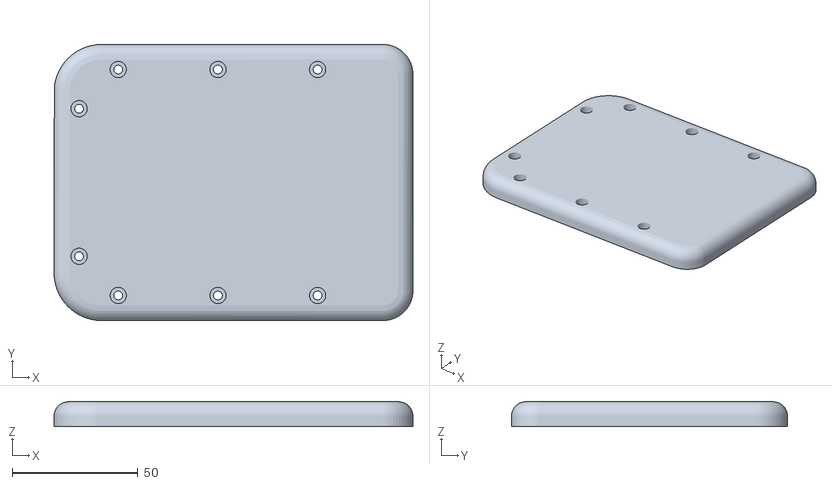
[picture p108: CAD file, 2026-11-05]
print/microduck_look/oriented/md_body_front_c.stl
143.0 x 110.0 x 10.0
