HemangVora/OpenDuck/print/microduck_look/stl/md_body_back.stl

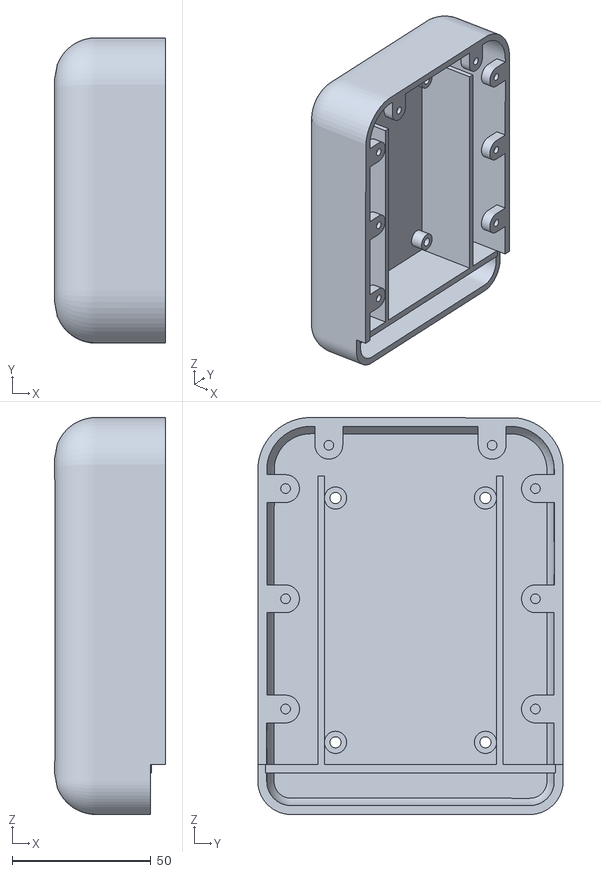
[picture p109: CAD file, 2026-11-05]
print/microduck_look/stl/md_body_back.stl
40.0 x 110.0 x 143.0
