HemangVora/OpenDuck/print/microduck_v3/3mf/14b_sole_plates_white.3mf

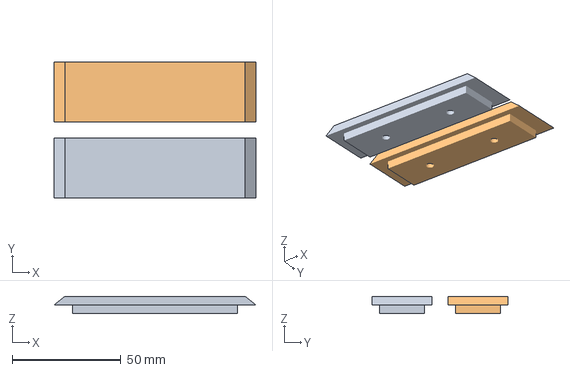
[picture p110: CAD file, 2026-11-05]
print/microduck_v3/3mf/14b_sole_plates_white.3mf
93.0 x 62.7 x 8.00 mm
14b__0_foot_bottom_pla.stl
14b__1_foot_bottom_pla.stl
