HemangVora/OpenDuck/print/oriented/knee_to_ankle_right_sheet.stl

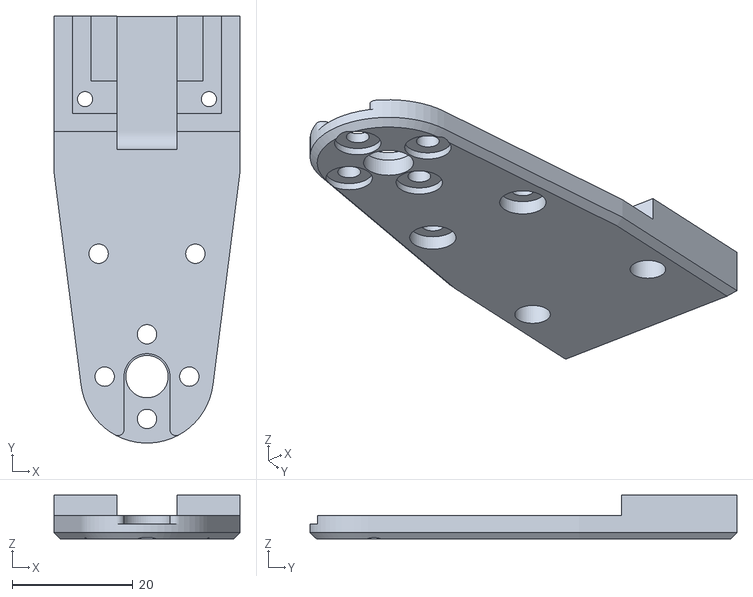
[picture p112: CAD file, 2026-11-05]
print/oriented/knee_to_ankle_right_sheet.stl
30.7 x 70.6 x 7.20
