HemangVora/OpenDuck/cad/microduck/_v2_backup/stl/v_bms.stl

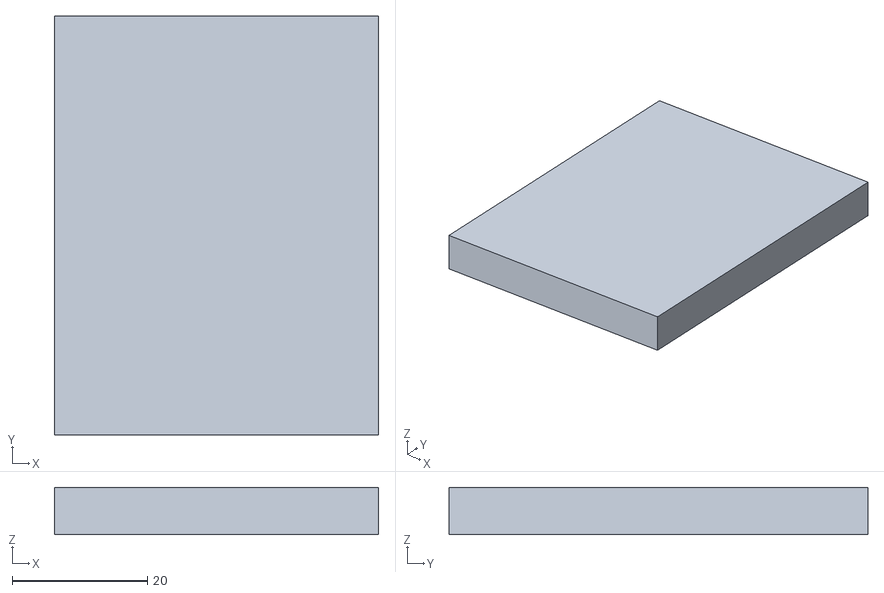
[picture p113: CAD file, 2026-11-05]
cad/microduck/_v2_backup/stl/v_bms.stl
48.0 x 62.0 x 7.00
