HemangVora/OpenDuck/cad/microduck/previews/compare/ref_blue.stl

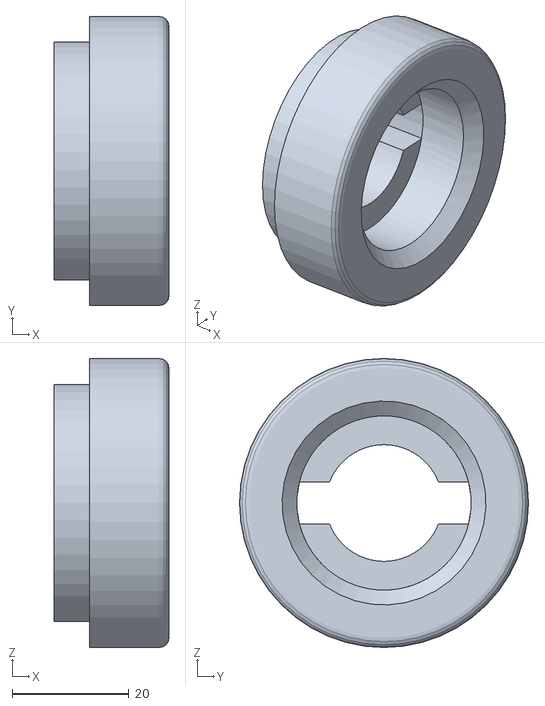
[picture p114: CAD file, 2026-11-05]
cad/microduck/previews/compare/ref_blue.stl
19.7 x 49.6 x 49.6
