HemangVora/OpenDuck/cad/microduck/previews/full/asm/white.stl

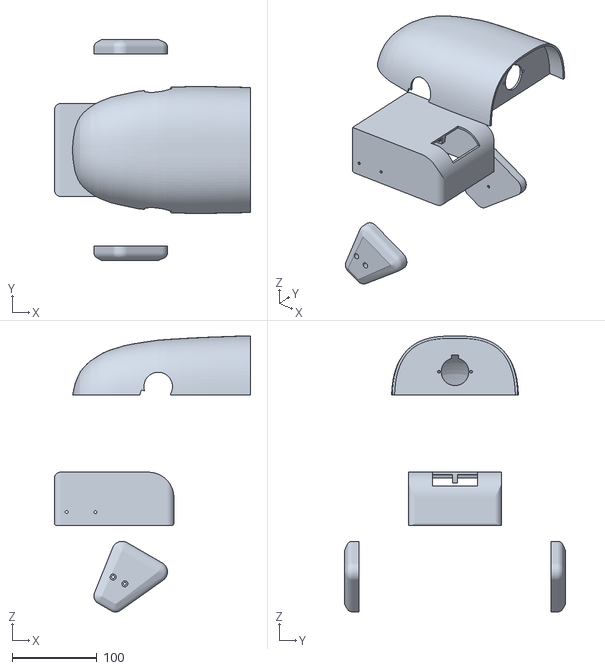
[picture p115: CAD file, 2026-11-05]
cad/microduck/previews/full/asm/white.stl
231.5 x 261.0 x 325.5
