HemangVora/OpenDuck/cad/microduck/previews/v3/asm/black.stl

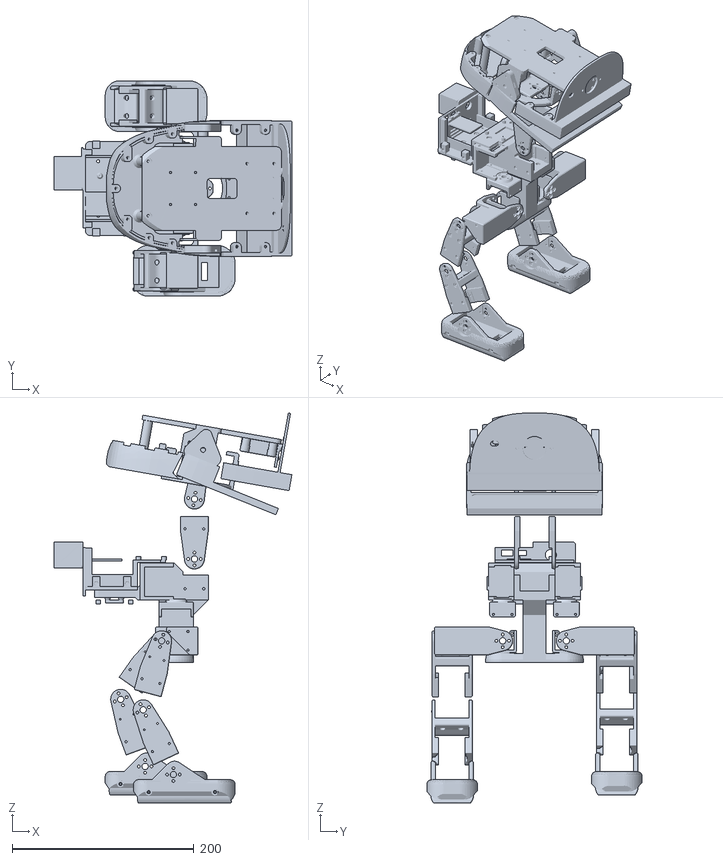
[picture p116: CAD file, 2026-11-05]
cad/microduck/previews/v3/asm/black.stl
261.8 x 237.1 x 429.3
