HemangVora/OpenDuck/cad/microduck/stl/md_foot_top.stl

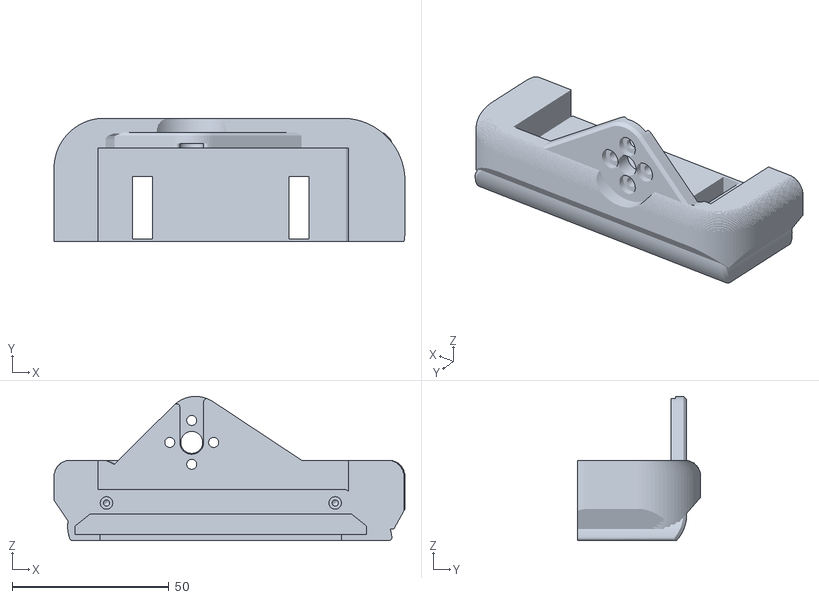
[picture p117: CAD file, 2026-11-05]
cad/microduck/stl/md_foot_top.stl
112.0 x 39.4 x 46.0
