HemangVora/OpenDuck/print/3mf/6a_head_small.3mf

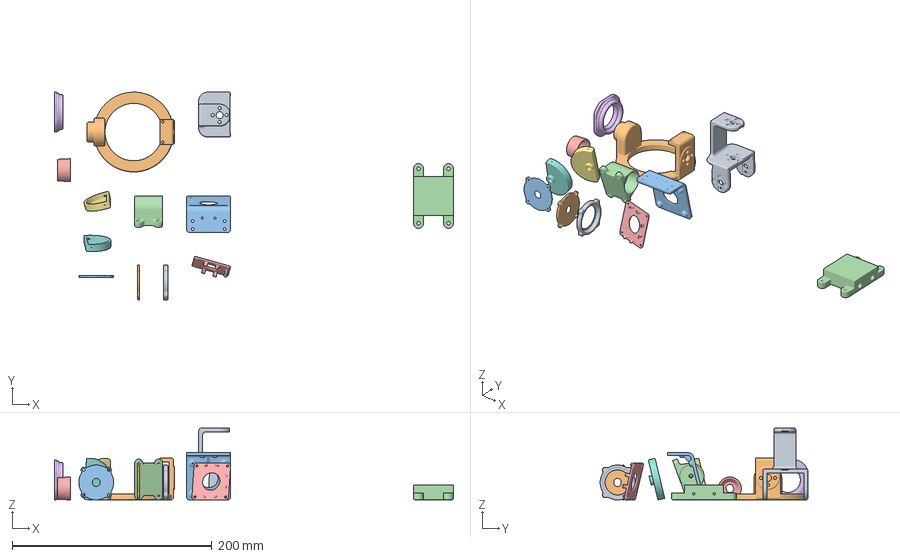
[picture p118: CAD file, 2026-11-05]
print/3mf/6a_head_small.3mf
399.5 x 208.0 x 72.0 mm
head_pitch_to_yaw.stl
head_yaw_to_roll.stl
speaker_stand.stl
flash_light_module.stl
speaker_interface.stl
right_eye.stl
left_antenna_holder.stl
right_antenna_holder.stl
left_eye.stl
bulb.stl_1
bulb.stl_2
head_roll_mount.stl
flash_reflector_interface.stl
