HemangVora/OpenDuck/print/microduck_v3/3mf/11a_head_shell_white.3mf

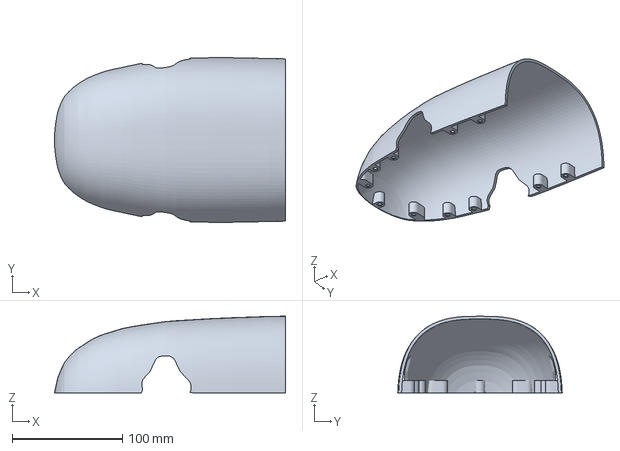
[picture p119: CAD file, 2026-11-05]
print/microduck_v3/3mf/11a_head_shell_white.3mf
210.0 x 149.6 x 69.6 mm
