HemangVora/OpenDuck/print/microduck_v3/oriented/layout/12b__0_head_chassis.stl

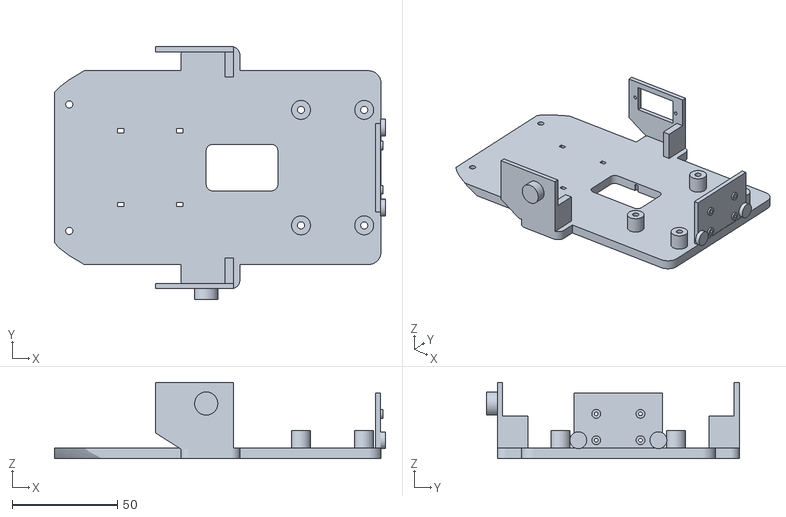
[picture p120: CAD file, 2026-11-05]
print/microduck_v3/oriented/layout/12b__0_head_chassis.stl
157.1 x 119.9 x 36.1
