HemangVora/OpenDuck/print/oriented/battery_pack_lid.stl

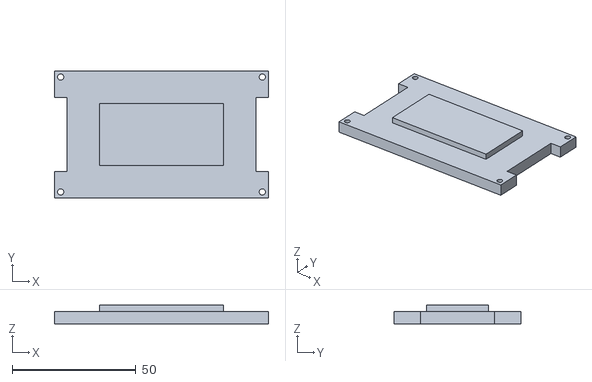
[picture p121: CAD file, 2026-11-05]
print/oriented/battery_pack_lid.stl
86.4 x 51.4 x 7.50
