HemangVora/OpenDuck/cad/microduck/_v2_backup/stl/body_shell_right.stl

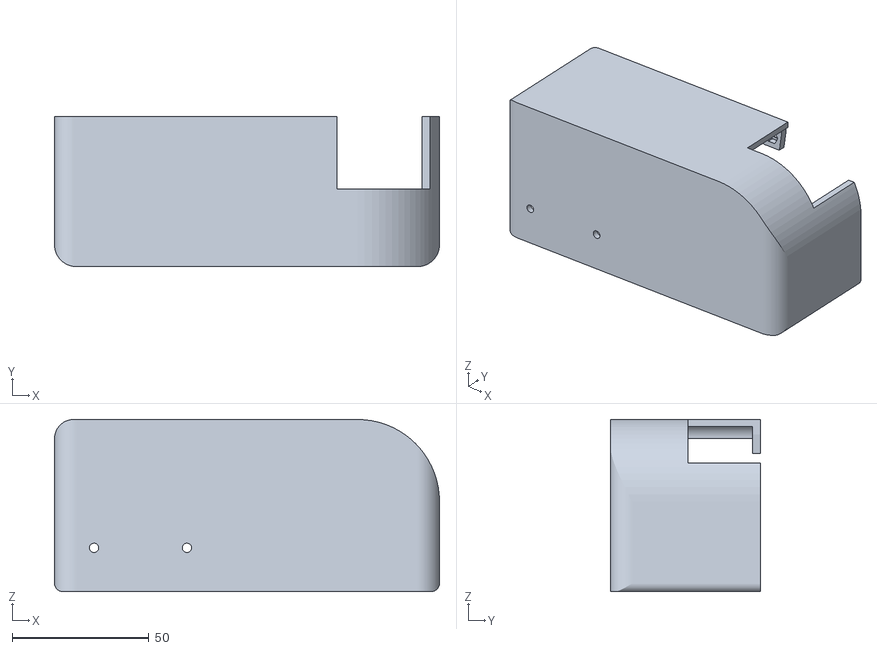
[picture p122: CAD file, 2026-11-05]
cad/microduck/_v2_backup/stl/body_shell_right.stl
141.0 x 55.0 x 63.0
