HemangVora/OpenDuck/cad/microduck/previews/compare/ref_purple.stl

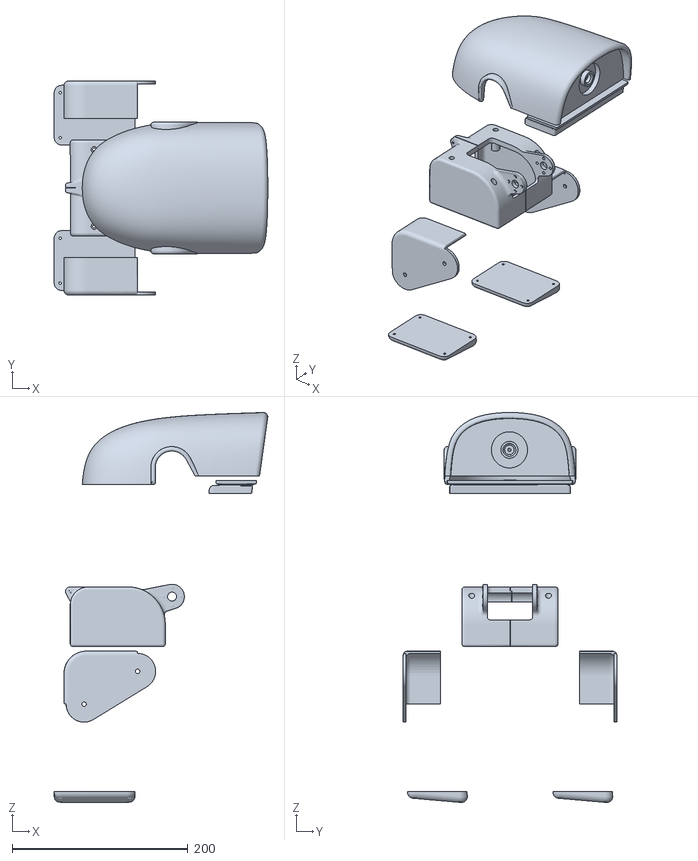
[picture p123: CAD file, 2026-11-05]
cad/microduck/previews/compare/ref_purple.stl
242.8 x 243.2 x 443.3
