HemangVora/OpenDuck/cad/microduck/previews/full/asm/vit.stl

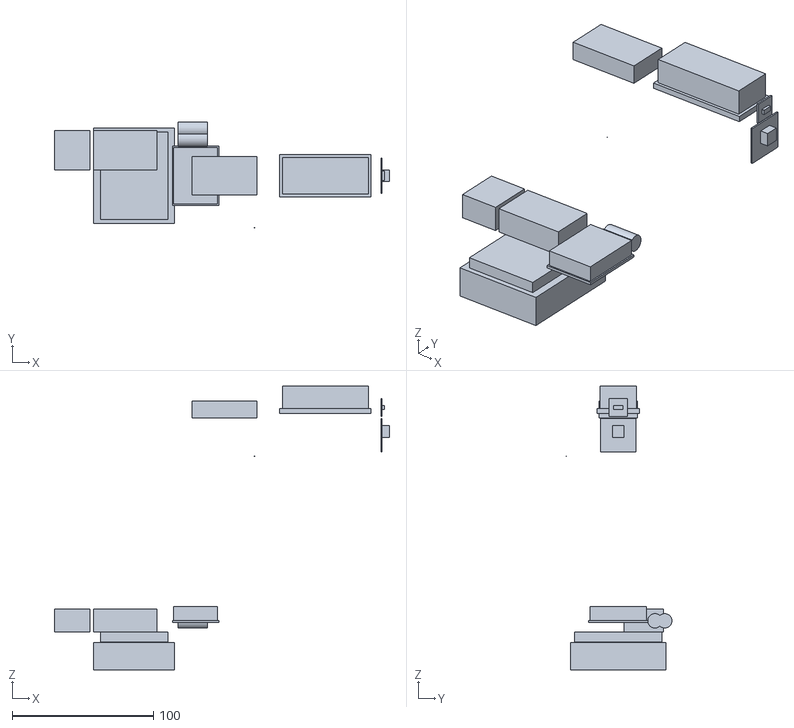
[picture p124: CAD file, 2026-11-05]
cad/microduck/previews/full/asm/vit.stl
237.5 x 75.1 x 201.2
