HemangVora/OpenDuck/cad/microduck/stl/thigh_pillow_left.stl

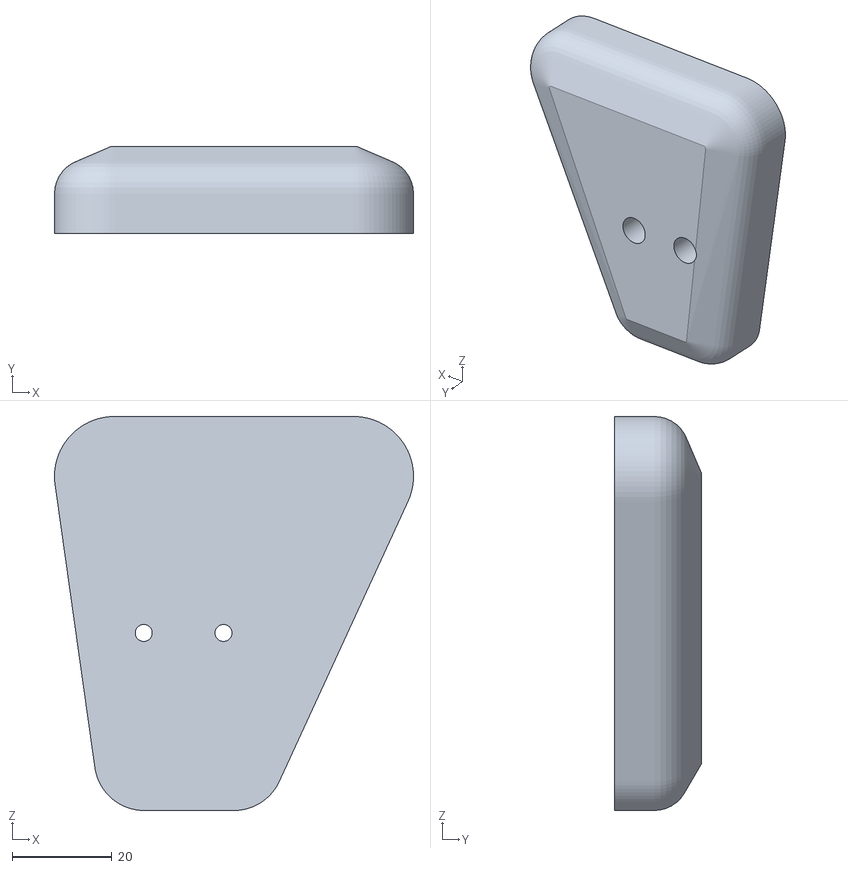
[picture p125: CAD file, 2026-11-05]
cad/microduck/stl/thigh_pillow_left.stl
72.0 x 17.5 x 79.0
