HemangVora/OpenDuck/print/3mf/1_feet_orange.3mf

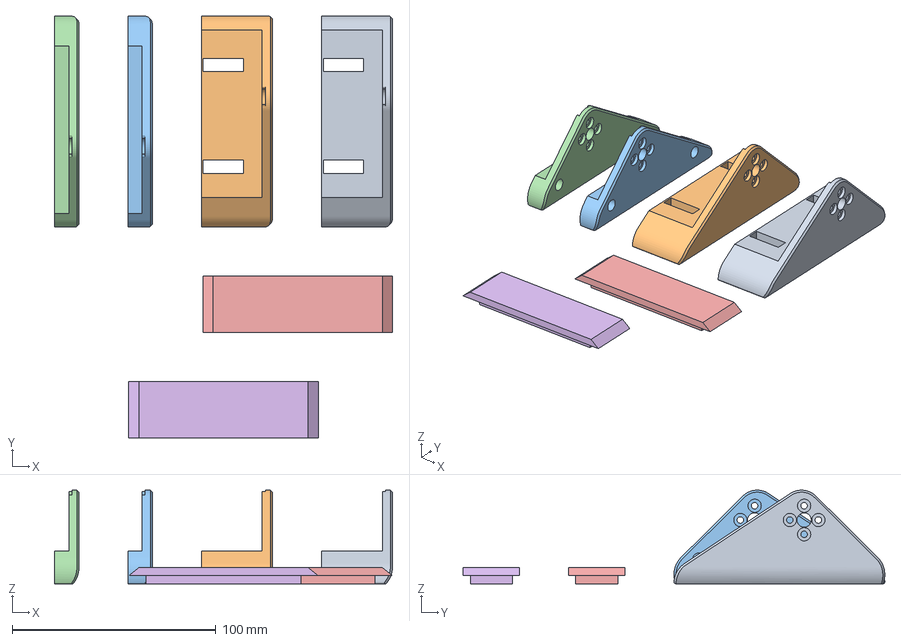
[picture p126: CAD file, 2026-11-05]
print/3mf/1_feet_orange.3mf
165.8 x 206.9 x 46.0 mm
foot_top.stl_1
foot_top.stl_2
foot_side.stl_1
foot_side.stl_2
foot_bottom_pla.stl_1
foot_bottom_pla.stl_2
