HemangVora/OpenDuck/print/microduck_look/stl/md_head_tray.stl

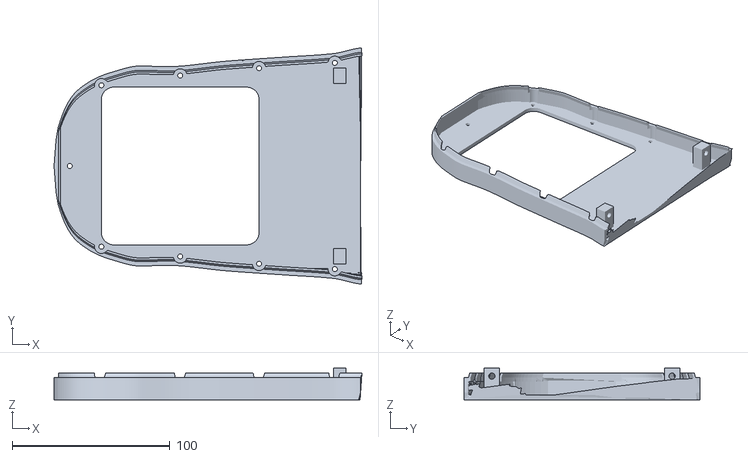
[picture p127: CAD file, 2026-11-05]
print/microduck_look/stl/md_head_tray.stl
195.2 x 149.6 x 20.0
