HemangVora/OpenDuck/print/microduck_v3/3mf/15_pla_soles_rubber_1.0mm_black.3mf

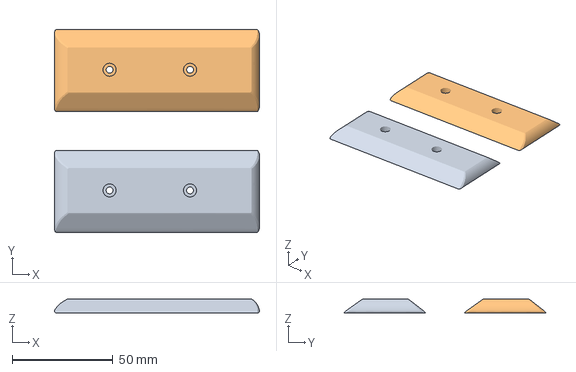
[picture p128: CAD file, 2026-11-05]
print/microduck_v3/3mf/15_pla_soles_rubber_1.0mm_black.3mf
101.9 x 100.7 x 6.99 mm
15_T1.0__sole_0.stl
15_T1.0__sole_1.stl
