HemangVora/OpenDuck/print/microduck_v3/oriented/layout/11d14b__1_mouth_jaw.stl

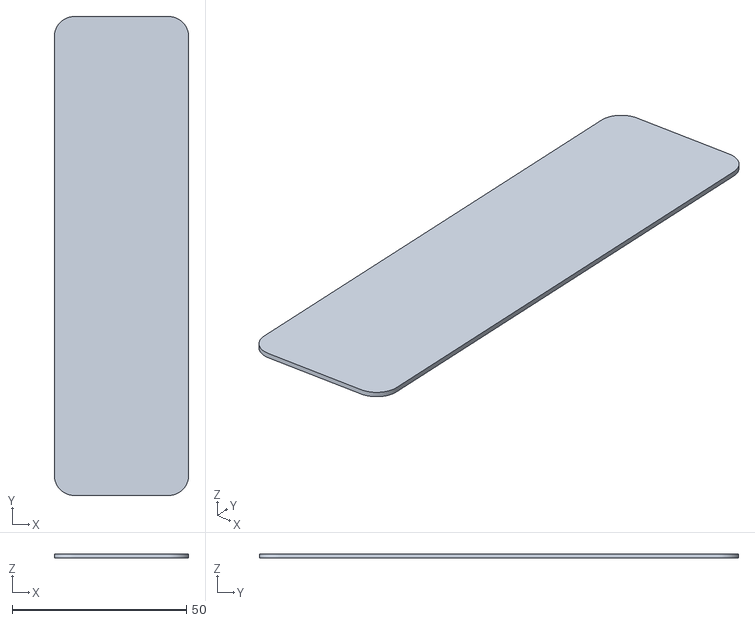
[picture p129: CAD file, 2026-11-05]
print/microduck_v3/oriented/layout/11d14b__1_mouth_jaw.stl
38.6 x 137.6 x 1.15
