HemangVora/OpenDuck/print/oriented/neck_left_sheet.stl

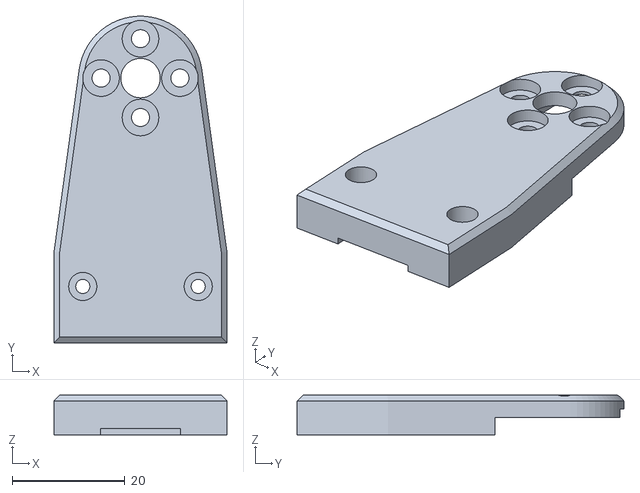
[picture p130: CAD file, 2026-11-05]
print/oriented/neck_left_sheet.stl
30.7 x 58.0 x 7.05
