HemangVora/OpenDuck/cad/microduck/previews/compare/ref_eye.stl

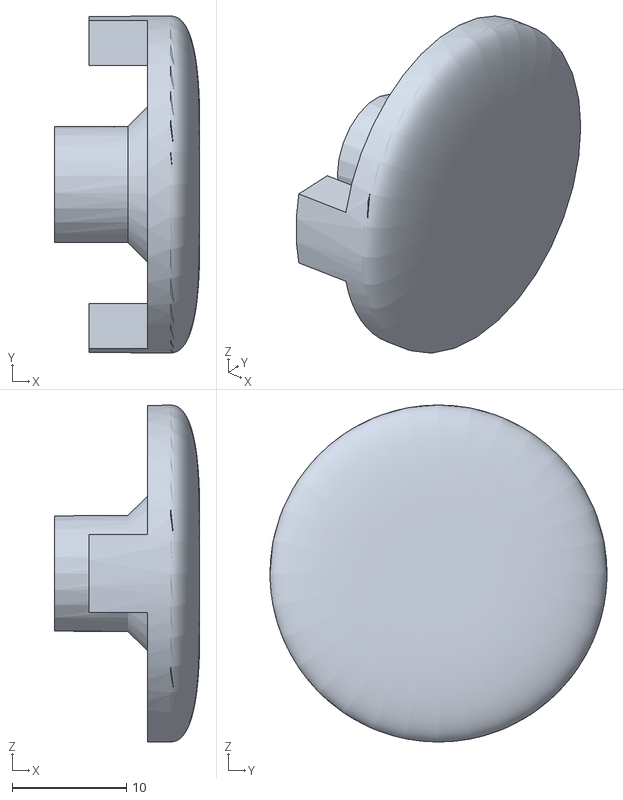
[picture p131: CAD file, 2026-11-05]
cad/microduck/previews/compare/ref_eye.stl
12.8 x 29.5 x 29.5
