HemangVora/OpenDuck/cad/microduck/stl/v_sg90_jaw.stl

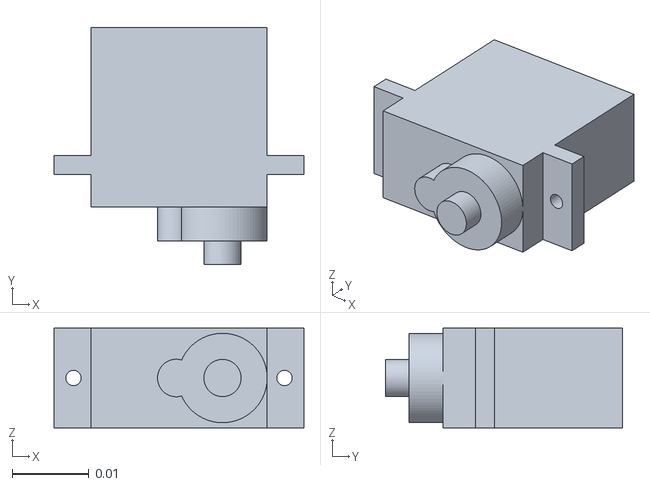
[picture p132: CAD file, 2026-11-05]
cad/microduck/stl/v_sg90_jaw.stl
0.0326 x 0.031 x 0.013
