HemangVora/OpenDuck/print/3mf/8_tpu_soles.3mf

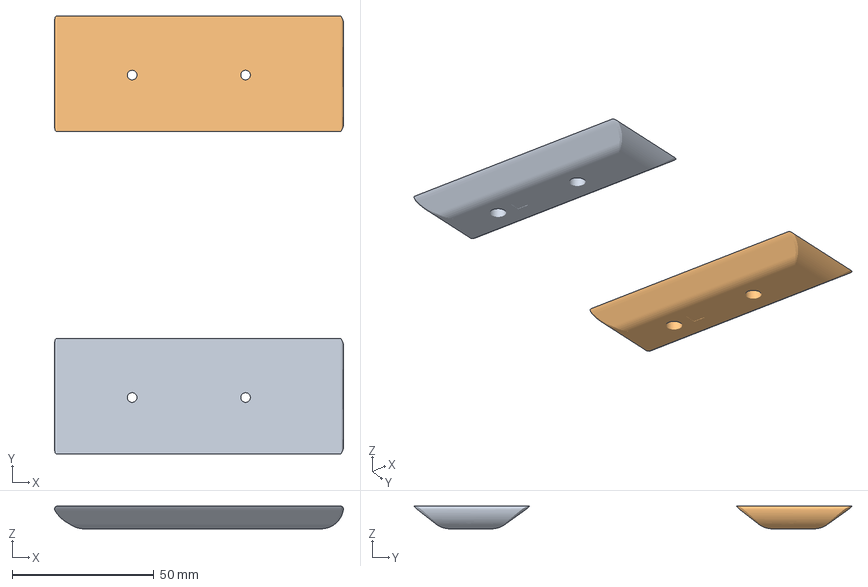
[picture p133: CAD file, 2026-11-05]
print/3mf/8_tpu_soles.3mf
101.9 x 154.5 x 8.00 mm
foot_bottom_tpu.stl_1
foot_bottom_tpu.stl_2
