HemangVora/OpenDuck/print/microduck_look/oriented/md_cam_ring.stl

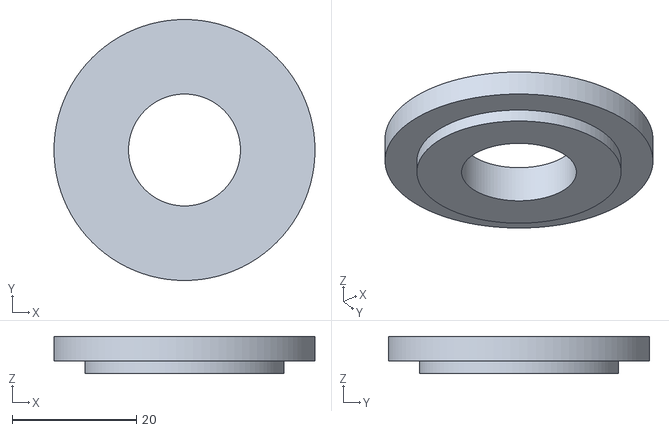
[picture p134: CAD file, 2026-11-05]
print/microduck_look/oriented/md_cam_ring.stl
42.0 x 42.0 x 6.00
