HemangVora/OpenDuck/print/microduck_look/stl/md_head_top.stl

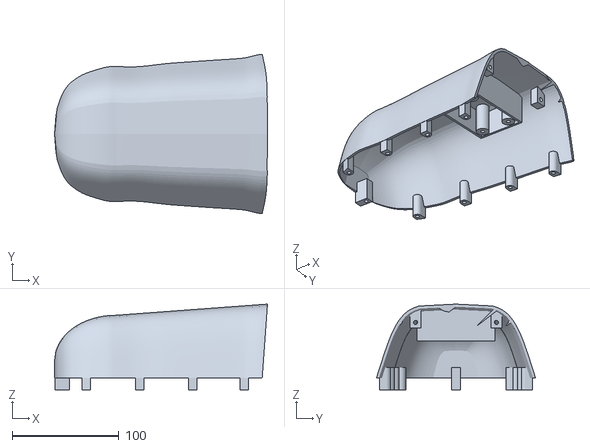
[picture p135: CAD file, 2026-11-05]
print/microduck_look/stl/md_head_top.stl
200.0 x 149.6 x 80.6
