HemangVora/OpenDuck/print/microduck_v3/3mf/12c_body_black.3mf

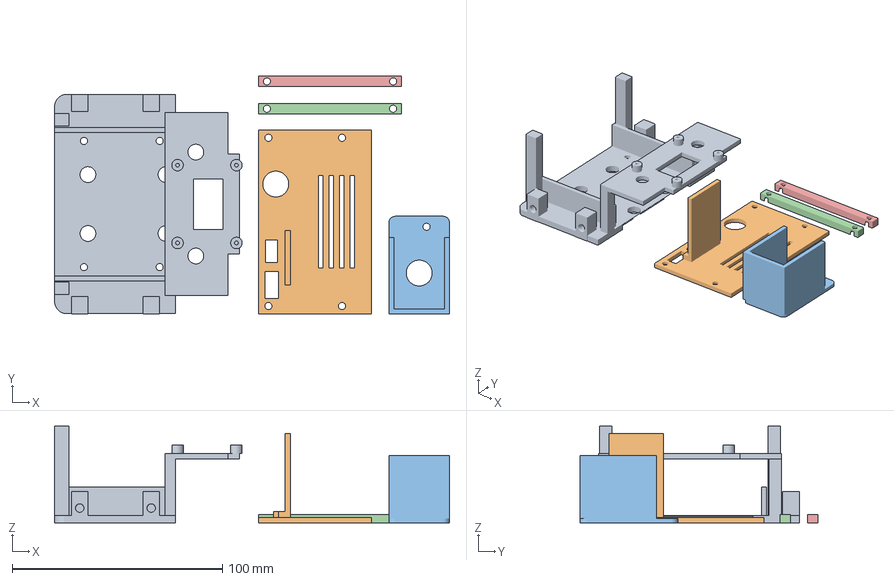
[picture p136: CAD file, 2026-11-05]
print/microduck_v3/3mf/12c_body_black.3mf
187.8 x 113.0 x 46.0 mm
12c__body_deck.stl
12c__body_panel.stl
12c__switch_guard.stl
12c__deck_clamp_rear.stl
12c__deck_clamp_front.stl
