HemangVora/OpenDuck/print/oriented/neck_right_sheet.stl

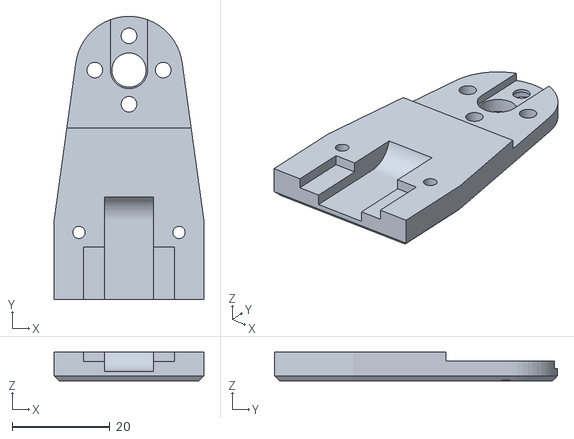
[picture p137: CAD file, 2026-11-05]
print/oriented/neck_right_sheet.stl
30.7 x 58.0 x 5.85
