HemangVora/OpenDuck/cad/microduck/_v2_backup/stl/head_jaw.stl

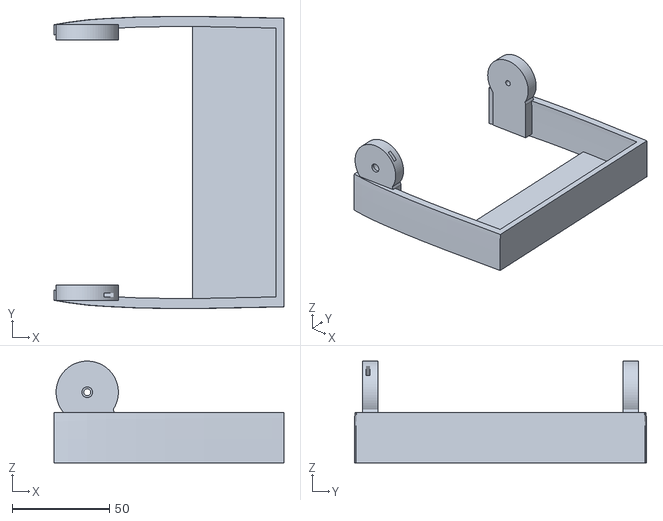
[picture p138: CAD file, 2026-11-05]
cad/microduck/_v2_backup/stl/head_jaw.stl
118.0 x 150.0 x 52.3
