HemangVora/OpenDuck/cad/microduck/stl/v_xt30.stl

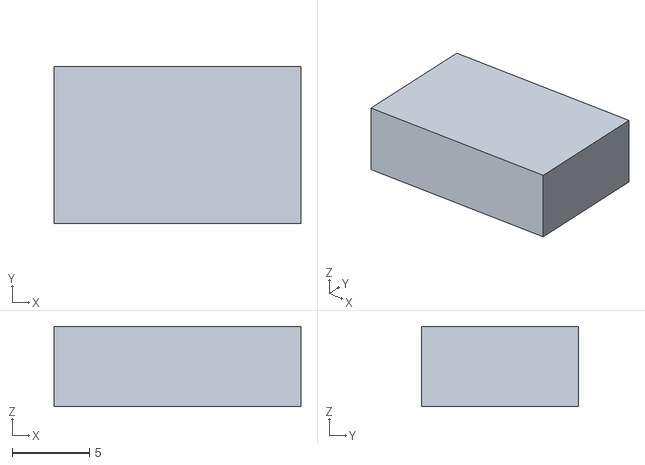
[picture p139: CAD file, 2026-11-05]
cad/microduck/stl/v_xt30.stl
16.0 x 10.2 x 5.20
