HemangVora/OpenDuck/print/3mf/3_trunk.3mf

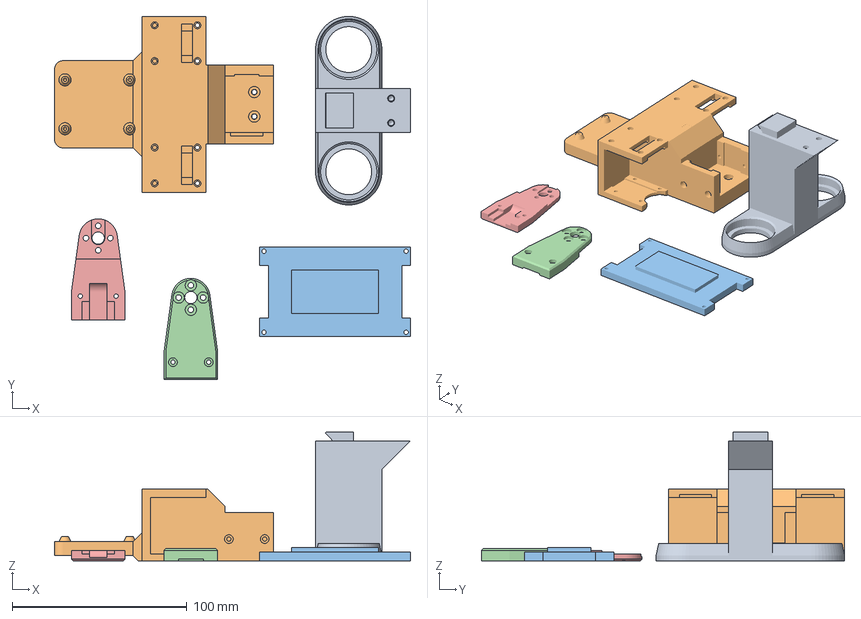
[picture p140: CAD file, 2026-11-05]
print/3mf/3_trunk.3mf
203.8 x 208.0 x 73.7 mm
trunk_bottom.stl
trunk_top.stl
battery_pack_lid.stl
neck_left_sheet.stl
neck_right_sheet.stl
