HemangVora/OpenDuck/print/microduck_look/3mf/6m_head_mechanism.3mf

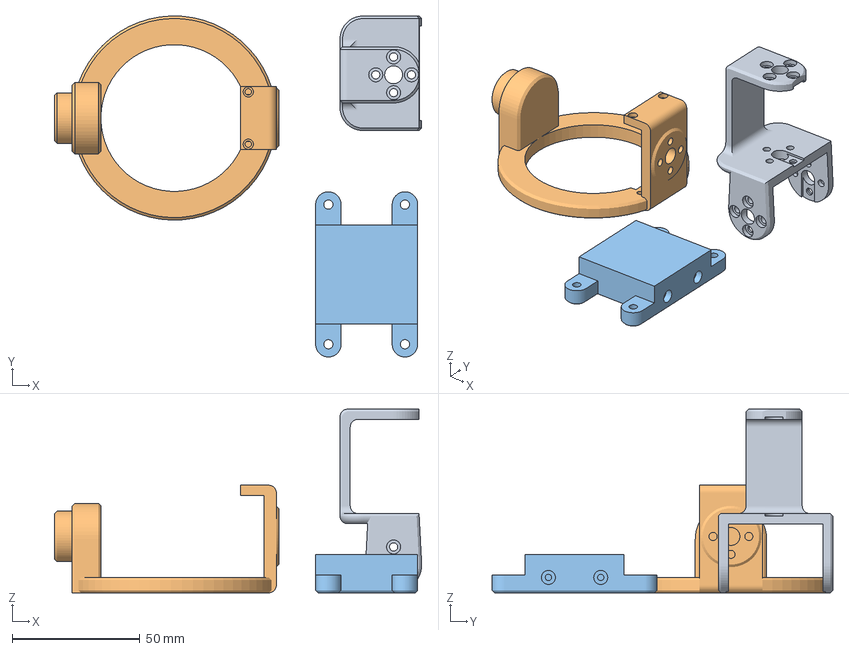
[picture p141: CAD file, 2026-11-05]
print/microduck_look/3mf/6m_head_mechanism.3mf
143.9 x 133.6 x 72.0 mm
head_pitch_to_yaw.stl
head_yaw_to_roll.stl
head_roll_mount.stl
