HemangVora/OpenDuck/print/microduck_v3/3mf/12a_head_jaw_tray_black.3mf

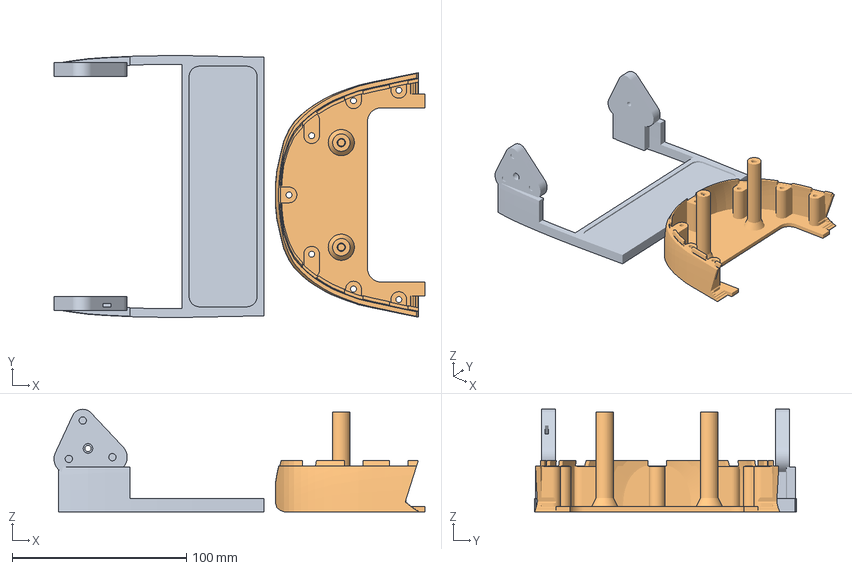
[picture p142: CAD file, 2026-11-05]
print/microduck_v3/3mf/12a_head_jaw_tray_black.3mf
212.8 x 150.0 x 58.8 mm
12a__0_head_jaw.stl
12a__1_head_tray.stl
