HemangVora/OpenDuck/print/oriented/head_bot_sheet.stl

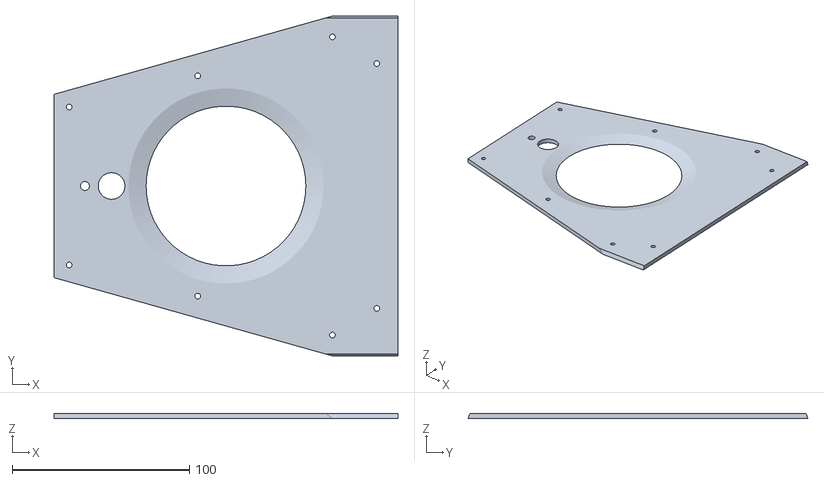
[picture p143: CAD file, 2026-11-05]
print/oriented/head_bot_sheet.stl
193.8 x 191.6 x 3.00
