HemangVora/OpenDuck/cad/microduck/_v2_backup/stl/deck_clamp_rear.stl

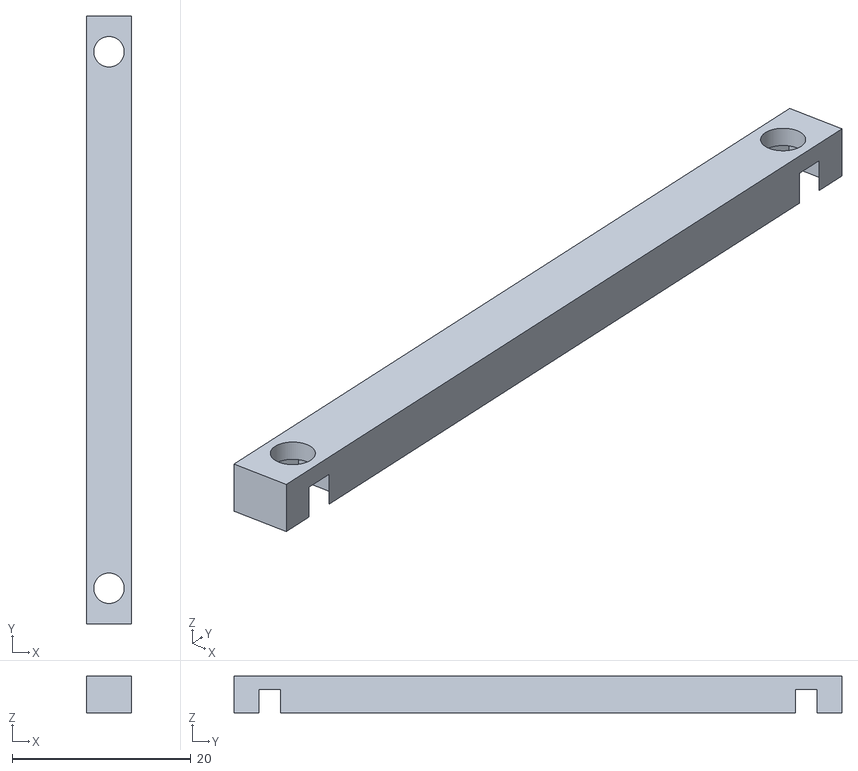
[picture p144: CAD file, 2026-11-05]
cad/microduck/_v2_backup/stl/deck_clamp_rear.stl
5.00 x 68.0 x 4.10
