HemangVora/OpenDuck/print/3mf/5_body_front.3mf

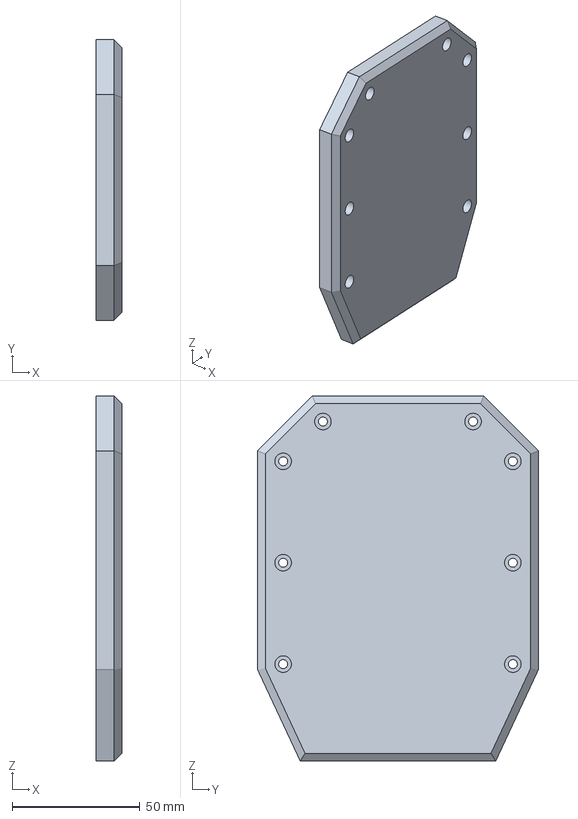
[picture p145: CAD file, 2026-11-05]
print/3mf/5_body_front.3mf
10.0 x 110.0 x 143.0 mm
