HemangVora/OpenDuck/print/microduck_v3/3mf/11d_eye_mouth_white.3mf

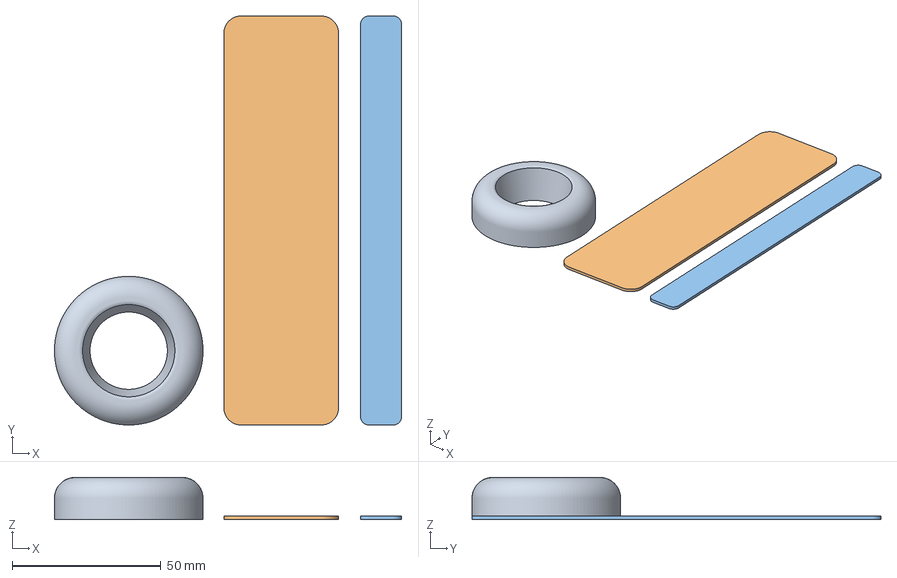
[picture p146: CAD file, 2026-11-05]
print/microduck_v3/3mf/11d_eye_mouth_white.3mf
116.8 x 137.6 x 14.2 mm
11d__0_eye_ring.stl
11d__1_mouth_jaw.stl
11d__2_mouth_bill.stl
