HemangVora/OpenDuck/print/microduck_v3/oriented/layout/st__2_foot_side.stl

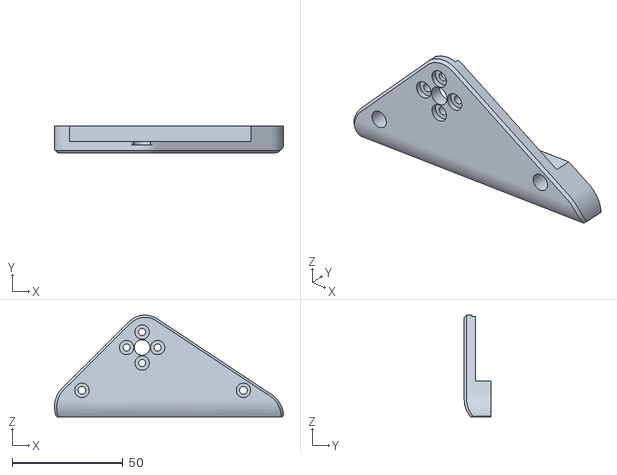
[picture p147: CAD file, 2026-11-05]
print/microduck_v3/oriented/layout/st__2_foot_side.stl
103.5 x 12.0 x 46.0
