HemangVora/OpenDuck/cad/microduck/_v2_backup/stl/v_switch.stl

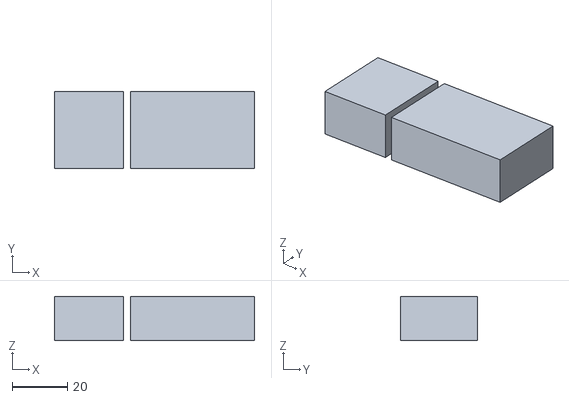
[picture p148: CAD file, 2026-11-05]
cad/microduck/_v2_backup/stl/v_switch.stl
72.5 x 28.0 x 16.0
