HemangVora/OpenDuck/print/microduck_look/stl/md_face_plate.stl

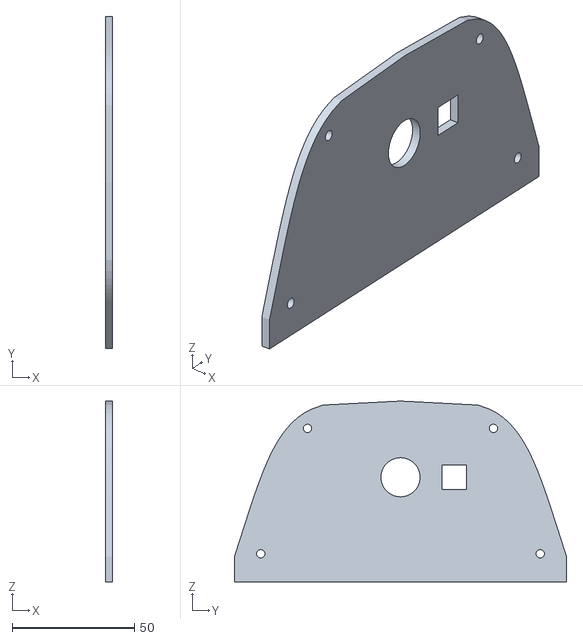
[picture p149: CAD file, 2026-11-05]
print/microduck_look/stl/md_face_plate.stl
3.00 x 135.7 x 74.0
