HemangVora/OpenDuck/print/microduck_v3/3mf/11b_body_shells_white.3mf

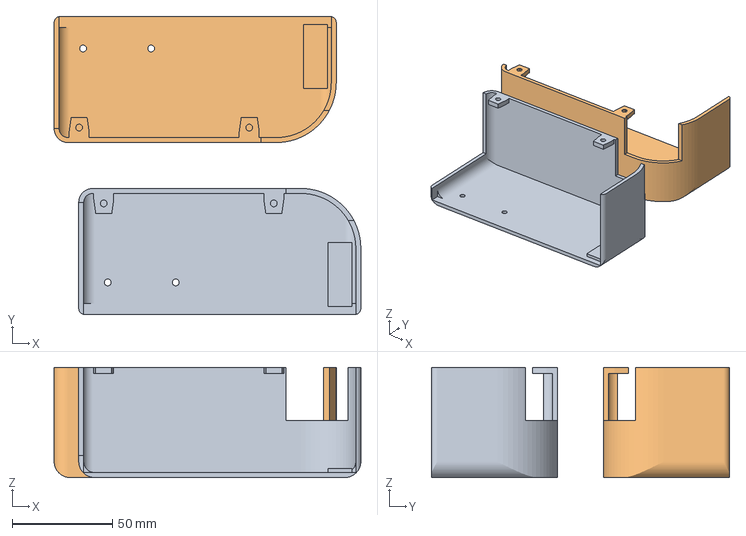
[picture p150: CAD file, 2026-11-05]
print/microduck_v3/3mf/11b_body_shells_white.3mf
153.3 x 148.9 x 55.0 mm
11b__body_shell_left.stl
11b__body_shell_right.stl
