HemangVora/OpenDuck/print/microduck_v3/oriented/layout/15_T2.0__sole_0.stl

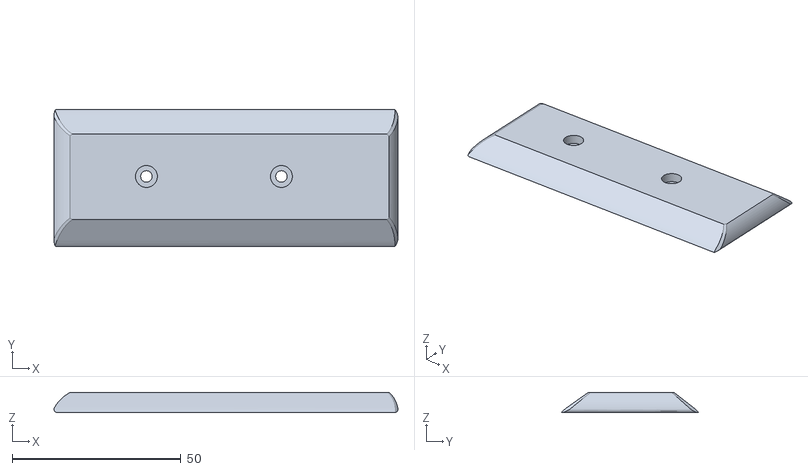
[picture p151: CAD file, 2026-11-05]
print/microduck_v3/oriented/layout/15_T2.0__sole_0.stl
101.9 x 40.7 x 5.99
