HemangVora/OpenDuck/cad/microduck/_v2_backup/stl/v_adapter.stl

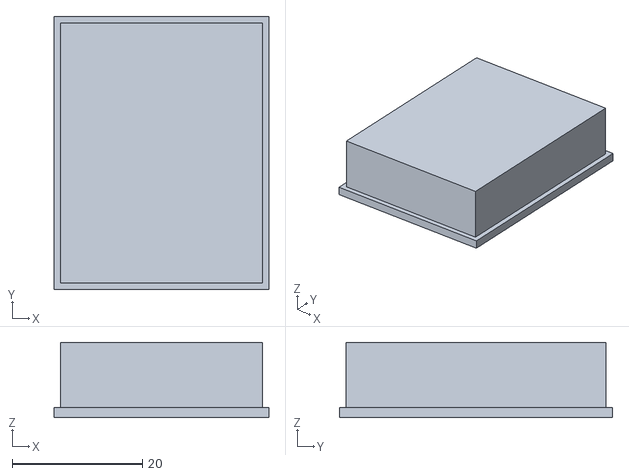
[picture p152: CAD file, 2026-11-05]
cad/microduck/_v2_backup/stl/v_adapter.stl
33.0 x 42.0 x 11.6
