HemangVora/OpenDuck/print/microduck_v3/3mf/14a_feet_black.3mf

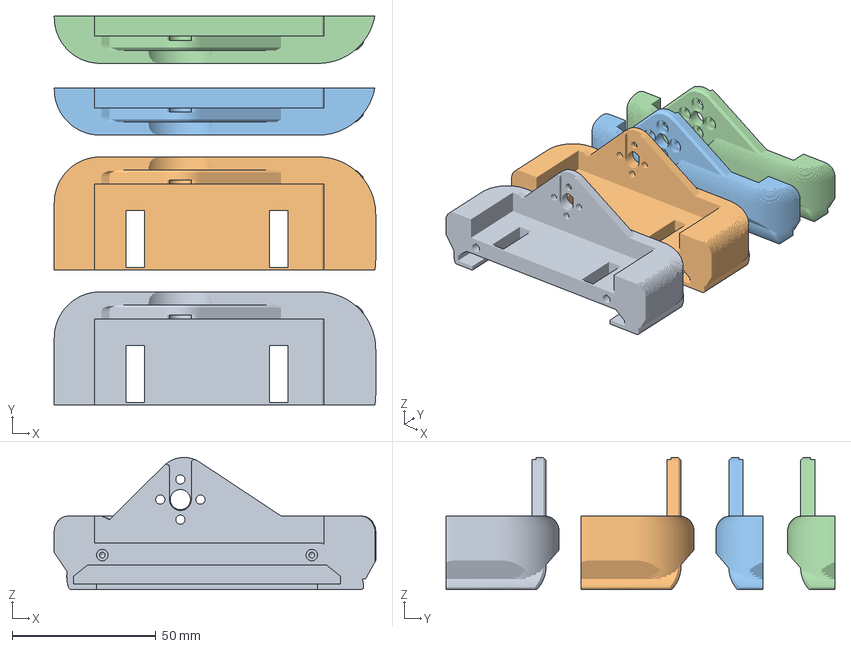
[picture p153: CAD file, 2026-11-05]
print/microduck_v3/3mf/14a_feet_black.3mf
112.0 x 135.5 x 46.0 mm
14a__0_md_foot_top.stl
14a__1_md_foot_top.stl
14a__2_md_foot_side.stl
14a__3_md_foot_side.stl
