HemangVora/OpenDuck/cad/microduck/_v2_backup/stl/v_caps.stl

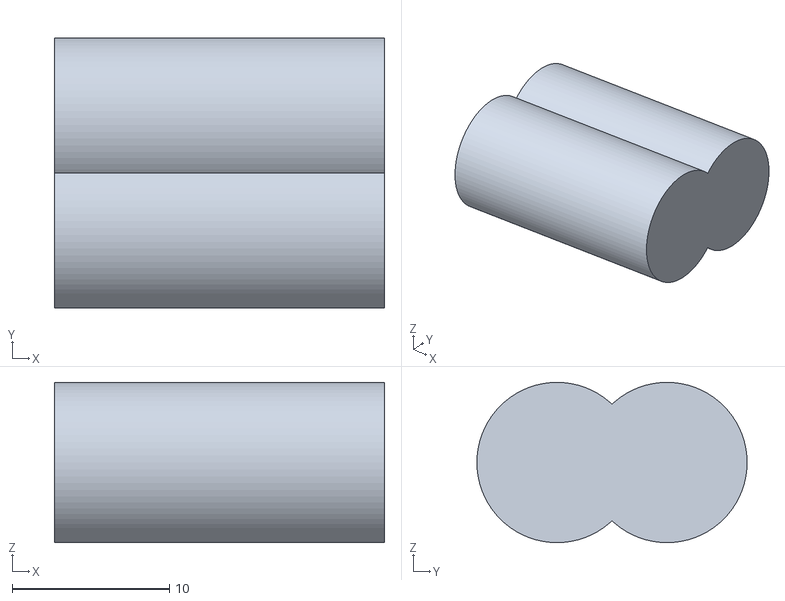
[picture p154: CAD file, 2026-11-05]
cad/microduck/_v2_backup/stl/v_caps.stl
21.0 x 17.2 x 10.2
