HemangVora/OpenDuck/cad/microduck/stl/mouth_bill.stl

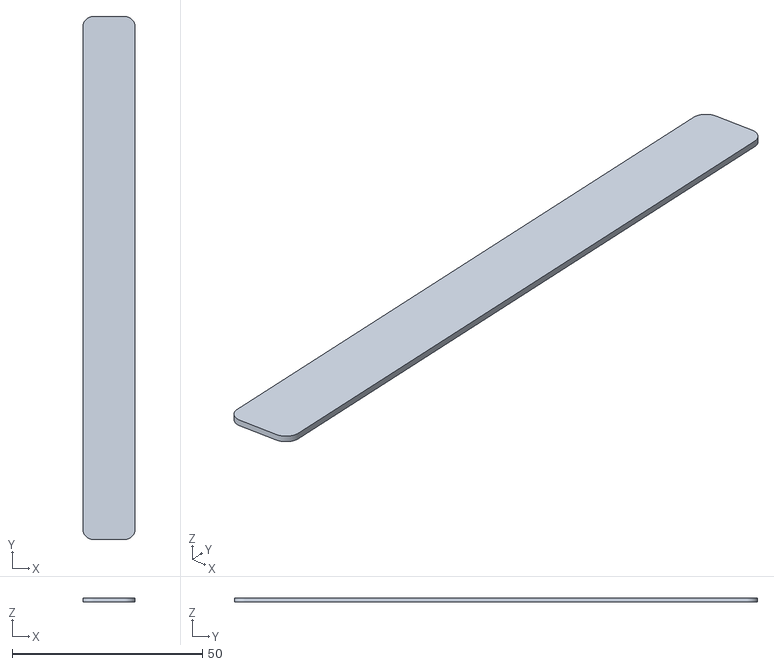
[picture p155: CAD file, 2026-11-05]
cad/microduck/stl/mouth_bill.stl
13.8 x 137.6 x 1.15
