HemangVora/OpenDuck/print/3mf/2b_leg_caches.3mf

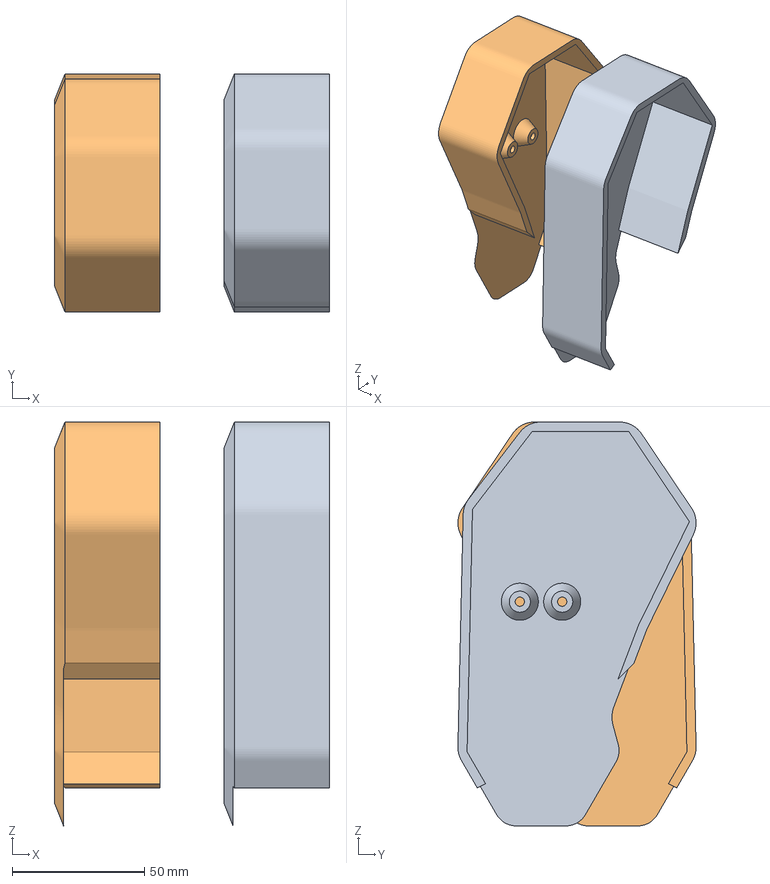
[picture p156: CAD file, 2026-11-05]
print/3mf/2b_leg_caches.3mf
104.0 x 90.0 x 152.6 mm
left_cache.stl
right_cache.stl
