HemangVora/OpenDuck/print/microduck_v3/3mf/11d14b_eye_mouth_soles_white.3mf

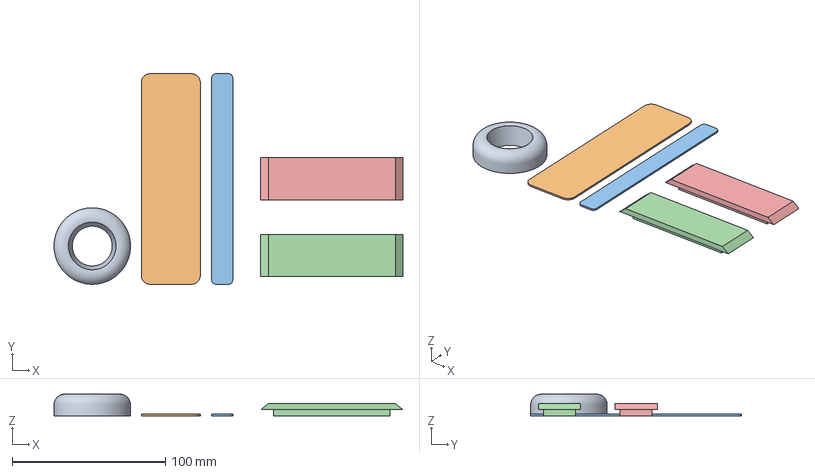
[picture p157: CAD file, 2026-11-05]
print/microduck_v3/3mf/11d14b_eye_mouth_soles_white.3mf
228.0 x 137.6 x 14.2 mm
11d14b__0_eye_ring.stl
11d14b__1_mouth_jaw.stl
11d14b__2_mouth_bill.stl
11d14b__sole_0.stl
11d14b__sole_1.stl
