HemangVora/OpenDuck/cad/microduck/stl/eye_ring.stl

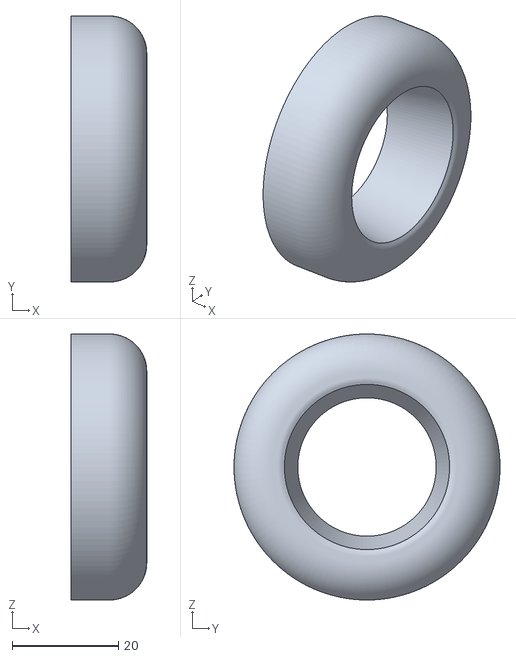
[picture p158: CAD file, 2026-11-05]
cad/microduck/stl/eye_ring.stl
14.2 x 50.0 x 50.0
