HemangVora/OpenDuck/print/microduck_v3/3mf/11c_thigh_pillows_white.3mf

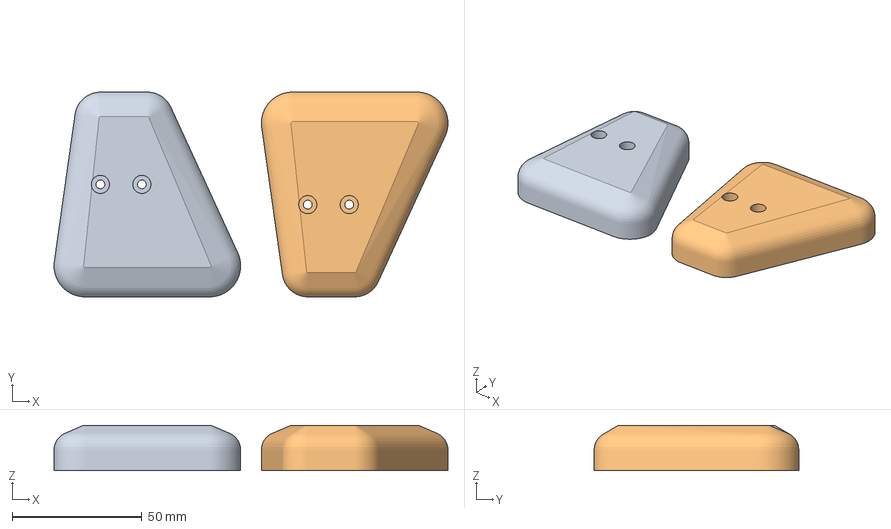
[picture p159: CAD file, 2026-11-05]
print/microduck_v3/3mf/11c_thigh_pillows_white.3mf
152.0 x 79.0 x 17.5 mm
11c__thigh_pillow_left.stl
11c__thigh_pillow_right.stl
