HemangVora/OpenDuck/cad/microduck/stl/md_foot_side.stl

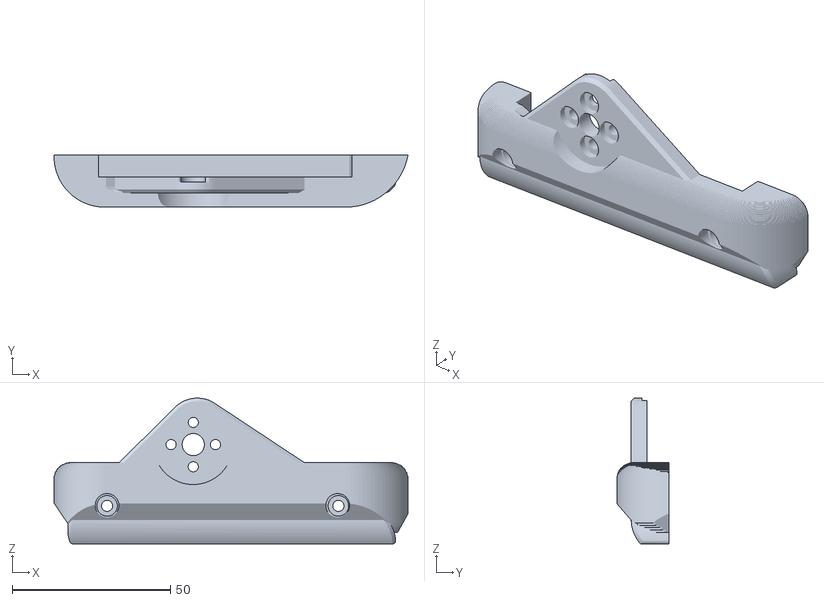
[picture p160: CAD file, 2026-11-05]
cad/microduck/stl/md_foot_side.stl
111.7 x 16.5 x 46.0
