HemangVora/OpenDuck/print/microduck_v3/3mf/12b_chassis_face_black.3mf

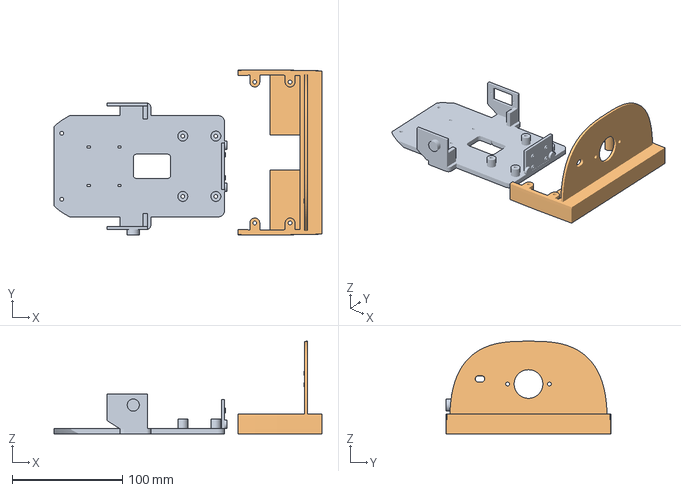
[picture p161: CAD file, 2026-11-05]
print/microduck_v3/3mf/12b_chassis_face_black.3mf
243.4 x 150.0 x 84.1 mm
12b__0_head_chassis.stl
12b__1_face_bill.stl
