HemangVora/OpenDuck/cad/microduck/_v2_backup/stl/v_pack.stl

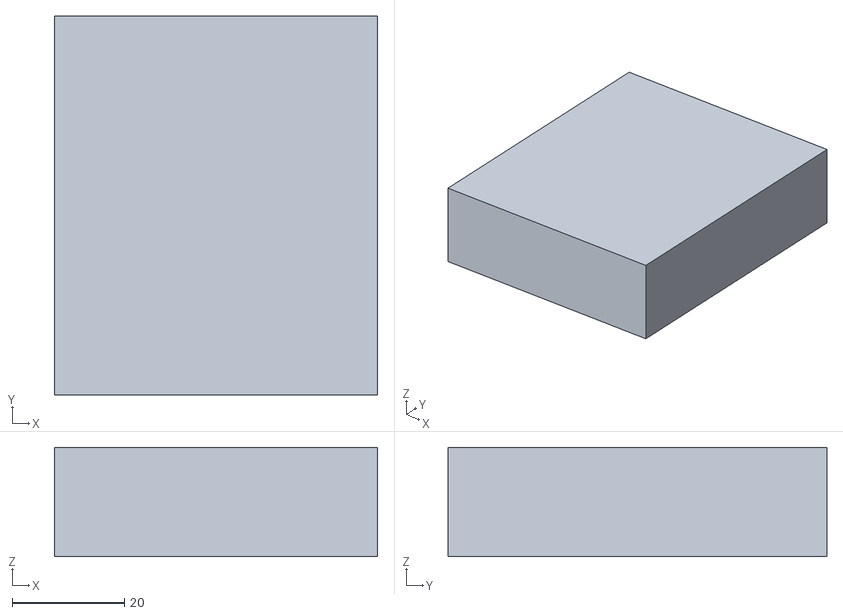
[picture p162: CAD file, 2026-11-05]
cad/microduck/_v2_backup/stl/v_pack.stl
57.5 x 67.4 x 19.4
