HemangVora/OpenDuck/cad/microduck/stl/eye_bezel.stl

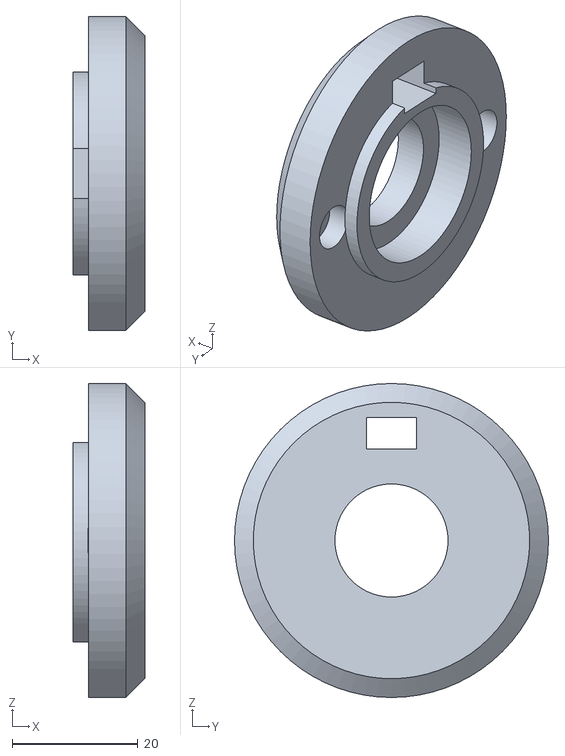
[picture p163: CAD file, 2026-11-05]
cad/microduck/stl/eye_bezel.stl
11.4 x 50.0 x 50.0
