HemangVora/OpenDuck/print/microduck_v3/3mf/11bc_body_shells_pillows_white.3mf

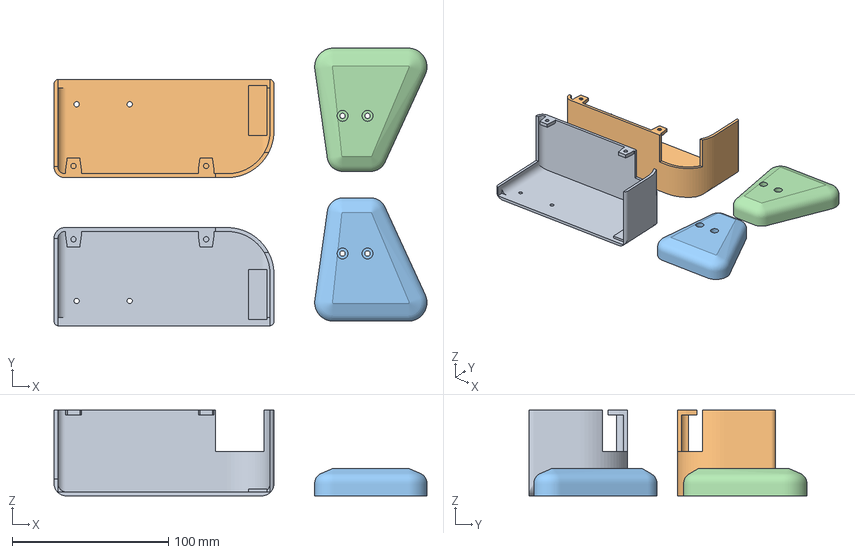
[picture p164: CAD file, 2026-11-05]
print/microduck_v3/3mf/11bc_body_shells_pillows_white.3mf
239.0 x 178.0 x 55.0 mm
11bc__body_shell_left.stl
11bc__body_shell_right.stl
11bc__thigh_pillow_left.stl
11bc__thigh_pillow_right.stl
