HemangVora/OpenDuck/cad/microduck/stl/md_foot_skin_only.stl

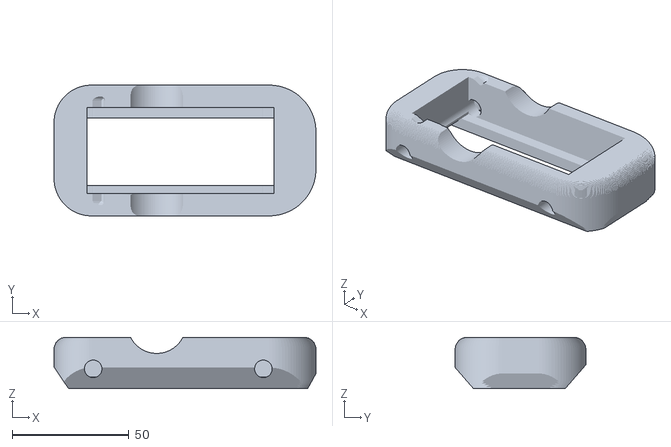
[picture p165: CAD file, 2026-11-05]
cad/microduck/stl/md_foot_skin_only.stl
112.0 x 55.9 x 22.0
