HemangVora/OpenDuck/cad/microduck/_v2_backup/stl/v_tof.stl

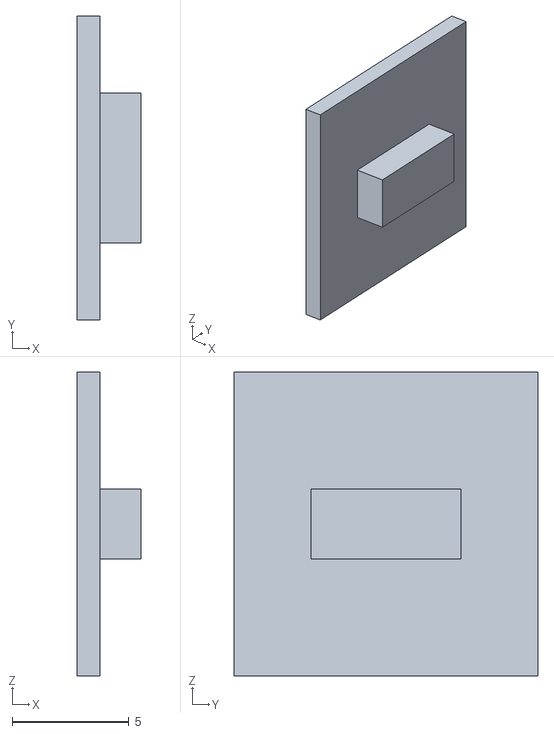
[picture p166: CAD file, 2026-11-05]
cad/microduck/_v2_backup/stl/v_tof.stl
2.75 x 13.0 x 13.0
