HemangVora/OpenDuck/cad/microduck/_v2_backup/stl/body_panel.stl

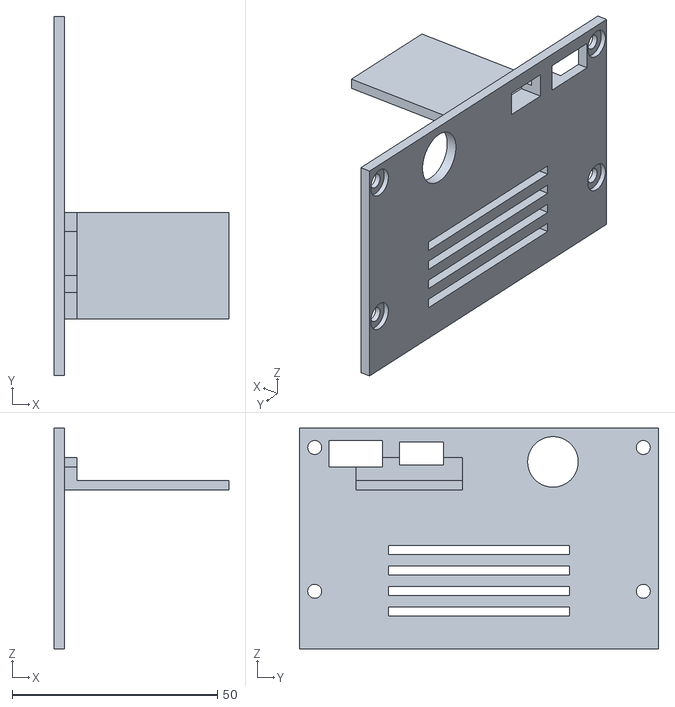
[picture p167: CAD file, 2026-11-05]
cad/microduck/_v2_backup/stl/body_panel.stl
42.5 x 87.4 x 53.7
