HemangVora/OpenDuck/cad/microduck/_v2_backup/stl/switch_guard.stl

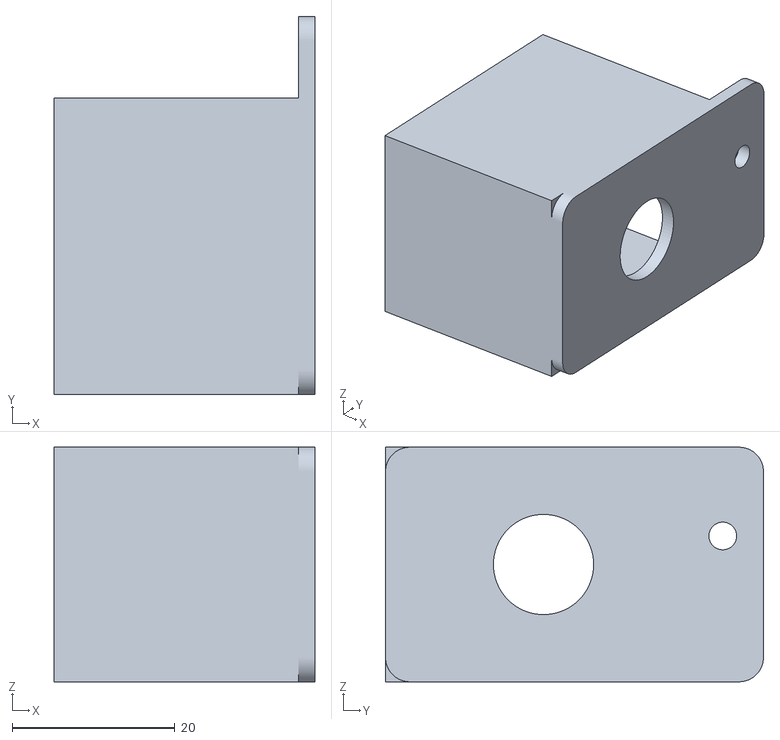
[picture p168: CAD file, 2026-11-05]
cad/microduck/_v2_backup/stl/switch_guard.stl
32.0 x 46.4 x 28.8
