HemangVora/OpenDuck/cad/microduck/_v2_backup/stl/v_buck.stl

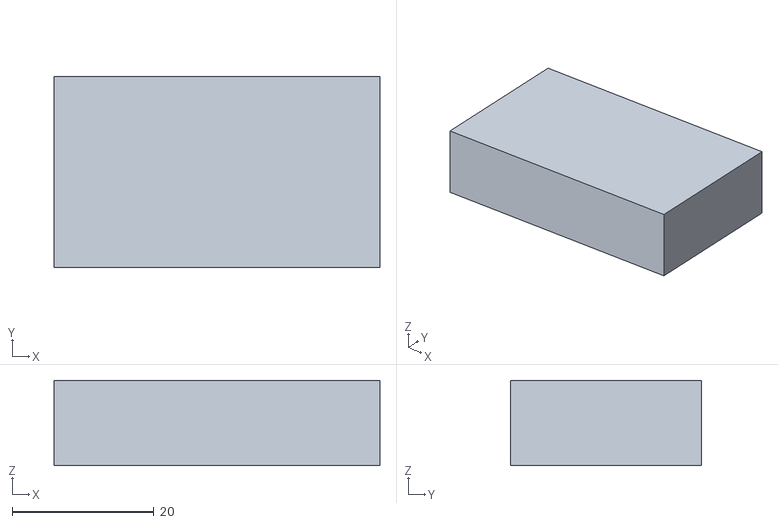
[picture p169: CAD file, 2026-11-05]
cad/microduck/_v2_backup/stl/v_buck.stl
46.0 x 27.0 x 12.0
