HemangVora/OpenDuck/cad/microduck/_v2_backup/stl/v_camera.stl

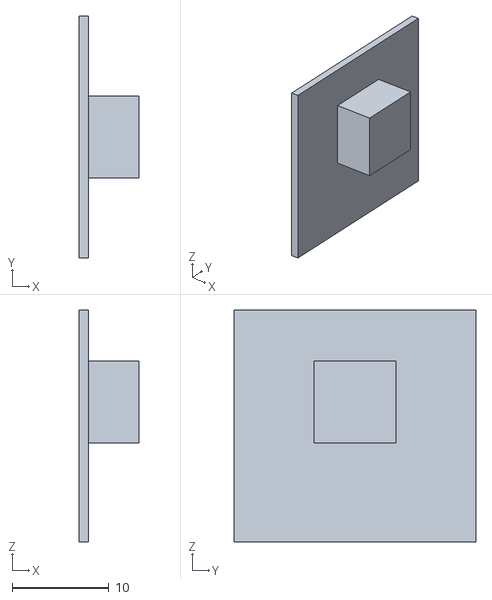
[picture p170: CAD file, 2026-11-05]
cad/microduck/_v2_backup/stl/v_camera.stl
6.20 x 25.0 x 24.0
