HemangVora/OpenDuck/cad/microduck/previews/leg_pillow.scad

color([0.95,0.94,0.9]) import("../stl/thigh_pillow_left.stl");
color([0.2,0.2,0.22]) import("/private/tmp/claude-501/-Users-hemangvora/c8a30d1f-0498-4660-9327-b47c73ee9657/scratchpad/meshwork/odm_pf/left_knee_to_ankle_left_sheet.stl");
color([0.1,0.1,0.1]) import("/private/tmp/claude-501/-Users-hemangvora/c8a30d1f-0498-4660-9327-b47c73ee9657/scratchpad/meshwork/odm_pf/servo_08.stl");
color([0.1,0.1,0.1]) import("/private/tmp/claude-501/-Users-hemangvora/c8a30d1f-0498-4660-9327-b47c73ee9657/scratchpad/meshwork/odm_pf/servo_10.stl");
color([0.3,0.3,0.32]) import("/private/tmp/claude-501/-Users-hemangvora/c8a30d1f-0498-4660-9327-b47c73ee9657/scratchpad/meshwork/odm_pf/left_roll_to_pitch.stl");
