HemangVora/OpenDuck/cad/microduck/parts/body_deck.scad

include <../md_params.scad>
include <../md_body.scad>
body_deck();
