HemangVora/OpenDuck/cad/microduck/parts/body_panel.scad

include <../md_params.scad>
include <../md_body.scad>
body_panel();
