HemangVora/OpenDuck/cad/microduck/parts/body_shell_left.scad

include <../md_params.scad>
include <../md_body.scad>
body_shell(1);
