HemangVora/OpenDuck/cad/microduck/parts/deck_clamp_rear.scad

include <../md_params.scad>
include <../md_body.scad>
deck_clamp(CLAMP_X[0]);
