HemangVora/OpenDuck/cad/microduck/parts/eye_bezel.scad

include <../md_params.scad>
include <../md_head.scad>
eye_bezel();
