HemangVora/OpenDuck/cad/microduck/parts/eye_ring.scad

include <../md_params.scad>
include <../md_head.scad>
eye_ring();
