HemangVora/OpenDuck/cad/microduck/parts/face_bill.scad

include <../md_params.scad>
include <../md_head.scad>
face_bill();
