HemangVora/OpenDuck/cad/microduck/parts/head_chassis.scad

include <../md_params.scad>
include <../md_head.scad>
head_chassis();
