HemangVora/OpenDuck/cad/microduck/parts/head_shell.scad

include <../md_params.scad>
include <../md_head.scad>
head_shell();
