HemangVora/OpenDuck/cad/microduck/parts/head_tray.scad

include <../md_params.scad>
include <../md_head.scad>
head_tray();
