HemangVora/OpenDuck/cad/microduck/parts/mouth_bill.scad

include <../md_params.scad>
include <../md_head.scad>
mouth_bill();
