HemangVora/OpenDuck/cad/microduck/parts/mouth_jaw.scad

include <../md_params.scad>
include <../md_head.scad>
mouth_jaw();
