HemangVora/OpenDuck/cad/microduck/parts/switch_guard.scad

include <../md_params.scad>
include <../md_body.scad>
switch_guard();
