HemangVora/OpenDuck/cad/microduck/parts/thigh_pillow_left.scad

include <../md_params.scad>
include <../md_leg.scad>
thigh_pillow_left();
