HemangVora/OpenDuck/cad/microduck/parts/tof_tab.scad

include <../md_params.scad>
include <../md_head.scad>
tof_tab();
