HemangVora/OpenDuck/cad/microduck/parts/v_tof.scad

include <../md_params.scad>
include <../md_head.scad>
include <../md_vitamins.scad>
v_tof();
