HemangVora/OpenDuck/cad/microduck/parts/v_xt30.scad

include <../md_params.scad>
include <../md_head.scad>
include <../md_body.scad>
include <../md_vitamins.scad>
v_xt30();
