HemangVora/OpenDuck/cad/microduck/previews/body_asm.scad

color([0.95,0.94,0.90]) import("../stl/body_shell_left.stl");
color([0.90,0.89,0.85]) import("../stl/body_shell_right.stl");
color([0.13,0.13,0.14]) import("../stl/body_panel.stl");
