HemangVora/OpenDuck/cad/microduck/previews/body_inside.scad

%color([0.95,0.94,0.90,0.2]) import("../stl/body_shell_left.stl");
color([0.95,0.94,0.90]) import("../stl/body_shell_right.stl");
color([0.2,0.45,0.85]) import("../stl/body_deck.stl");
color([0.2,0.45,0.85]) { import("../stl/deck_clamp_rear.stl"); import("../stl/deck_clamp_front.stl"); }
color([0.13,0.13,0.14]) import("../stl/body_panel.stl");
color([0.75,0.75,0.72]) { import("/private/tmp/claude-501/-Users-hemangvora/c8a30d1f-0498-4660-9327-b47c73ee9657/scratchpad/meshwork/odm_pf/trunk_top.stl"); import("/private/tmp/claude-501/-Users-hemangvora/c8a30d1f-0498-4660-9327-b47c73ee9657/scratchpad/meshwork/odm_pf/trunk_bottom.stl"); }
color([0.1,0.1,0.1]) { import("/private/tmp/claude-501/-Users-hemangvora/c8a30d1f-0498-4660-9327-b47c73ee9657/scratchpad/meshwork/odm_pf/servo_03.stl"); import("/private/tmp/claude-501/-Users-hemangvora/c8a30d1f-0498-4660-9327-b47c73ee9657/scratchpad/meshwork/odm_pf/servo_04.stl"); import("/private/tmp/claude-501/-Users-hemangvora/c8a30d1f-0498-4660-9327-b47c73ee9657/scratchpad/meshwork/odm_pf/servo_05.stl"); import("/private/tmp/claude-501/-Users-hemangvora/c8a30d1f-0498-4660-9327-b47c73ee9657/scratchpad/meshwork/odm_pf/servo_06.stl"); import("/private/tmp/claude-501/-Users-hemangvora/c8a30d1f-0498-4660-9327-b47c73ee9657/scratchpad/meshwork/odm_pf/servo_07.stl"); }
color([0.8,0.8,0.3]) { import("/private/tmp/claude-501/-Users-hemangvora/c8a30d1f-0498-4660-9327-b47c73ee9657/scratchpad/meshwork/odm_pf/neck_left_sheet.stl"); import("/private/tmp/claude-501/-Users-hemangvora/c8a30d1f-0498-4660-9327-b47c73ee9657/scratchpad/meshwork/odm_pf/neck_right_sheet.stl"); }
color([0.2,0.6,0.25]) { import("/private/tmp/claude-501/-Users-hemangvora/c8a30d1f-0498-4660-9327-b47c73ee9657/scratchpad/meshwork/odm_pf/bno055.stl"); import("../stl/v_adapter.stl"); import("../stl/v_bms.stl"); }
color([0.25,0.4,0.85]) import("../stl/v_pack.stl");
color([0.85,0.2,0.2]) import("../stl/v_switch.stl");
color([0.9,0.7,0.1]) { import("../stl/v_xt30.stl"); import("../stl/v_balance.stl"); import("../stl/v_caps.stl"); }
color([0.3,0.5,0.9]) { import("/private/tmp/claude-501/-Users-hemangvora/c8a30d1f-0498-4660-9327-b47c73ee9657/scratchpad/meshwork/odm_pf/roll_motor_top.stl"); }
