HemangVora/OpenDuck/cad/microduck/previews/chassis_view.scad

color([0.25,0.25,0.27]) import("../stl/head_chassis.stl");
color([0.85,0.4,0.2]) import("../stl/tof_tab.stl");
color([0.6,0.6,0.65]) import("/private/tmp/claude-501/-Users-hemangvora/c8a30d1f-0498-4660-9327-b47c73ee9657/scratchpad/meshwork/odm_pf/head_roll_mount.stl");
color([0.3,0.5,0.9,0.6]) import("../stl/v_radxa.stl");
