HemangVora/OpenDuck/cad/microduck/previews/head_asm.scad

color([0.95,0.94,0.90]) import("../stl/head_shell.stl");
color([0.15,0.15,0.16]) import("../stl/head_tray.stl");
color([0.25,0.22,0.20]) import("../stl/head_jaw.stl");
color([0.1,0.1,0.1]) import("../stl/eye_bezel.stl");
