HemangVora/OpenDuck/cad/microduck/previews/head_inside.scad

color([0.95,0.94,0.90,0.25]) %import("../stl/head_shell.stl");
color([0.15,0.15,0.16]) import("../stl/head_tray.stl");
color([0.45,0.3,0.2]) import("../stl/head_jaw.stl");
color([0.2,0.45,0.85]) import("../stl/head_chassis.stl");
color([0.1,0.1,0.1]) import("../stl/eye_bezel.stl");
color([0.85,0.6,0.2]) import("/private/tmp/claude-501/-Users-hemangvora/c8a30d1f-0498-4660-9327-b47c73ee9657/scratchpad/meshwork/odm_pf/head_roll_mount.stl");
color([0.3,0.3,0.3]) import("/private/tmp/claude-501/-Users-hemangvora/c8a30d1f-0498-4660-9327-b47c73ee9657/scratchpad/meshwork/odm_pf/head_yaw_to_roll.stl");
color([0.4,0.7,0.4]) import("/private/tmp/claude-501/-Users-hemangvora/c8a30d1f-0498-4660-9327-b47c73ee9657/scratchpad/meshwork/odm_pf/head_pitch_to_yaw.stl");
color([0.1,0.1,0.1]) { import("/private/tmp/claude-501/-Users-hemangvora/c8a30d1f-0498-4660-9327-b47c73ee9657/scratchpad/meshwork/odm_pf/servo_00.stl"); import("/private/tmp/claude-501/-Users-hemangvora/c8a30d1f-0498-4660-9327-b47c73ee9657/scratchpad/meshwork/odm_pf/servo_01.stl"); import("/private/tmp/claude-501/-Users-hemangvora/c8a30d1f-0498-4660-9327-b47c73ee9657/scratchpad/meshwork/odm_pf/servo_02.stl"); }
