HemangVora/OpenDuck/cad/microduck/previews/tray_view.scad

color([0.25,0.25,0.27]) import("../stl/head_tray.stl");
