HemangVora/OpenDuck/cad/microduck/_v2_backup/parts/body_deck.scad

include <../md_params.scad>
include <../md_body.scad>
body_deck();
