HemangVora/OpenDuck/cad/microduck/_v2_backup/parts/deck_clamp_front.scad

include <../md_params.scad>
include <../md_body.scad>
deck_clamp(CLAMP_X[1]);
