HemangVora/OpenDuck/cad/microduck/_v2_backup/parts/eye_bezel.scad

include <../md_params.scad>
include <../md_head.scad>
eye_bezel();
