HemangVora/OpenDuck/cad/microduck/_v2_backup/parts/head_jaw.scad

include <../md_params.scad>
include <../md_head.scad>
head_jaw();
