HemangVora/OpenDuck/cad/microduck/_v2_backup/parts/switch_guard.scad

include <../md_params.scad>
include <../md_body.scad>
switch_guard();
