HemangVora/OpenDuck/cad/microduck/_v2_backup/parts/thigh_pillow_right.scad

include <../md_params.scad>
include <../md_leg.scad>
thigh_pillow_right();
