HemangVora/OpenDuck/cad/microduck/_v2_backup/parts/v_switch.scad

include <../md_params.scad>
include <../md_head.scad>
include <../md_body.scad>
include <../md_vitamins.scad>
v_switch();
