HemangVora/OpenDuck/cad/microduck/previews/compare/ours.scad

D="../full/asm/";
color([0.96,0.95,0.92]) import(str(D,"white.stl"));
color([0.16,0.16,0.17]) import(str(D,"black.stl"));
color([0.07,0.07,0.08]) import(str(D,"servo.stl"));
color([0.10,0.10,0.11]) import(str(D,"tpu.stl"));
color([0.80,0.81,0.83]) translate([-160,-170,-0.5]) cube([320,340,0.5]);
