HemangVora/OpenDuck/cad/microduck/previews/foot/stock_foot.scad

color([0.9,0.5,0.1]) import("/Users/hemangvora/OpenDuck/upstream/Open_Duck_Mini/print/foot_top.stl");
color([0.2,0.5,0.9]) import("/Users/hemangvora/OpenDuck/upstream/Open_Duck_Mini/print/foot_side.stl");
color([0.95,0.95,0.9]) import("/Users/hemangvora/OpenDuck/upstream/Open_Duck_Mini/print/foot_bottom_pla.stl");
color([0.2,0.2,0.2]) import("/Users/hemangvora/OpenDuck/upstream/Open_Duck_Mini/print/foot_bottom_tpu.stl");
