HemangVora/OpenDuck/(list of files, cad)

Other CAD files:
print/microduck_look/oriented/md_battery_lid_c.stl
print/microduck_look/oriented/md_body_bottom.stl
print/microduck_look/3mf/10b_md_body_bottom.3mf
print/microduck_look/3mf/10d_md_body_back.3mf
print/microduck_look/oriented/md_body_top.stl
print/microduck_look/stl/md_body_front.stl
print/microduck_look/3mf/10c_md_body_front.3mf
print/microduck_look/oriented/md_body_top_c.stl
cad/microduck/_v2_backup/stl/head_tray.stl
print/microduck_look/3mf/10a_md_body_top.3mf
print/microduck_v3/oriented/layout/11d14b__sole_0.stl
print/microduck_look/oriented/md_body_back_c.stl
print/microduck_look/stl/md_battery_lid.stl
print/microduck_v3/oriented/layout/12a__0_head_jaw.stl
cad/microduck/stl/pla_sole_T1.0.stl
print/microduck_look/3mf/9a_md_head_top.3mf
print/microduck_look/oriented/md_cam_ring_c.stl
print/microduck_look/stl/md_cam_ring.stl
print/3mf/6b_head_stock.3mf
print/microduck_look/3mf/9b_md_head_tray.3mf
print/microduck_look/oriented/md_body_front.stl
cad/microduck/stl/body_shell_left.stl
print/3mf/7_head_bot_sheet.3mf
print/microduck_look/oriented/md_face_plate_c.stl
print/microduck_v3/oriented/layout/11a__0_head_shell.stl
print/microduck_look/oriented/md_head_top_c.stl
print/microduck_v3/oriented/layout/15_T2.0__sole_1.stl
cad/microduck/_v2_backup/stl/body_shell_left.stl
print/microduck_look/oriented/md_face_plate.stl
print/microduck_look/oriented/md_head_tray.stl
print/microduck_v3/oriented/foot_bottom_pla.stl
print/microduck_v3/oriented/layout/11bc__thigh_pillow_right.stl
print/microduck_look/oriented/md_battery_lid.stl
print/microduck_v3/oriented/layout/11bc__body_shell_left.stl
cad/microduck/_v2_backup/stl/head_chassis.stl
print/microduck_look/oriented/md_body_bottom_c.stl
print/microduck_v3/oriented/layout/11bc__thigh_pillow_left.stl
print/microduck_look/oriented/md_head_tray_c.stl
print/microduck_v3/oriented/layout/11d__2_mouth_bill.stl
print/microduck_look/oriented/md_head_top.stl
print/microduck_v3/oriented/layout/12b__1_face_bill.stl
print/microduck_look/oriented/md_body_back.stl
print/microduck_v3/oriented/layout/11bc__body_shell_right.stl
print/microduck_v3/oriented/layout/14b__1_foot_bottom_pla.stl
cad/microduck/stl/head_shell.stl
print/microduck_v3/oriented/layout/15_T1.5__sole_1.stl
cad/microduck/_v2_backup/stl/thigh_pillow_right.stl
cad/microduck/stl/head_chassis.stl
print/microduck_v3/oriented/layout/12a__1_head_tray.stl
cad/microduck/_v2_backup/md_head.scad
cad/microduck/_v2_backup/md_vitamins.scad
cad/microduck/previews/full/duck_crouch.scad
cad/microduck/_v2_backup/stl/deck_clamp_front.stl
cad/microduck/_v2_backup/stl/head_shell.stl
cad/microduck/_v2_backup/stl/tof_tab.stl
cad/microduck/previews/full/head_close.scad
cad/microduck/previews/v3/duck_v3.scad
cad/microduck/previews/v3/head_v3.scad
cad/microduck/previews/v3/head_v3_open.scad
cad/microduck/stl/deck_clamp_front.stl
cad/microduck/stl/mouth_jaw.stl
cad/microduck/stl/pla_sole_T1.5.stl
cad/microduck/stl/pla_sole_T2.0.stl
cad/microduck/stl/thigh_pillow_right.stl
cad/microduck/stl/tof_tab.stl
cad/microduck/stl/v_tof.stl
print/microduck_v2/3mf/11a_head_shell_white.3mf
print/microduck_v2/3mf/11b_body_shells_white.3mf
print/microduck_v2/3mf/12a_head_tray_jaw_black.3mf
print/microduck_v2/3mf/12b_head_chassis_black.3mf
print/microduck_v2/oriented/body_deck.stl
print/microduck_v2/oriented/body_panel.stl
print/microduck_v2/oriented/body_shell_left.stl
print/microduck_v2/oriented/body_shell_right.stl
print/microduck_v2/oriented/eye_bezel.stl
print/microduck_v2/oriented/head_chassis.stl
print/microduck_v2/oriented/head_jaw.stl
print/microduck_v2/oriented/head_shell.stl
print/microduck_v2/oriented/head_tray.stl
print/microduck_v2/oriented/layout/11a__head_shell.stl
print/microduck_v2/oriented/layout/11c__thigh_pillow_left.stl
print/microduck_v2/oriented/layout/11c__thigh_pillow_right.stl
print/microduck_v2/oriented/layout/12a__head_jaw.stl
print/microduck_v2/oriented/layout/12a__head_tray.stl
print/microduck_v2/oriented/layout/12b__eye_bezel.stl
print/microduck_v2/oriented/layout/12b__tof_tab.stl
print/microduck_v2/oriented/layout/12c__body_deck.stl
print/microduck_v2/oriented/layout/12c__body_panel.stl
print/microduck_v2/oriented/layout/12c__deck_clamp_front.stl
print/microduck_v2/oriented/layout/12c__deck_clamp_rear.stl
print/microduck_v2/oriented/layout/12c__switch_guard.stl
print/microduck_v2/oriented/switch_guard.stl
print/microduck_v2/oriented/thigh_pillow_left.stl
print/microduck_v2/oriented/thigh_pillow_right.stl
print/microduck_v2/oriented/tof_tab.stl
print/microduck_v3/oriented/body_deck.stl
print/microduck_v3/oriented/body_panel.stl
print/microduck_v3/oriented/body_shell_left.stl
print/microduck_v3/oriented/body_shell_right.stl
print/microduck_v3/oriented/deck_clamp_front.stl
print/microduck_v3/oriented/deck_clamp_rear.stl
print/microduck_v3/oriented/eye_ring.stl
print/microduck_v3/oriented/face_bill.stl
print/microduck_v3/oriented/head_chassis.stl
print/microduck_v3/oriented/head_jaw.stl
print/microduck_v3/oriented/head_shell.stl
print/microduck_v3/oriented/head_tray.stl
print/microduck_v3/oriented/layout/11d14b__0_eye_ring.stl
print/microduck_v3/oriented/layout/11d14b__2_mouth_bill.stl
print/microduck_v3/oriented/layout/11d__0_eye_ring.stl
print/microduck_v3/oriented/layout/14a__0_md_foot_top.stl
print/microduck_v3/oriented/layout/14a__1_md_foot_top.stl
print/microduck_v3/oriented/layout/14a__2_md_foot_side.stl
print/microduck_v3/oriented/layout/14a__3_md_foot_side.stl
print/microduck_v3/oriented/layout/14b__0_foot_bottom_pla.stl
print/microduck_v3/oriented/layout/15_T1.0__sole_0.stl
print/microduck_v3/oriented/layout/st__0_foot_top.stl
print/microduck_v3/oriented/layout/st__1_foot_top.stl
print/microduck_v3/oriented/layout/st__3_foot_side.stl
print/microduck_v3/oriented/md_foot_side.stl
print/microduck_v3/oriented/md_foot_top.stl
print/microduck_v3/oriented/mouth_bill.stl
print/microduck_v3/oriented/mouth_jaw.stl
print/microduck_v3/oriented/switch_guard.stl
print/microduck_v3/oriented/thigh_pillow_left.stl
print/microduck_v3/oriented/thigh_pillow_right.stl
