HemangVora/OpenDuck/docs/microduck_look/assembled/duck_back.png

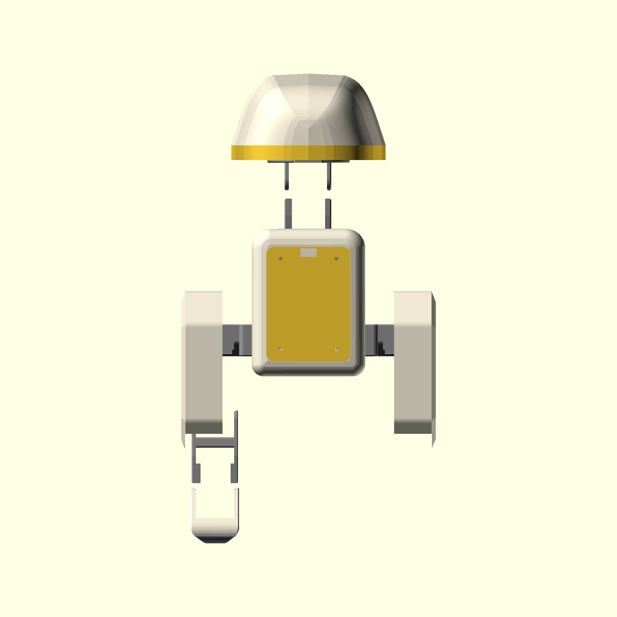
docs/microduck_look/assembled/duck_back.png
