HemangVora/OpenDuck/docs/microduck_look/assembled/duck_iso_back.png

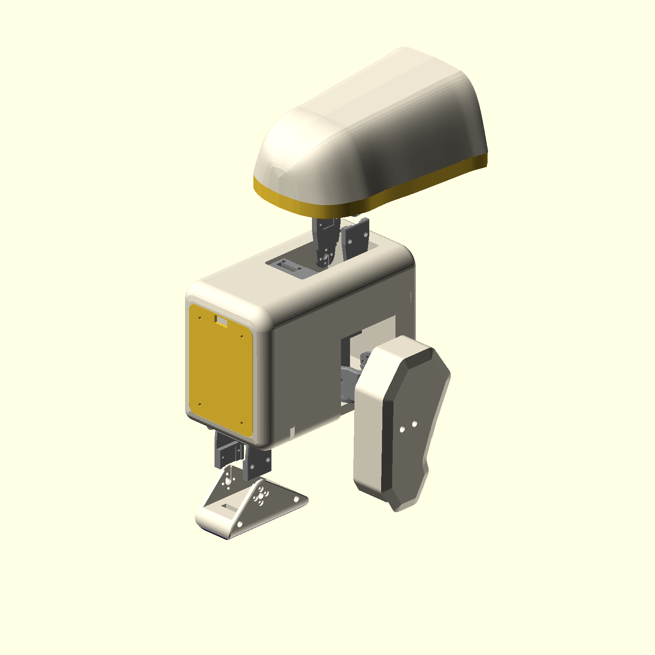
docs/microduck_look/assembled/duck_iso_back.png
