HemangVora/OpenDuck/docs/microduck_look/assembled/duck_persp.png

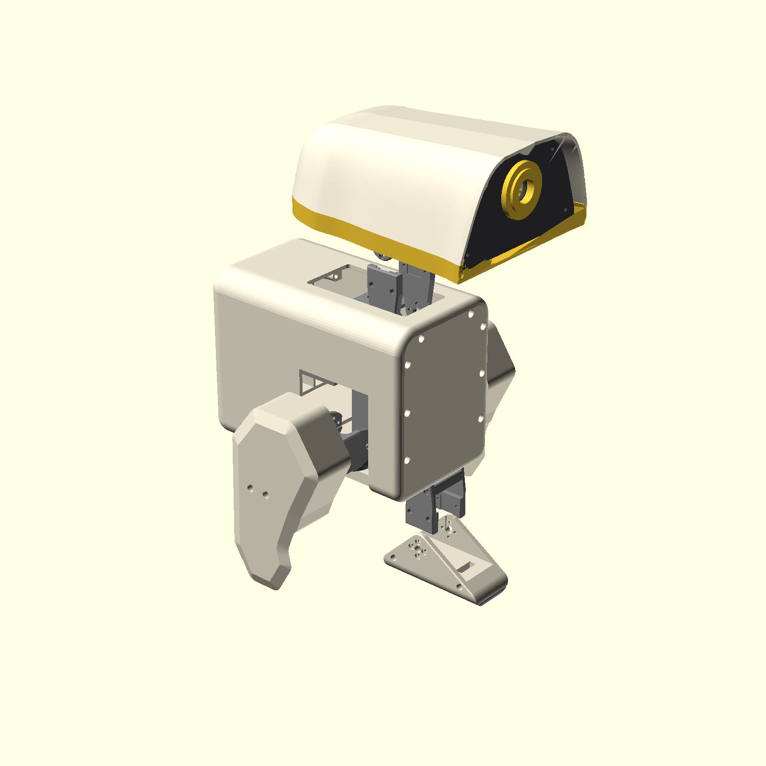
docs/microduck_look/assembled/duck_persp.png
