HemangVora/OpenDuck/docs/microduck_look/assembled/newparts_back.png

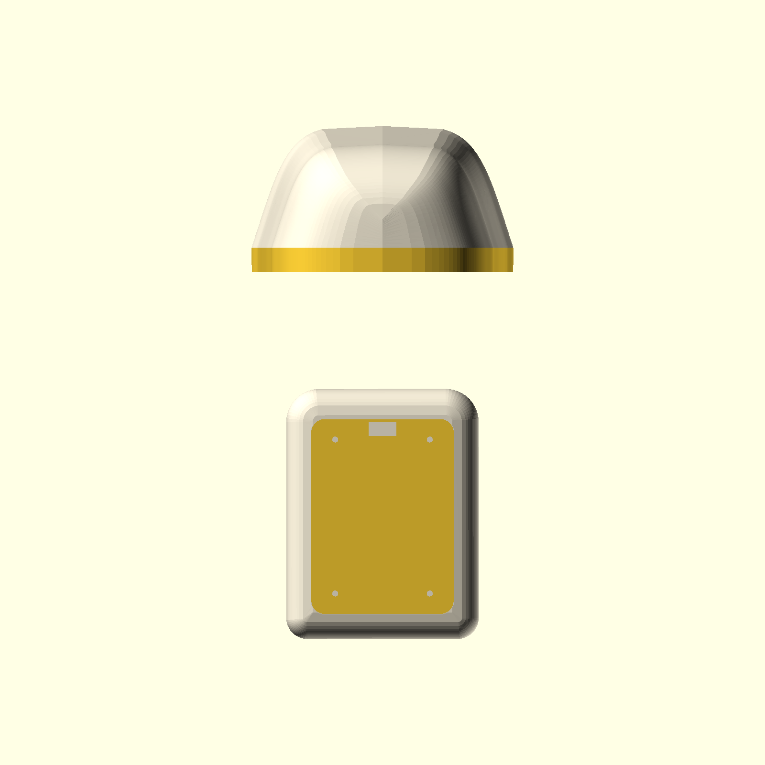
docs/microduck_look/assembled/newparts_back.png
