HemangVora/OpenDuck/docs/microduck_look/assembled/newparts_exploded.png

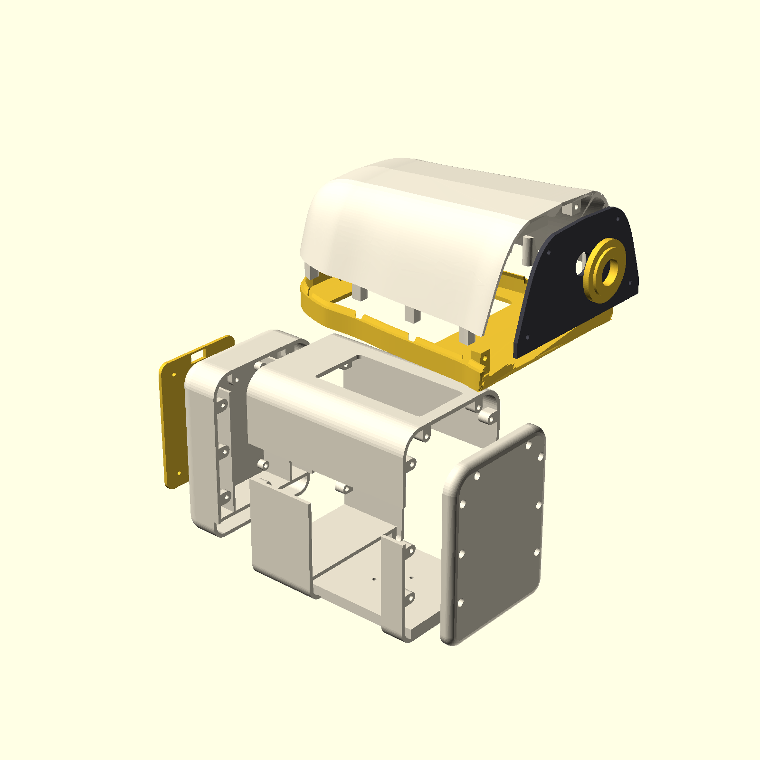
docs/microduck_look/assembled/newparts_exploded.png
