HemangVora/OpenDuck/docs/microduck_look/assembled/newparts_persp.png

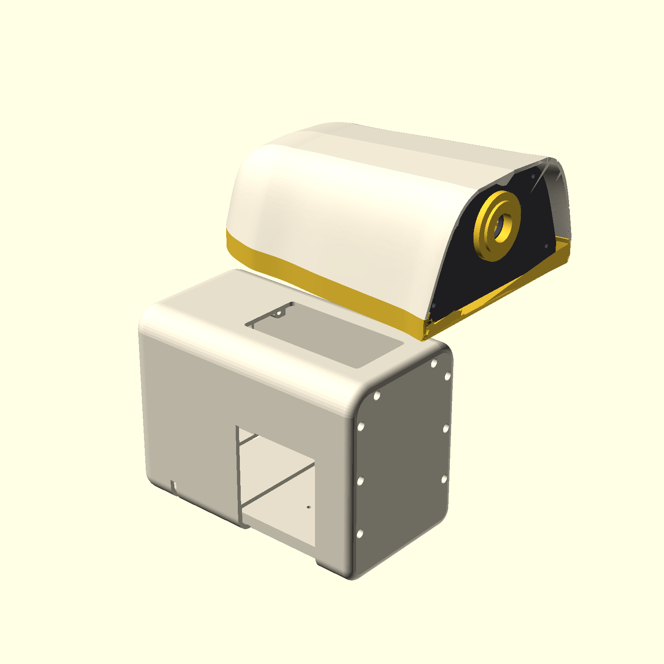
docs/microduck_look/assembled/newparts_persp.png
