HemangVora/OpenDuck/docs/microduck_look/assembled/newparts_side.png

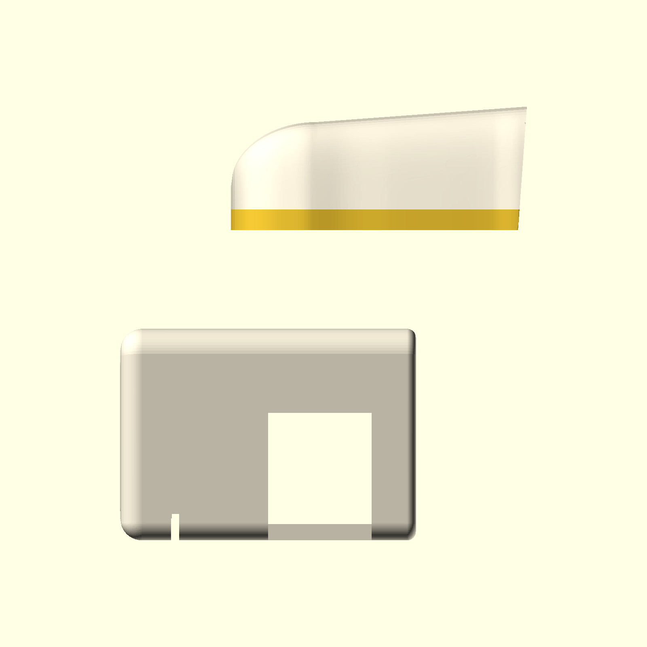
docs/microduck_look/assembled/newparts_side.png
