HemangVora/OpenDuck/(commit log)

2026-11-05 Bambu profiles and stock Open Duck Mini v2 plates
    Claude-Session: https://claude.ai/code/session_01CxZCESV5Rjv9DvypepAgXb
    [0_test_bracket.3mf, 1_feet_orange.3mf, 2a_leg_brackets.3mf, 2b_leg_caches.3mf, 3_trunk.3mf, 4_body_stock.3mf, 5_body_front.3mf, 6a_head_small.3mf]
2026-11-05 Microduck-look v1 and v2 print plates
    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
    [10a_md_body_top.3mf, 10b_md_body_bottom.3mf, 10c_md_body_front.3mf, 10d_md_body_back.3mf, 10e_md_battery_lid.3mf, 11a__head_shell.stl, 11a_head_shell_white.3mf, 11b__body_shell_left.stl]
2026-11-05 Microduck v3 print plates
    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
    [11a__0_head_shell.stl, 11a_head_shell_white.3mf, 11b_body_shells_white.3mf, 11bc__body_shell_left.stl, 11bc__body_shell_right.stl, 11bc__thigh_pillow_left.stl, 11bc__thigh_pillow_right.stl, 11bc_body_shells_pillows_white.3mf]
2026-11-05 Microduck CAD: OpenSCAD, feet, soles, STLs and checks
    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
    [black.stl, body_asm.scad, body_deck.scad, body_deck.stl, body_inside.scad, body_panel.scad, body_panel.stl, body_shell_left.scad]
